michaelk99/IHP__MPC9724/ip/dsm2_core/doc/ota_fcasc2_README.md

# ihp-sg13cmos5l Fully Differential Folded Cascode OTA, Unit-Device Version

A fully differential folded cascode OTA with a PMOS input pair for the switched-capacitor integrator of the first-order delta-sigma battery monitor (1.5 V, 1.45 to 1.55 V, `fs = 1.024 MHz`, OSR 512, -40 to 125 °C). It is sized to the system-level design point (`C1 = 64 fF`, `C2 = 384 fF`, fanout 2), with every branch current an integer multiple of the 200 nA bias input and every device built from unit devices, so the layout can be drawn as unit arrays.

`ota_fcasc2` is a sibling of [`ota_fcasc_fd`](../ota_fcasc_fd/README.md), which keeps its older sizing (tail 800 nA, `L = 5 µm` bias stacks) because its layout is drawn by hand. The port list, the symbol and the split into blocks are the same, so `ota_fcasc2_top` is a drop-in replacement and the floorplan of the old layout maps onto it block by block. The layout is generated by a script, see [Layout](#layout).

The common-mode feedback is external: `vfb` drives the NMOS sinks and `vbn` brings out the matching bias voltage, so tying `vfb` to `vbn` biases the OTA open loop, as the testbenches do. `di_ena` switches the bias off.

| Pin | Direction | Function |
| --- | --- | --- |
| `vdd`, `vss` | inout | 1.5 V supply |
| `vi_p`, `vi_n` | input | differential input |
| `voutp`, `voutn` | output | differential output |
| `vfb` | input | common-mode feedback, gate of the NMOS sinks |
| `vbn` | output | NMOS sink bias voltage, tie to `vfb` for open-loop biasing |
| `ibias_200n` | input | 200 nA bias current sunk by the OTA, about 0.61 V at the pin |
| `di_ena` | input | enable, active high, edges of at least 30 ns at this pin |

| Cell | Content |
| --- | --- |
| `ota_fcasc2_top` | Top cell: the four blocks below plus ten `cap_dec` |
| `ota_fcasc2_dp` | PMOS input pair with its dummies |
| `ota_fcasc2_pbiascasc` | PMOS tail and loads with their cascodes, the wide-swing PMOS bias, enable switches |
| `ota_fcasc2_nbiascasc` | NMOS sinks (driven by `vfb`) and folded cascodes, the NMOS bias diodes, the sink of the PMOS reference, enable switches |
| `ota_fcasc2_ena` | Enable inverters, `d_ena` and `d_ena_b` from `di_ena` |
| `cap_dec` | Thick-oxide PMOS decoupling capacitor between `vdd` and `vss` |

## Topology

- **Input pair** `MP1`/`MP2`, 600 nA each, bulk on the tail node.
- **Tail** `MP3` with the cascode `MP10`, 1.2 µA. `ota_fcasc_fd` has no tail cascode. Here it keeps the tail current at the mirror ratio: the wide-swing bias puts the reference `MP8` at a small `V_SD`, and an uncascoded tail at 0.4 V would carry 6 % more.
- **PMOS loads** `MP4`/`MP5` with the cascodes `MP6`/`MP7`, 1.0 µA each.
- **NMOS sinks** `MN1`/`MN2` (1.6 µA each, gate `vfb`) take the pair current plus the output branch, the folded cascodes `MN3`/`MN4` carry 1.0 µA each.
- **NMOS bias**: the 200 nA input flows through the pass switch `MNSW5` into the stacked diodes `MN6` over `MN5`, which give `vcn` and `vbn`. The sinks then sit at `V_DS = V_GS(MN5)`, about 0.3 V. For LV NMOS at `gm/ID = 18` that is only 0.15 V above `V_dsat` plus margin, the lowest output is then about 0.4 V, and the modulator needs 0.505 V. The diode stack is kept: it needs no resistor, starts without help, and the larger `V_DS` raises the sink output resistance, which sets the gain.
- **PMOS bias, wide swing**: `MN7`/`MN8` sink a 200 nA copy from `MP8`/`MP9`. A stacked PMOS diode would put the load sources at `V_SD = V_SG`, about 0.4 V, and cap the output at about 1.0 V, exactly the 1.0 V the modulator swings to at 1.5 V, and below it at 1.45 V or in the slow corner. So `MPR`, a long PMOS in triode (`W = 0.5 µm`, `L = 10 µm`, gate on `d_ena_b`), drops about 60 mV between `vbp` and `vcp`, and the sources sit at about 0.1 V. `MPR` is off when disabled, so it is also the enable switch of that branch.
- **Enable**: `MNSW1`/`MNSW3`/`MNSW4` pull `vfb`, `vcn` and `vbn` to `vss`, `MPSW3`/`MPSW4` pull `vbp` and `vcp` to `vdd`, `MNSW5` and `MPR` open the two reference branches.
- **`di_ena` edges**: `di_ena` needs edges of at least 30 ns at the OTA pin. In the whole-OTA start-up bench (30 runs, sim) 3 ns edges take `MPEN0`, `MNEN0` and `MNEN1` to Vds 1.62 V and 1 ns edges to 1.69 V, with the gate oxide of several devices over 1.65 V. 10 ns edges stay below the 1.6 V Vds limit, 30 ns leaves a margin.
- **`MNC7` on `vd7`**: one NMOS unit (0.5/3) with its gate on `vd7` and source, drain and bulk on `vss`. While the OTA is off, `vcp` sits at `vdd` and `MN7`, `MN8` are off, so `vd7` floats and the enable edges kick it below `vss`. Without the cap `MN8` reached Vds 1.66 V in 14 of 30 start-up runs, over the 1.6 V limit (sim). With it the peak is 1.553 V and no LV device of the OTA exceeds 1.6 V Vds or 1.65 V gate oxide in the same 30 runs (peaks 1.593 V Vds on `MNEN1`, 1.615 V gate-drain on `MN8`, sim). In the layout it is a unit of R2, next to MN7.
- **Folding headroom**: `I_fold/I_tail` = 1.6/1.2 = 1.33, above the 1.2 guideline. The system-level design point sizes the output branch at `Id1`, which gives 1.0.

## Sizing

`scripts/sizing/size_ota_fcasc2.py` derives the system-level design point (settling budget, input pair, cascode stack, bias, power) from the 1 mV LSB on 1.5 V, OSR 512 and `H_inf` 1.2 loop with pygmid and the CMOS5L tables in `../ota_fcasc_fd/scripts/sizing/data/`, then evaluates the unit-device point and prints every device and every branch current. It needs `pygmid`, `numpy` and `deltasigma` (package `python-deltasigma`):

```sh
python macros/ota_fcasc2/scripts/sizing/size_ota_fcasc2.py              # the design
python macros/ota_fcasc2/scripts/sizing/size_ota_fcasc2.py --point current  # the sizing before the equal-L rule
python macros/ota_fcasc2/scripts/sizing/size_ota_fcasc2.py --compare    # model table of the equal-L candidates
```

The system-level leaky-integrator sweep is not rerun, its result (50 dB integrator gain) is taken as an input.

Every NMOS has the same L and every PMOS has the same L, so the layout can place each type as one array with straight columns. The input pair and `MPR` are the two exceptions. Unit devices, all `ng = 1`:

| Type | W (µm) | L (µm) | Current per unit | gm/ID (model) | Used by |
| --- | --- | --- | --- | --- | --- |
| NMOS, every device | 0.5 | 3 | 200 nA | 19.2 sources, 20.0 cascodes | `MN1` to `MN8`, `MNSW1`, `MNSW3`, `MNSW4`, `MNSW5`, `MND1`, `MND2`, `MNC7`, `MNEN0`, `MNEN1` |
| PMOS source | 1.0 | 2 | 200 nA | 17.9 | `MP3`, `MP4`, `MP5`, `MP8`, `MPSW3`, `MPD2`, `MPEN0`, `MPEN1` |
| PMOS cascode | 3.5 | 2 | 200 nA | 26.0 | `MP6`, `MP7`, `MP9`, `MP10`, `MPSW4`, `MPD3` |
| Input pair | 2.0 | 1 | 150 nA | 25.2 | `MP1`, `MP2`, `MPD1` |
| PMOS level shift | 0.5 | 10 | 200 nA | triode | `MPR` |

The common L was chosen in simulation, not from the model: the CMOS5L tables have L = 1, 5 and 10 µm only, so every lookup at 2, 3 or 4 µm is interpolated. Each candidate ran a 10-point worst-case screen with `bias_gm` as the reference, and the finalists ran the full 135-point sweep (see [Simulation Results](#simulation-results)). Worst case over the screen (over the 135-point sweep for the first and the chosen row), PMOS at 1/2 and 3.5/2, pair 2/1:

| NMOS units | A0 (dB) | tau (ns) | err_d (%) | swing (V) | PM (°) | Verdict |
| --- | --- | --- | --- | --- | --- | --- |
| sources 0.5/4, cascodes 1/2 (before) | 54.10 | 22.9 | 0.27 | 1.16 | 78.9 | two L per type |
| all 0.5/2 | 51.58 | 23.6 | 0.36 | 0 | 79.9 | fails gain at ff, 125 °C |
| sources 0.5/3, cascodes 1/3 | 53.57 | 21.0 | 0.29 | 1.15 | 73.0 | passes, two W |
| all 0.5/3 | 54.30 | 21.4 | 0.26 | 1.07 | 74.8 | chosen |
| sources 0.5/4, cascodes 1/4 | 55.47 | 17.5 | 0.23 | 1.10 | 65.7 | PM drops, cascode capacitance at the folding node |
| all 0.5/4 | 56.17 | 18.8 | 0.21 | 0.99 | 69.1 | swing at the limit |

On the PMOS side the cascode W is what matters, its L is already the source L. With every NMOS at 0.5/3, a cascode of 1/2 instead of 3.5/2 costs 1.8 dB of gain and the swing falls to 0.89 V, 2/2 costs 0.45 dB. PMOS at L = 1 µm (sources 0.5/1, cascodes 2/1) meets every limit over the 135-point sweep with the same margins as L = 2, needs no exception for the pair and would cut the PMOS gate area from 210.5 to 77.5 µm², but raises the bench noise from 923 to 1004 µVrms and the offset spread from 3.3 to 4.0 mV (40 runs), so the PMOS stay at L = 2. These noise numbers come from the earlier noise bench, whose noisy feedback resistors are in them and which is not comparable with the 416.5 µVrms of [Simulation Results](#simulation-results). The screen was not repeated. The pair at L = 2 µm (2/2) costs settling: tau worst case 29.7 ns against 30.5, swing 1.03 V, and the bench noise does not improve (945 µVrms), so the pair stays at `W = 2 µm`, `L = 1 µm`.

`MPR` works as a resistor, its L sets the drop. It is one device at `L = 10 µm`, the longest L the project allows. At 0.5/13 it dropped 82 mV and the PMOS sources sat at `V_SD` 0.121 V, at 0.5/10 it drops 62 mV and they sit at 0.105 V (sim, tt, 27 °C, 1.5 V). The gain at tt falls by 0.5 dB and every limit still holds, see [Simulation Results](#simulation-results).

| Device | Units | Current | Device | Units | Current |
| --- | --- | --- | --- | --- | --- |
| `MP1`, `MP2` | 4 each | 600 nA | `MN1`, `MN2` | 8 each | 1.6 µA |
| `MP3`, `MP10` | 6 each | 1.2 µA | `MN3`, `MN4` | 5 each | 1.0 µA |
| `MP4`, `MP5`, `MP6`, `MP7` | 5 each | 1.0 µA | `MN5`, `MN6` | 1 each | 200 nA (input) |
| `MP8`, `MP9`, `MPR` | 1 each | 200 nA | `MN7`, `MN8` | 1 each | 200 nA |
| `MPSW3`, `MPSW4` | 1 each | off | `MNSW1`, `MNSW3`, `MNSW4` | 1 each | off |
| `MPD1` | 2 | dummies | `MNSW5` | 1 | 200 nA (pass) |
| `MPD2`, `MPD3` | 48, 4 | dummies and bias decaps | `MND1`, `MND2` | 20, 27 | dummies and bias decaps |
| | | | `MNC7` | 1 | cap on `vd7` |
| `MPEN0`, `MPEN1` | 1 each | enable inverters | `MNEN0`, `MNEN1` | 1 each | enable inverters |

The dummies sit at the row ends and in the dummy rows around each array (see [Layout](#layout)), `MPD1` off on the tail node, the others with their gate on a bias line (`MPD2` vbp, `MPD3` vcp, `MND1` vbn, `MND2` vcn), so they also decouple it.

Summed gate area (`W·L`) per block, from the sizing script: `dp` 20 µm², `pbiascasc` 291 µm², `nbiascasc` 123 µm², `ena` 7 µm², `cap_dec` 10 × 4 µm² (HV). Per type: NMOS 126 µm² in 84 units of one size, PMOS 315 µm² (`MPR` 5 µm² and the pair 20 µm² included) in 2 sizes of L = 2 µm plus the pair and `MPR`. Of that, the dummies are 128 µm² of PMOS and 70.5 µm² of NMOS.

System-level point against the unit-device point (both gm/ID model numbers, from the script):

| | System level | Unit devices |
| --- | --- | --- |
| `Id1` | 631 nA | 600 nA |
| `I_tail` | 1.26 µA | 1.2 µA |
| Output branch | 631 nA | 1.0 µA |
| `I_fold/I_tail` | 1.0 | 1.33 |
| `beta` | 0.820 | 0.786 |
| `tau` | 15.3 ns | 17.7 ns |
| `A0` | 54.8 dB | 55.3 dB |
| Swing estimate (diff, pp) | 1.84 V | 1.60 V |
| Supply current | 3.15 µA | 3.40 µA, plus the 200 nA input |
| Power | 4.73 µW | 5.10 µW, plus 0.30 µW for the input |

Two notes on the system-level numbers:

- The system-level design evaluates `beta` at the target `wug`, before `gm_scale = 2` doubles the pair. With the `Cgg1` of the pair it actually sizes (41 fF), `beta` is 0.785, not 0.820, and `tau` is 17.7 ns rather than 15.3 ns. The settling testbench measures 0.785 and 16.2 ns.
- The OTA gain requirement is 51.7 dB, 50 dB of integrator gain over `beta` = 0.820, as the code computes. The system-level specification table says 53.3 dB with `beta` = 0.69, a leftover of the old capacitors. With the real `beta` of 0.785 the requirement would be 52.1 dB.

## Simulation Results

All numbers below are sanity checks of the schematic with ideal common-mode feedback and an ideal 200 nA source, not characterisation results.

Standalone testbenches at `tt`, 27 °C, 1.5 V, 200 nA, one run each (`make sim-xschem`):

| Testbench | Results |
| --- | --- |
| `ota_fcasc2_top_tb_tran` | `dcgain_dB` 58.27 dB, `tau_meas_ns` 16.29 ns, `err_d_percent` 0.170 %, `beta_meas` 0.785 (`Cgg1` 41.3 fF), swing 1.42 V, `I_fold/I_tail` 1.32, starved cascode back above half its current after 19 ns, power 5.40 µW with the input |
| `ota_fcasc2_top_tb_ac_ol` | `Adc_ol_dB` 58.84 dB, `UGB` 11.7 MHz with `CL + (1-beta)·C2` as load, `PM` 76.6° |
| `ota_fcasc2_top_tb_noise` | over 1 Hz to 1 kHz: `irn_tot_uVrms` 410.4 µVrms (closed-loop bench input, kT/C included), `vn_d_uVrms` 50.32 µVrms (open-loop differential input noise of the OTA, no kT/C) |

These include the dummy rows of 2026-10-19 (gates on vbp, vcn and vbn). Against the earlier dummy counts on the same image, tau moves from 16.23 to 16.29 ns, the cascode starvation from 18 to 19 ns and the power from 5.42 to 5.40 µW. The dummy gates' leakage onto the bias lines lowers the tail and fold currents by about 0.3 % (1.206 to 1.201 µA, 1.595 to 1.591 µA, sim), which is the likely cause (inference).

The bench's DC-feedback resistors R4 to R7 (1 GOhm and 6 GOhm) are `res_noisy` instances with `noisy=0`. As plain `res` instances they put their own thermal noise into the bench, which then read 923 µVrms.

`irn_tot` is the closed-loop bench number and measures neither the OTA alone nor the integrator. Of its 410.4 µVrms (the same with and without the dummy rows), flicker is 363 µVrms, the gate leakage shot noise of the input pair into the 1 GOhm resistors 190 µVrms and thermal noise 19 µVrms (sim, `make sim-xschem TB=ota_fcasc2_top_tb_noise`, report `plot_simulations/data/ota_fcasc2_top_tb_noise_closed_loop_summary.txt`). `vn_d_uVrms` is the figure for the integrator. It is the open-loop differential input noise of the OTA in the same band, from the same netlist with C1 set to 1 F so that both gates are ac grounded (the report is `..._vn_d_summary.txt`). It is flicker dominated and splits evenly over the pair (21.0 µVrms each), the NMOS sinks (20.3) and the PMOS loads (20.3), every other device is below 1 µVrms. The integrator refers it to its input with 1/2, which gives 25.2 µVrms. The `sc_int2` pnoise read 26.6 µVrms for the OTA with the earlier 0.5/13 `MPR`, it was not rerun. The 288.7 µVrms budget less the switches' 10.6 µVrms allows `vn_d` up to 577 µVrms with that referral (model), the worst PVT corner reads 63.0 µVrms (sim), a margin of 19 dB. The 290 µVrms limit on `irn` is the continuous-time map of the bench number and fails by design.

Operating point at the same conditions, before the dummy rows (not rerun, the branch currents have moved by 0.3 % since): `vbn` 0.285 V, `vcn` 0.605 V, `ibias_200n` 0.611 V, sinks at `V_DS` 0.29 V, PMOS sources at `V_SD` 0.105 V, `MPR` drop 62 mV. Simulated gm/ID: input pair 25.4, NMOS sinks 17.1, NMOS cascodes 17.2, PMOS sources 15.4 (at the edge of saturation, `V_SD` 0.105 V against `V_dsat` 0.136 V), PMOS cascodes 23.2.

CACE (`make sim-cace`, last run as the noise and tran sets with one job, `cace ota_fcasc2_top.yaml -j 1 -p ...`), 45 PVT conditions per set (5 corners, 3 supplies, 3 temperatures), min / typical / max. All 45 runs of each transient and noise set are measured (45 data files each, no tau or swing fallback value):

| Result | Limit | Schematic |
| --- | --- | --- |
| A0 | ≥ 51.73 dB | 53.44 / 58.27 / 60.29 dB |
| Settling error at `Ts/2` | ≤ 0.32 % | 0.136 / 0.171 / 0.284 % |
| Tau | ≤ 30.5 ns | 13.0 / 16.3 / 23.8 ns |
| Output swing | ≥ 0.98 V | 1.20 / 1.41 / 1.61 V |
| Power | ≤ 10 µW | 4.74 / 5.40 / 5.61 µW |
| IRN | ≤ 290 µVrms | 329.3 / 410.4 / 631.0 µVrms, fails |
| Vn,d | any | 40.5 / 50.3 / 63.0 µVrms |

The PEX rows come from the extracted layout and are listed in [Layout](#layout).

Local mismatch, 100 runs at `tt_mismatch`, 27 °C, 1.5 V, all measured, before the dummy rows (not rerun): A0 57.1 to 59.2 dB, offset -8.7 to 6.3 mV, tau 13.5 to 19.4 ns, swing 1.37 to 1.45 V. The settling error reaches 4.3 % because it carries the offset. In a separate 40-run set with the same seeds for both sizings the offset standard deviation is 3.3 mV, against 2.8 mV with the 0.5/4 sinks of the earlier sizing. The sinks have a quarter less gate area.

Bias current spread of the reference, standalone testbenches at `tt`, 27 °C, 1.5 V, before the dummy rows (not rerun, the 200 nA column is the old version of the table above):

| `ibias_200n` | 136 nA (0.68x) | 200 nA | 308 nA (1.54x) |
| --- | --- | --- | --- |
| `dcgain_dB` (tran) | 57.66 dB | 58.27 dB | 59.10 dB |
| `Adc_ol_dB` (ac) | 58.38 dB | 58.85 dB | 59.57 dB |
| `UGB`, `PM` | 8.5 MHz, 78.6° | 11.7 MHz, 76.6° | 16.4 MHz, 74.3° |
| `tau_meas_ns` | 22.8 ns | 16.2 ns | 11.3 ns |
| `err_d_percent` | 0.179 % | 0.170 % | 0.158 % |
| Swing | 1.53 V | 1.42 V | 1.28 V |
| Cascode starvation | 24 ns | 18 ns | 13 ns |
| Power with the input | 3.69 µW | 5.42 µW | 8.33 µW |
| IRN | 408.7 µVrms | 410.4 µVrms | 416.2 µVrms |
| Vn,d | 50.7 µVrms | 50.3 µVrms | 50.3 µVrms |

All nine runs converged without help.

At 0.68x and 1.45 V over the five corners and three temperatures (15 runs, all measured, before the dummy rows), 125 °C is the weak spot: tau is 30.6 to 35.5 ns, above the 30.5 ns budget, and at `ff` the gain falls to 51.07 dB, below 51.73 dB, so the swing criterion is never met there (reported as 0). The settling error at `Ts/2` stays at or below 0.37 %, since 35 ns is still 14 time constants in `Ts/2`. A constant-gm reference does not deliver 0.68x at 125 °C, see below.

With `bias_gm` (`ota_fcasc2_top_tb_biasgm`, `scripts/sweep_biasgm.py`), sanity checks like the rest: the bench is `tb_tran` with the ideal source replaced by the constant-gm reference, `di_ena` and VDD shared with the OTA, and the power now includes `bias_gm`. The numbers below use the `bias_gm` schematic of commit 62fca54, `MPR` at 0.5/10 and the dummy counts before 2026-10-19 (not rerun). With `bias_gm` as committed in 24cfc4c and the dummy rows, the bench gives tau 16.74 ns at tt, 27 °C, 1.5 V (16.69 ns with the earlier dummy counts, sim). The sweep is 5 MOS corners x 3 rppd corners x -40/27/125 °C x 1.45/1.5/1.55 V, 135 runs, plus an open-loop ac run with `bias_gm` at every condition for the phase margin. All 135 transient runs are measured without a convergence aid, five ac runs needed `rshunt` to leave a half-started reference. All limits hold in every run:

| Result | Limit | Worst | At | Typical (tt, typ, 27 °C, 1.5 V) |
| --- | --- | --- | --- | --- |
| A0 | ≥ 51.73 dB | 53.54 dB | ff, wcs, 125 °C, 1.45 V | 58.19 dB |
| Tau | ≤ 30.5 ns | 23.3 ns | ff, wcs, 125 °C, 1.45 V | 16.87 ns |
| Settling error at `Ts/2` | ≤ 0.32 % | 0.284 % | ff, wcs, 125 °C, 1.45 V | 0.172 % |
| Output swing | ≥ 0.98 V | 1.076 V | ss, bcs, 125 °C, 1.45 V | 1.43 V |
| Power with `bias_gm` | ≤ 10 µW | 9.76 µW | ss, bcs, 125 °C, 1.55 V | 6.00 µW |
| Phase margin (open loop) | | 74.9° | sf, bcs, 125 °C, 1.55 V | 76.8° |

The reference current into the OTA is 123.7 to 305.6 nA (0.62x to 1.53x) and the bias pin sits at 0.377 to 0.789 V. The current rises with temperature (123.7 to 194.7 nA at -40 °C, 203.2 to 305.6 nA at 125 °C), so the 0.68x at 125 °C case of the ideal-source test does not occur, and tau is 13.3 to 19.6 ns at -40 °C, 14.0 to 20.2 ns at 27 °C and 14.7 to 23.3 ns at 125 °C. Power has the smallest margin, 9.76 µW is 98 % of the limit with 305 nA from the reference, and the lowest swing, 1.08 V, is at the same corner and 1.45 V. With `MPR` at 0.5/13 and the same `bias_gm` the worst A0 is 53.86 dB and the worst settling error 0.275 %, the other worst cases agree within 0.05 ns, 1 mV, 0.01 µW and 0.1°.

Enable sequencing, 7 corners, VDD ramped over 100 µs with `di_ena` low and `di_ena` raised at 200 µs, input steps every 5 µs after it, with `bias_gm` as committed in 24cfc4c and the dummy rows. The reference leaks at most 5.6 nA while off (ff, wcs, 125 °C, 1.45 V). After the rise the closed-loop step response is valid (tau at or below 30.5 ns and within 5 % of its final value) from 35 µs at tt, 27 °C, 1.5 V and from 130 µs at ss, -40 °C, 1.45 V with typical and with bcs resistors, the slowest corners (resolution 5 µs). The other four corners are valid from 35 to 40 µs. The earlier dummy counts give the same times within the 5 µs resolution (30 instead of 35 µs at ff, wcs, 125 °C and at sf, wcs, 125 °C). With the `bias_gm` of 62fca54 the slowest corner was valid from 55 µs, so the longer time comes from the reference, not from the OTA. The ideal CMFB of the bench holds the output common mode throughout, so the common mode itself says nothing about the OTA.

## Layout

`layout/ota_fcasc2_top.gds` is written by the generator `layout/ota_fcasc2_gen.py` (KLayout Python, live `SG13_dev` PCells, helpers in `macros/scripts/lay_helpers.py`). Regenerate it with `make layout`, never edit the GDS by hand. `PLACE_ONLY=1` writes the placement without routing. The blocks are cells `ota_fcasc2_<block>_blk` inside the top. Their names differ from the schematic subcircuits on purpose, so LVS compares the macro flat.

The macro is 63.83 x 24.44 µm (1560 µm²). Before the dummy rows and row-end dummies of 2026-10-19 it was 63.83 x 18.505 µm (1181 µm²), the first generated layout 59.44 x 52.13 µm (3099 µm²), and `ota_fcasc_fd` is 47.785 x 110.5 µm (5280 µm²).

One vertical axis runs through the middle of the macro. Every block is a 2D array of one unit size, the right half the mirror image of the left (the nets may differ), and the build fails unless Activ, GatPoly, Cont, pSD, NWell and Metal1 XOR to zero against their mirror image. Seven allow-listed Metal1 boxes differ: the vp8 straight column of MP8/MP9 and the vdd straight column of MPSW3/MPSW4, whose mirror partners join two nets, the MPSW3 drain drop, and the R2 axis dummy's column up to R1, whose image is the vfb drain of MNSW1.

Every array has a dummy at both ends of each row and a dummy row above and below, full units where the devices are matched. A dummy row is one strip: its Activ (and pSD) runs on across the breaks of the row it copies, since all its columns carry one net.

Floorplan, top to bottom:

| band | content |
| --- | --- |
| band X | decap (five `cap_dec` per side as one HV PMOS of four 1.25 µm fingers), MPEN0, MPR 0.5/10 on the axis, MPEN1 |
| P0 | dummy row, 22 MPD2 units 1/2 on P1's columns, gate vbp |
| P1 / P2 | source row of 22 units 1/2 over the cascode row of 22 units 3.5/2, `D D 8 333 4 55 44 \| 55 44 5 333 SW D D`. Unit k of P1 feeds unit k of P2 through one straight Metal1 column |
| P3 | dummy row, 22 MPD2 units 1/2 on P2's columns (the cascodes' L, the narrow unit), gate vbp |
| rings | nwell ring band (vdd), psub band (vss) |
| R0 | dummy row, 16 MND2 units 0.5/3 on R1's columns, gate vcn |
| R1 | cascodes across the axis, `D2 C C C C C D2 D2 \| D2 D2 C C C C C D2` |
| R2 | bias singles across the axis, `D2 MN6 MNSW3 MN5 MNSW4 MNEN0 D2 D2 \| D2 MNSW1 MNEN1 MNC7 MN7 MN8 MNSW5 D2` |
| R3, R4 | MN1/MN2 core, `MND1 A A B B MND1` per wing, the input pair between the wings in its itail NWell |
| R5 | dummy row, 6 MND1 units per wing on R4's columns, gate vbn |

- Every NMOS is one 0.5/3 unit. R1 and R2 run across the axis, R3 to R5 are split into two wings around the input pair, which keeps the pair's window only as tall as the pair. Over the pair only R2's axis dummies and MNSW1 face it.
- Input pair: `D A A B B | B B A A D` with A = MP1, B = MP2 and the MPD1 dummies on both ends, 2 µm fingers.
- MN1/MN2: the right wing is the pure mirror image of the left, so both devices have their centroid on the axis and in the middle of R3/R4, and every drain column runs straight through both rows. MND1 ends each core row, and the core rows are continuous strips.
- MN3 (left) and MN4 (right) are mirror images in R1, sources toward the axis. MP4/MP5 and MP6/MP7 run in the groups `4 | 55 | 44 || 55 | 44 | 5`.
- R2 shares diffusion where the nets allow it on both sides: left vcn (MN6/MNSW3), vss, vbn, right vd7 (MN8/MN7), vss, and vss on the axis.
- Gates: R3/R4 share one strap in their gap, R1 and R0 share one vcn strap, R2 has a strap per unit under the row, R5 one strap per wing under the row, P1 a deep strap under the row, P2 a strap over it, P3 a strap over it, P0 a strap under it.
- Routing runs over the arrays, there is no routing channel. Metal1 for the device columns, their straight extensions, pads and the supply bars (all mirror symmetric, a pad without a via on one side is the image of a real landing on the other). Metal2 tracks over the rows (vfb, vbn, vcn, the vout tracks over R0 and over P2, d_ena_b and d_ena over the psub band). Metal3 verticals. Metal4 for the vd1/vd2 buses, the vd7 link from MNC7 to the MN7/MN8 column, and the pins. Every via landing has two cuts.
- vd1 and vd2: an upper Metal4 bus on the cascode sources (vd1 left, vd2 right), one Metal3 drop each over R2's axis dummies, and two lower Metal4 buses across the core and the pair. The lower buses swap levels at the axis (vd1 on Metal4 at x = 0, vd2 on Metal3), because one level runs over R4 and the other over the R3/R4 gap, and straight buses gave the net over R4 0.94 fF more to vss in both Magic and kpex.
- A third net that passes one output passes the other the same way: the vcp riser from MN8 and its jog have a vcn image on the left, the MNSW3 and MNSW5 gate risers have vcn images from the MN8 and MN6 gates, the MNSW4 gate riser has the MNC7 gate (vd7) as its image, the d_ena_b track spans both vout tracks, and d_ena has a dead mirror image over voutp. Pair balance in the build, metal area per node and layer: voutp/voutn and vi_p/vi_n within 3 %, vd1/vd2 within 5 % summed over the layers.
- Supplies: one nwell ring on vdd around the PMOS area and one psub ring on vss at the macro edge. They carry no `well`/`sub!` text and no supply runs along them. vss arrives on two Metal3 trunks that land on the vss bar under R5, which stops at the pair window so that vi_n, whose strap sits just over it, sees no more vss than vi_p. vdd arrives on the vdd bar over P0, and P1's vdd columns run through P0. Each ring is only tied to its bar. The dummy strips R0 and P3 have their own 0.16 µm bars, R0 on vss through R1's dummy columns, P3 on vdd through P2's outer dummy columns.
- Pins are on Metal4, vbn on Metal3 in the left side strip (the image of ibias_200n on the right). vss has a Metal4 port on each trunk. One NoMetFiller rectangle covers the whole macro, prBoundary (189/0) marks it.

The generator stops on: the mirror XOR, finger counts per row, the NMOS unit count per device, the net of every shared column, a bridge between two nets, shapes of different nets closer than their layer spacing, off-grid vertices, lone vias, labels outside their pin, shapes outside the boundary, pair balance, and an empty area over 8 % (outline minus Activ, GatPoly, Cont, Metal1 to Metal4 grown by 0.25 µm, 4.0 % now). `CHECK_CONTROL=1 make layout` proves that a failing check stops the target.

`make klayout-lvs` runs `run_lvs.py` directly in deep mode with tap extraction on (`sak-lvs.sh` would add `--disable_tap_extraction`), and the netlists match. MPD1, the input pair dummy with all four terminals on the tail, is declared in the LVS netlist like every other dummy. `make magic-lvs` matches as well. Both pass in `registry.iic.jku.at:5000/iic-osic-tools:next` (image bb525d654d8d). KLayout DRC is clean at the macro level, at the regular level (antenna included) only the chip-level density rules M1.j to M4.j and TM1.c remain, as on the previous layout, and Magic DRC is clean. The 2026.08 image deletes a MOS with every terminal on one net from the layout netlist (`purge_devices` in its RF MOS mapping step), so there KLayout LVS fails on MPD1. Netgen never deletes it.

`make magic-pex` runs Magic twice. `sak-pex.sh` writes with `ext2spice lvs`, whose hierarchical output moves substrate capacitance onto the wrong nets. The target reruns the same Magic script with `ext2spice hierarchy off`, which gives each net its own substrate capacitance back. With `EXT_MODE=3` the full-RC run books the coupling of every net with a resistor network a second time as capacitance to `vss` (magic#557). So the target also extracts the same layout in mode 2 (`netlist/pex/ota_fcasc2_top_magic_raw_2.spice`, reused while it is newer than the GDS), and `../scripts/pex_rc_caps.py` scales every capacitor between two nets of the full-RC netlist to the mode 2 total of that pair. Resistors and devices stay as Magic wrote them.

Post-layout check, the benches with the DUT on `ota_fcasc2_top_pex` (Magic, `make magic-pex`, full RC, hierarchy off, pair correction), tt, 27 °C, 1.5 V, one run each, none failed to measure, ngspice in `registry.iic.jku.at:5000/iic-osic-tools:next`. The right column is the committed state before the rework (old dummy counts, old GDS) run on the same image. These are sanity checks, not characterisation:

| quantity | schematic | Magic PEX | before: schematic / Magic PEX |
| --- | --- | --- | --- |
| dcgain (dB) | 58.27 | 58.20 | 58.27 / 58.23 |
| vos (µV) | 0.00 | 4.63 | 0.00 / 2.86 |
| tau (ns) | 16.29 | 16.90 | 16.23 / 17.02 |
| err_d (%) | 0.170 | 0.175 | 0.170 / 0.176 |
| swing (V) | 1.420 | 1.420 | 1.420 / 1.419 |
| power (µW) | 5.40 | 5.40 | 5.42 / 5.42 |
| Adc_ol (dB) | 58.84 | 58.84 | 58.85 / 58.85 |
| UGB (MHz) | 11.67 | 10.99 | 11.71 / 11.05 |
| PM (°) | 76.6 | 75.0 | 76.6 / 75.5 |
| IRN (µVrms) | 410.4 | 410.9 | 410.4 / 410.9 |
| Vn,d (µVrms) | 50.32 | 50.33 | 50.32 / 50.32 |
| tau with `bias_gm` (ns) | 16.74 | 17.36 | 16.69 / 17.51 |

The `bias_gm` row uses `bias_gm` as committed in 24cfc4c for both columns. In the schematic the new dummy rows load the bias lines (vbp +88 µm² of gate, vcn +36 µm², vbn +18 µm², vcp nothing new), which moves tau by +0.06 ns, the UGB by -0.04 MHz and the power by -0.02 µW (sim). The 4.6 µV offset of the Magic view comes from its vss resistor network, which Magic writes differently on each run (1.7 to 2.9 µV seen before). With a PEX DUT, `cgg_meas_fF` counts about 12 fF of output wiring as gate capacitance, so `beta_meas` reads 0.766 where the schematic gives 0.785.

Over the 45 PVT conditions of the CACE sets (`cace ota_fcasc2_top.yaml -j 1 -p tran_params tran_pex_params`, and the same for noise) the PEX set gives A0 53.40 / 58.20 / 60.19 dB, tau 13.44 / 16.89 / 24.79 ns, err_d 0.140 / 0.175 / 0.290 %, swing 1.200 / 1.407 / 1.605 V and power 4.74 / 5.40 / 5.61 µW (min / typ / max), all within the limits (before: A0 53.45 / 58.27 / 60.28 dB, tau 13.58 / 17.03 / 24.94 ns, err_d 0.289 % worst). The schematic set gives A0 53.44 / 58.27 / 60.29 dB, tau 12.98 / 16.28 / 23.80 ns, err_d 0.284 % worst, swing 1.201 / 1.408 / 1.606 V, power 4.74 / 5.40 / 5.61 µW. All 45 runs of each of the four sets wrote their data. The IRN limit fails on both sets as designed, IRN is 329.8 / 410.9 / 631.5 µVrms and Vn,d 40.5 / 50.3 / 63.0 µVrms over the PEX set (schematic 329.3 / 410.4 / 631.0 and 40.5 / 50.3 / 63.0).

With the dummy rows on the bias lines the whole-OTA start-up bench (30 runs, 10 ns `di_ena` edges, VDD ramps of 10 and 100 µs, 5 corners, 3 temperatures, 1.55 V) keeps every LV device under 1.6 V Vds and 1.65 V gate oxide: MNEN1 1.592 V Vds, MN8 1.571 V (1.553 V before), MPR 1.600 V gate-drain (sim). The enable sequencing runs (7 corners, `scripts/sweep_biasgm.py`) give the same valid times as the old dummy counts within the 5 µs resolution, and the final tau moves by at most 0.13 ns (sim, both with `bias_gm` of 24cfc4c).

Extracted wiring capacitance per node, all neighbours summed, Magic with hierarchy off and the pair correction (KLayout kpex 2.5D in brackets): voutp/voutn 12.75/12.75 fF (12.32/12.33), vi_p/vi_n 4.03/3.97 fF (4.03/4.06), vd1/vd2 9.86/10.21 fF (9.49/9.74), vp4/vp5 7.90/7.90 fF (7.77/7.76). The outputs couple 0.86 fF to each other, vd1 and vd2 3.67 fF. To vss: vd1/vd2 1.62/1.65 fF (1.24/1.22), voutp/voutn 0.64/0.63 fF. vd2 carries the twist's Metal3 crossing and its two via stacks, which is most of its 0.35 fF over vd1. vi_n sees 1.02 fF of vss (the bar ends and the ring band under its strap) where vi_p sees 0.61 fF, and vi_p sees 0.54 fF of vcn (R2's dummy straps over its strap) where vi_n sees 0.05 fF, both static nets. A plain `sak-pex.sh` run without the hierarchy-off rerun moves several fF of substrate capacitance onto single nets. Take wiring numbers only from `make magic-pex`.

The dead d_ena track over voutp is a Metal2 piece with no connection, so both extractors give one net with capacitors only. `pex-mixed` anchors it to ground with 1 TOhm. Without that anchor the operating point is singular and the KLayout view settled at 25 µW.

Current density, by hand with every wire carrying the whole macro current (6.3 µA bound, from the 9.64 µW CACE maximum at 1.55 V): the worst ratio is 0.039 of the limit, on a 0.16 µm PCell Metal1 column. One contact is at 0.021, the vss and vdd bars (0.40 µm Metal1) at 0.016, the 0.29 µm Metal2/Metal3 tracks and trunks at 0.011, the two-cut vias at 0.008. No device current flows through a ring or through the 0.16 µm dummy bars.

## Testbenches and CACE

The Makefile, the testbench mechanics and the CACE flow are those of `ota_fcasc_fd`, see its [README](../ota_fcasc_fd/README.md) for every target. What differs:

- `make sim-cace CACE_JOBS=3` limits CACE to three parallel simulations (empty uses every core).
- `sim-cace` runs CACE with `--nofail`, so the noise set, which fails by design, does not stop the chain before the transient sets. The summaries still mark it as failing.
- The settling testbench and its CACE templates also run an operating point (supply power) and a closed-loop dc sweep (output swing) before the transient. The swing is the differential output range over which the incremental gain `d(vod)/d(vvg)` stays above 51.73 dB. Its limit is 0.98 V, twice the 0.491 V peak integrator state of the ideal modulator at -0.5 dBFS. The system-level `vod_swing_design` (1.84 V) is a saturation estimate with `V_dsat + 50 mV` on every device, not a gain criterion, and is quoted in the datasheet description only.
- The CACE limits follow the system-level design point: `dcgain` ≥ 51.73 dB, `tau` ≤ 30.5 ns, `err_d` ≤ 0.32 % (the static error `1/(1+beta·A0)` at the gain limit), power ≤ 10 µW. The IRN limit stays at 290 µVrms, the continuous-time map of the closed-loop bench number, so the gap to it keeps showing. `vn_d` has no limit until the integrator budget is final.
- The noise testbench and its CACE templates run three `noise` analyses: the closed-loop bench (`irn`), a wide-band one for the plot, and an open-loop one with C1 altered to 1 F (`vn_d`). xschem's `res.sym` does not write `noisy=` to the netlist, `res_noisy.sym` does. The bench writes a Spectre-style device noise summary per band run with `macros/scripts/noise_summary.py`, which needs the last argument of `noise` (`pts_per_summary`) set to 1 so that ngspice keeps the per-source contributions.
- The settling and `bias_gm` benches subtract the virtual ground before the step, the input offset, from the gain measure, as the CACE templates do, and print it as `vos_uV`. The I_fold/I_tail and cascode starvation lines read device currents by their schematic path, so with the PEX DUT they are skipped with a message.
- Conditions: `ss`/`sf`/`tt`/`fs`/`ff`, 1.45/1.5/1.55 V, -40/27/125 °C.
- `Acl` and `beta` are read from the capacitors in the benches, not typed in. The enable input of every bench and template and the supply of the ac bench follow `vdd`.
