michaelk99/IHP__MPC9724/ip/dsm2_core/doc/sc_int2_README.md

# Switched-Capacitor Integrator with ota_fcasc2

The first integrator of the delta-sigma modulator: the shared-capacitor SC network of Figure 7.11, the folded cascode OTA and the switched-capacitor common-mode feedback, wired into one block. Schematic and layout, see [Layout](#layout).

`sc_int2` is `sc_int` with the OTA swapped and the capacitors made real. The OTA instance `xamp1` is `ota_fcasc2_top` instead of `ota_fcasc_fd_top`, which has the same ten pins in the same places, so position, pins and wiring are untouched. The ideal `capa` capacitors are `cap_cmomf` units and `cmfb_sc` is replaced by its copy `cmfb_sc2`, see [Capacitors](#capacitors). `sc_int` keeps `ota_fcasc_fd_top`, `cmfb_sc` and its ideal capacitors because the course modulator `macros/dsm` uses it. Everything else is a renamed copy: switches, clocks and the testbenches.

## Ports

| Port | Direction | Meaning |
| --- | --- | --- |
| `vi` | in | single-ended input, referred to `vdd/2` |
| `vo_p`, `vo_n` | out | integrator outputs |
| `di_q`, `di_q_b` | in | the quantizer decision and its complement, which steer the DAC |
| `di_phi1`, `di_phi2` | in | the two non-overlapping clock phases, generated outside this block, inverted inside by `inv_lv` into `d_phi1_b`, `d_phi2_b` |
| `vcm` | in | common-mode reference for the right plates and for the CMFB |
| `ibias_200n`, `di_ena` | in | OTA bias current and enable |
| `vdd`, `vss` | inout | supply, and the DAC levels |

Net names follow the designer's etiquette (`v` voltage, `i` current, `d` digital, `di_`/`do_` on block pins, `_b` complement). Inside, the C1 plates are `vc1l_p`, `vc1r_p`, `vc1l_n`, `vc1r_n` and the DAC switch middle nodes `vh_p`, `vl_p`, `vh_n`, `vl_n`. `sc_int` keeps the course names (`v`, `v_b`, `vphi1`, `vphi2`). The symbol has no parameters. The capacitor values come from the unit counts in [Capacitors](#capacitors), `a1 = 2*C1/C2 = 1/3` as in the system-level loop.
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
