michaelk99/IHP__MPC9724/ip/dsm2_core/doc/vcm_gen_README.md

# Switched-Capacitor Common-Mode Reference

A 2:1 switched-capacitor divider that makes `vcm = vdd/2` for `sc_int2` and `dsm2_core` out of the clock phases `clk_noverlap` already makes. **Schematic, testbenches and layout (DRC and both LVS clean), no CACE datasheet yet.** Every number below is a sanity check from one or a few runs of the benches, not a characterisation.

## Ports
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
