michaelk99/IHP__MPC9724/macros/dsa1_dig/render/img/dsa1_dig_top_white.png

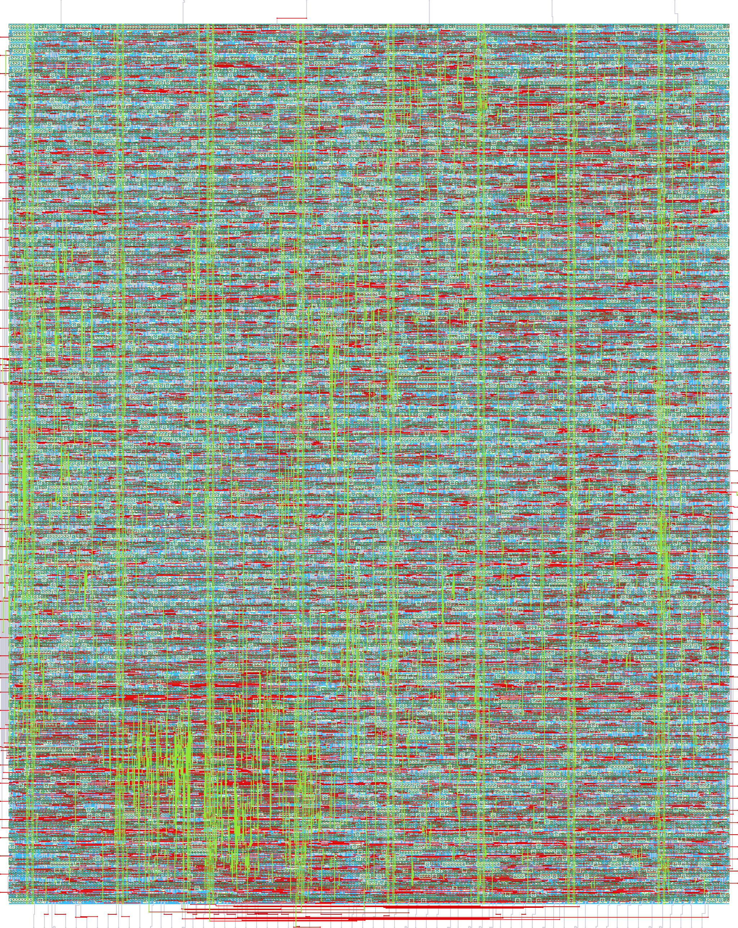
macros/dsa1_dig/render/img/dsa1_dig_top_white.png
