michaelk99/IHP__MPC9724/packaging/render/sg13cmos5l_dsa1_dig_top_bondplan_black.png

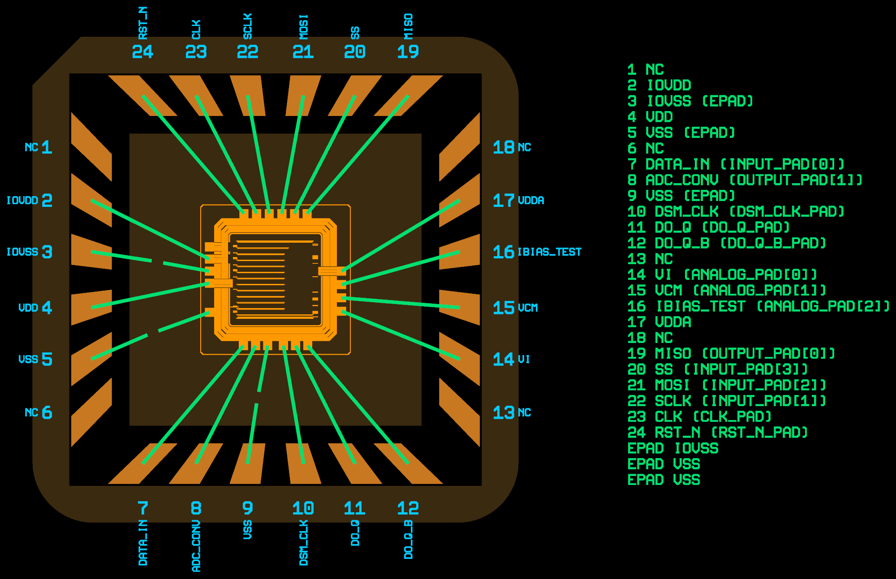
packaging/render/sg13cmos5l_dsa1_dig_top_bondplan_black.png
