michaelk99/IHP__MPC9724/release/v.1.2.1/img/sg13cmos5l_dsa1_dig_top_black_TM1.png

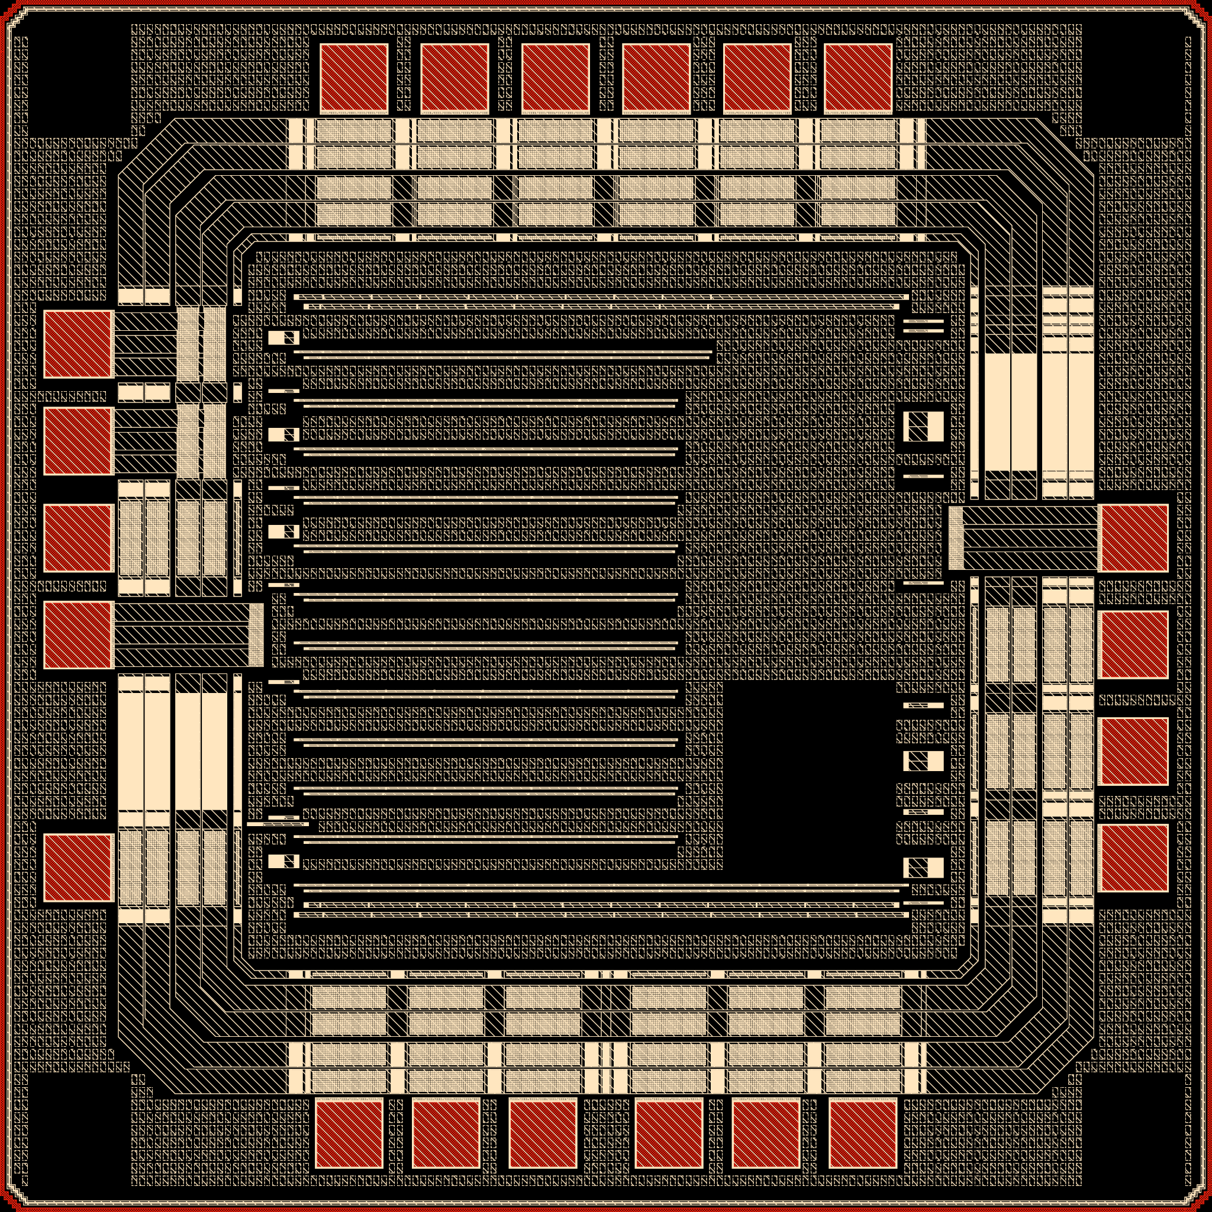
release/v.1.2.1/img/sg13cmos5l_dsa1_dig_top_black_TM1.png
