michaelk99/IHP__MPC9724/release/v.1.2.1/img/sg13cmos5l_dsa1_dig_top_librelane.png

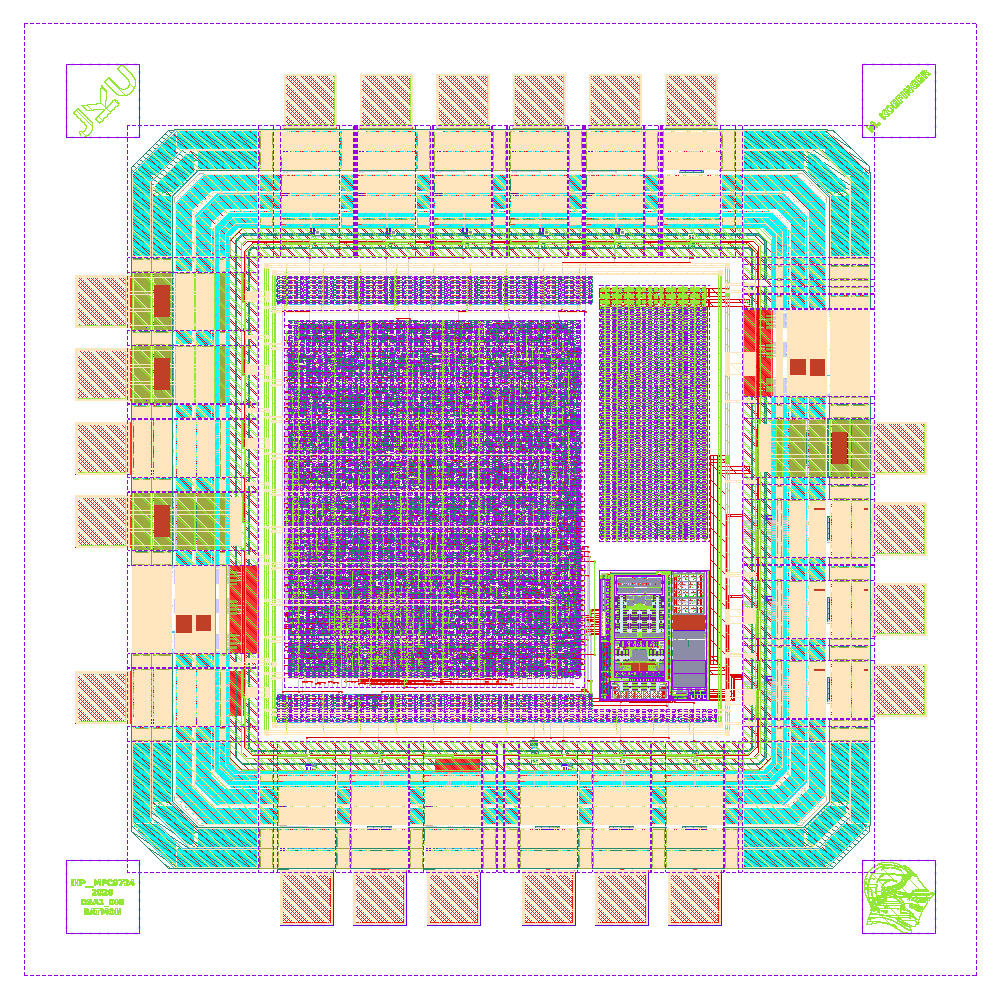
release/v.1.2.1/img/sg13cmos5l_dsa1_dig_top_librelane.png
