michaelk99/IHP__MPC9724/verification/em/em_table.md

| Net | Layer | Worst element | Count | I (mA) | Source of I | Limit (mA) | Ratio |
|---|---|---|---:|---:|---|---:|---:|
| VDD | Metal1 | followpin 0.32 um | 12 | 0.02083 | net / 12 rails | 0.32 | 0.0651 |
| VDD | Metal4 | stripe 1.00 um | 23 | 0.25 | whole net | 2 | 0.125 |
| VDD | TopMetal1 | stripe 2.00 um | 15 | 0.25 | whole net | 30 | 0.00833 |
| VDD | Via1 | 2-cut array | 114 | 0.25 | whole net | 0.8 | 0.312 |
| VDD | Via2 | 2-cut array | 114 | 0.25 | whole net | 0.8 | 0.312 |
| VDD | Via3 | 2-cut array | 114 | 0.25 | whole net | 0.8 | 0.312 |
| VDD | TopVia1 | 1-cut array | 142 | 0.25 | whole net | 1.4 | 0.179 |
| VSS | Metal1 | followpin 0.32 um | 12 | 0.02083 | net / 12 rails | 0.32 | 0.0651 |
| VSS | Metal3 | stripe 2.00 um | 10 | 0.25 | whole net | 4 | 0.0625 |
| VSS | Metal4 | stripe 1.00 um | 23 | 0.25 | whole net | 2 | 0.125 |
| VSS | TopMetal1 | stripe 2.00 um | 33 | 0.25 | whole net | 30 | 0.00833 |
| VSS | Via1 | 2-cut array | 117 | 0.25 | whole net | 0.8 | 0.312 |
| VSS | Via2 | 2-cut array | 117 | 0.25 | whole net | 0.8 | 0.312 |
| VSS | Via3 | 2-cut array | 245 | 0.25 | whole net | 0.8 | 0.312 |
| VSS | TopVia1 | 1-cut array | 177 | 0.25 | whole net | 1.4 | 0.179 |
| VDDA | Metal3 | stripe 10.00 um | 4 | 1 | whole net | 20 | 0.05 |
| IOVDD | none | no routing at chip level | 0 | 1 |  | - | - |
| IOVSS | none | no routing at chip level | 0 | 1 |  | - | - |
| *clk_PAD* | Metal2 | wire 0.20 um | 26 | 0.0004 | whole net | 0.4 | 0.001 |
| *clk_PAD* | Metal3 | wire 0.20 um | 19 | 0.0004 | whole net | 0.4 | 0.001 |
| *clk_PAD* | Via1 | 1-cut array | 20 | 0.0004 | whole net | 0.4 | 0.001 |
| *clk_PAD* | Via2 | 1-cut array | 21 | 0.0004 | whole net | 0.4 | 0.001 |
| i_sg13cmos5l_dsa1_dig_core.miso | Metal2 | wire 0.20 um | 2 | 0.00012 | whole net | 0.4 | 0.0003 |
| i_sg13cmos5l_dsa1_dig_core.miso | Metal3 | wire 0.20 um | 4 | 0.00012 | whole net | 0.4 | 0.0003 |
| i_sg13cmos5l_dsa1_dig_core.miso | Via2 | 1-cut array | 5 | 0.00012 | whole net | 0.4 | 0.0003 |

max ratio: 0.312, VDD Via1 2-cut array
PASS
