michaelk99/IHP__MPC9724/macros/dsa1_dig/verification/em_table.md

| Net | Layer | Worst element | Count | I (mA) | Source of I | Limit (mA) | Ratio |
|---|---|---|---:|---:|---|---:|---:|
| VDD | Metal1 | followpin 0.32 um | 70 | 0.003571 | net / 70 rails | 0.32 | 0.0112 |
| VDD | Metal4 | stripe 1.00 um | 10 | 0.25 | whole net | 2 | 0.125 |
| VDD | Via1 | 2-cut array | 700 | 0.25 | whole net | 0.8 | 0.312 |
| VDD | Via2 | 2-cut array | 700 | 0.25 | whole net | 0.8 | 0.312 |
| VDD | Via3 | 2-cut array | 700 | 0.25 | whole net | 0.8 | 0.312 |
| VSS | Metal1 | followpin 0.32 um | 71 | 0.003521 | net / 71 rails | 0.32 | 0.011 |
| VSS | Metal4 | stripe 1.00 um | 10 | 0.25 | whole net | 2 | 0.125 |
| VSS | Via1 | 2-cut array | 710 | 0.25 | whole net | 0.8 | 0.312 |
| VSS | Via2 | 2-cut array | 710 | 0.25 | whole net | 0.8 | 0.312 |
| VSS | Via3 | 2-cut array | 710 | 0.25 | whole net | 0.8 | 0.312 |
| clk | Metal2 | wire 0.20 um | 33 | 0.0004 | whole net | 0.4 | 0.001 |
| clk | Metal3 | wire 0.20 um | 9 | 0.0004 | whole net | 0.4 | 0.001 |
| clk | Metal4 | wire 0.20 um | 15 | 0.0004 | whole net | 0.4 | 0.001 |
| clk | Via1 | 1-cut array | 5 | 0.0004 | whole net | 0.4 | 0.001 |
| clk | Via2 | 1-cut array | 4 | 0.0004 | whole net | 0.4 | 0.001 |
| clk | Via3 | 1-cut array | 2 | 0.0004 | whole net | 0.4 | 0.001 |

max ratio: 0.312, VDD Via1 2-cut array
PASS
