michaelk99/IHP__MPC9724/verification/reports/hold_mc/results.txt

== ff
nominal: skew 19.60  clk-to-Q 141.86  arrival-minus-CK 122.26  hold 23.92  slack 98.34  (D slew 17.3, common node slew 102.2, 20-80)
runs: 500, functional or window flags failed: none
slack: mean 98.28  sigma 5.30  min 85.57  max 114.85  skewness 0.08
sigmas from mean to zero slack: 18.6
sigmas from mean to 50 ps, the SDC uncertainty kept as margin: 9.1
min run in sigma below mean: 2.4
  skew  mean 19.41  sigma 3.52
  c2q   mean 141.87  sigma 2.72
  hold  mean 24.18  sigma 2.63
  root sum of squares of the three 5.17, measured 5.30
  distinct hold values 167 of 500 (bisection step 0.063 ps)
== tt
nominal: skew 29.50  clk-to-Q 217.68  arrival-minus-CK 188.18  hold 38.27  slack 149.91  (D slew 25.1, common node slew 154.8, 20-80)
runs: 200, functional or window flags failed: none
slack: mean 149.51  sigma 9.25  min 130.78  max 179.15  skewness 0.04
sigmas from mean to zero slack: 16.2
sigmas from mean to 50 ps, the SDC uncertainty kept as margin: 10.8
min run in sigma below mean: 2.0
  skew  mean 29.72  sigma 5.99
  c2q   mean 218.08  sigma 4.73
  hold  mean 38.84  sigma 4.62
  root sum of squares of the three 8.92, measured 9.25
  distinct hold values 141 of 200 (bisection step 0.063 ps)
