michaelk99/IHP__MPC9724/release/v.1.1.0/packaging/result.md

<!--
SPDX-FileCopyrightText: 2026 Harald Pretl, Johannes Kepler University
SPDX-License-Identifier: Apache-2.0 WITH SHL-2.1
Description: Bondplan report for sg13cmos5l_dsa1_dig_top v.1.1.0, generated by scripts/run_bondplan.py
-->

# Bondplan Report - sg13cmos5l_dsa1_dig_top v.1.1.0

Generated by `scripts/run_bondplan.py` on 2026-10-06.

Bondplan

## Summary

| | |
|---|---|
| Design | sg13cmos5l_dsa1_dig_top |
| Package | OP_QFN32_A4_FIT |
| Die size | 1.60 x 1.60 mm |
| Pad pitch / opening | 114 / 65.8 um |
| Bondwires | 34 (30 pad to lead, 2 pad to cavity, 2 lead to cavity) |
| Wire width | 25 um |
| Wire length | 1296 .. 1701 um |
| Min wire-to-wire gap | 70 um |
| Max lead skew | 3.5 deg |

## Bond Table

| Pin | Die pad | Die x/y (um) | Package x/y (um) | Length (um) | Angle (deg) | Skew (deg) | Min gap (um) |
|---|---|---|---|---|---|---|---|
| 1 | clk_PAD | 4010.0 / 9608.7 | 2725.0 / 10722.9 | 1700.8 | 139.1 | 3.5 | 71.8 |
| 2 | rst_n_PAD | 4010.0 / 9494.7 | 2725.0 / 10294.5 | 1513.5 | 148.1 | 3.2 | 71.8 |
| 3 | input_PAD[0] | 4010.0 / 9380.7 | 2725.0 / 9864.7 | 1373.1 | 159.4 | 2.3 | 81.7 |
| 4 | IOVDD | 4010.0 / 9266.7 | 2725.0 / 9435.0 | 1296.0 | 172.5 | 1.0 | 88.0 |
| 5 | EPAD | 3221.8 / 9041.0 | 2725.0 / 8984.5 | 500.0 | -173.5 | 0.0 | 254.9 |
| 6 | VDD | 4010.0 / 9038.7 | 2725.0 / 8554.8 | 1373.1 | -159.4 | 2.3 | 81.7 |
| 7 | EPAD | 3163.5 / 8365.3 | 2725.0 / 8125.1 | 500.0 | -151.3 | 0.0 | 191.9 |
| 8 | output_PAD[0] | 4010.0 / 8810.7 | 2725.0 / 7699.1 | 1699.1 | -139.1 | 3.5 | 70.1 |
| 9 | output_PAD[6] | 4306.0 / 8514.7 | 3194.3 / 7229.7 | 1699.1 | -130.9 | 3.5 | 71.8 |
| 10 | output_PAD[7] | 4420.0 / 8514.7 | 3620.3 / 7229.7 | 1513.5 | -121.9 | 3.2 | 71.8 |
| 11 | output_PAD[8] | 4534.0 / 8514.7 | 4050.0 / 7229.7 | 1373.1 | -110.6 | 2.3 | 81.7 |
| 12 | output_PAD[9] | 4648.0 / 8514.7 | 4479.7 / 7229.7 | 1296.0 | -97.5 | 1.0 | 88.0 |
| 13 | output_PAD[10] | 4762.0 / 8514.7 | 4930.3 / 7229.7 | 1296.0 | -82.5 | 1.0 | 88.0 |
| 14 | output_PAD[11] | 4876.0 / 8514.7 | 5360.0 / 7229.7 | 1373.1 | -69.4 | 2.3 | 81.7 |
| 15 | output_PAD[12] | 4990.0 / 8514.7 | 5789.7 / 7229.7 | 1513.5 | -58.1 | 3.2 | 71.8 |
| 16 | output_PAD[13] | 5104.0 / 8514.7 | 6215.6 / 7229.7 | 1699.1 | -49.1 | 3.5 | 71.8 |
| 17 | analog_PAD[0] | 5400.0 / 8810.7 | 6685.0 / 7699.1 | 1699.1 | -40.9 | 3.5 | 71.8 |
| 18 | analog_PAD[1] | 5400.0 / 8924.7 | 6685.0 / 8125.1 | 1513.5 | -31.9 | 3.2 | 71.8 |
| 19 | bidir_PAD[0] | 5400.0 / 9038.7 | 6685.0 / 8554.8 | 1373.1 | -20.6 | 2.3 | 81.7 |
| 20 | bidir_PAD[1] | 5400.0 / 9152.7 | 6685.0 / 8984.5 | 1296.0 | -7.5 | 1.0 | 88.0 |
| 21 | output_PAD[14] | 5400.0 / 9266.7 | 6685.0 / 9435.0 | 1296.0 | 7.5 | 1.0 | 88.0 |
| 22 | output_PAD[15] | 5400.0 / 9380.7 | 6685.0 / 9864.7 | 1373.1 | 20.6 | 2.3 | 81.7 |
| 23 | output_PAD[16] | 5400.0 / 9494.7 | 6685.0 / 10294.5 | 1513.5 | 31.9 | 3.2 | 71.8 |
| 24 | output_PAD[17] | 5400.0 / 9608.7 | 6685.0 / 10720.4 | 1699.1 | 40.9 | 3.5 | 71.8 |
| 25 | output_PAD[5] | 5104.0 / 9904.7 | 6215.6 / 11189.7 | 1699.1 | 49.1 | 3.5 | 71.8 |
| 26 | output_PAD[4] | 4990.0 / 9904.7 | 5789.7 / 11189.7 | 1513.5 | 58.1 | 3.2 | 71.8 |
| 27 | output_PAD[3] | 4876.0 / 9904.7 | 5360.0 / 11189.7 | 1373.1 | 69.4 | 2.3 | 81.7 |
| 28 | output_PAD[2] | 4762.0 / 9904.7 | 4930.3 / 11189.7 | 1296.0 | 82.5 | 1.0 | 88.0 |
| 29 | output_PAD[1] | 4648.0 / 9904.7 | 4479.7 / 11189.7 | 1296.0 | 97.5 | 1.0 | 88.0 |
| 30 | input_PAD[3] | 4534.0 / 9904.7 | 4050.0 / 11189.7 | 1373.1 | 110.6 | 2.3 | 81.7 |
| 31 | input_PAD[2] | 4420.0 / 9904.7 | 3620.3 / 11189.7 | 1513.5 | 121.9 | 3.2 | 71.8 |
| 32 | input_PAD[1] | 4306.0 / 9904.7 | 3191.8 / 11189.7 | 1700.8 | 130.9 | 3.5 | 71.8 |
| EPAD | IOVSS | 4010.0 / 9152.7 | 3515.0 / 9082.6 | 500.0 | -171.9 | - | 87.9 |
| EPAD | VSS | 4010.0 / 8924.7 | 3592.9 / 8649.1 | 500.0 | -146.5 | - | 70.1 |
