michaelk99/IHP__MPC9724/verification/startup/bounce.png

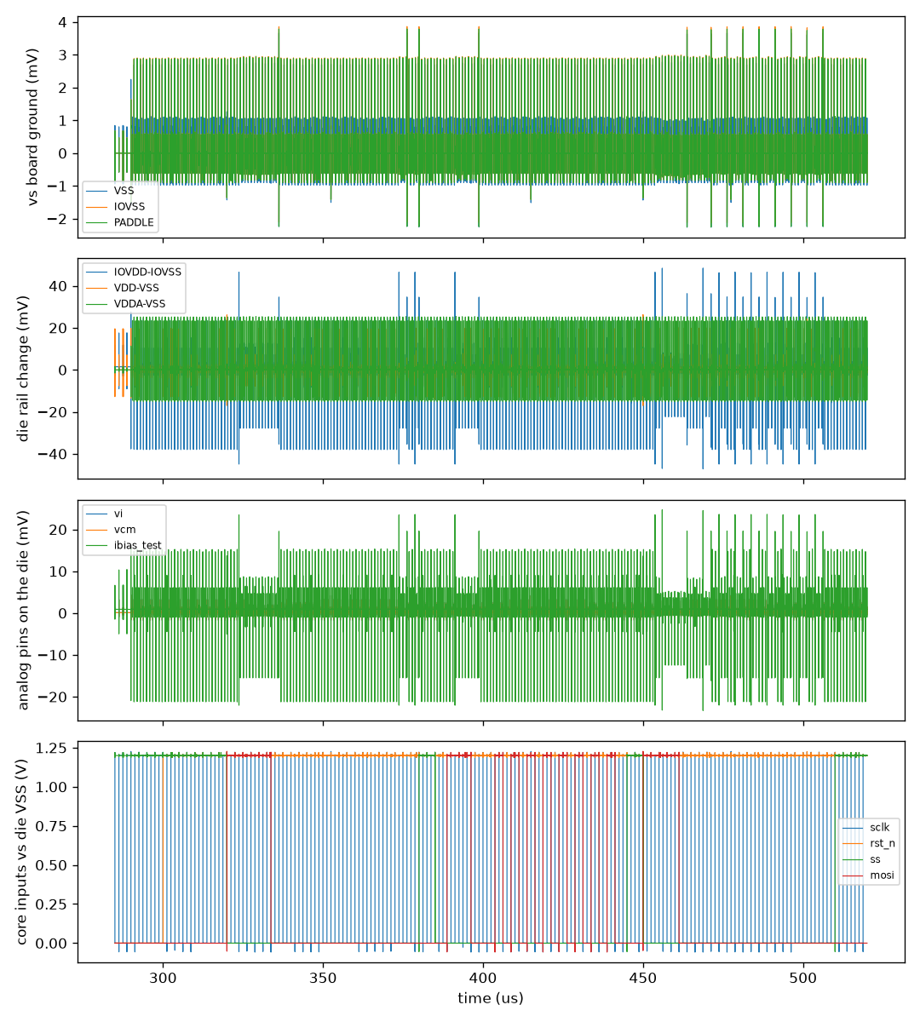
verification/startup/bounce.png
