michaelk99/IHP__MPC9724/verification/startup/dsm2_sch/bounce.png

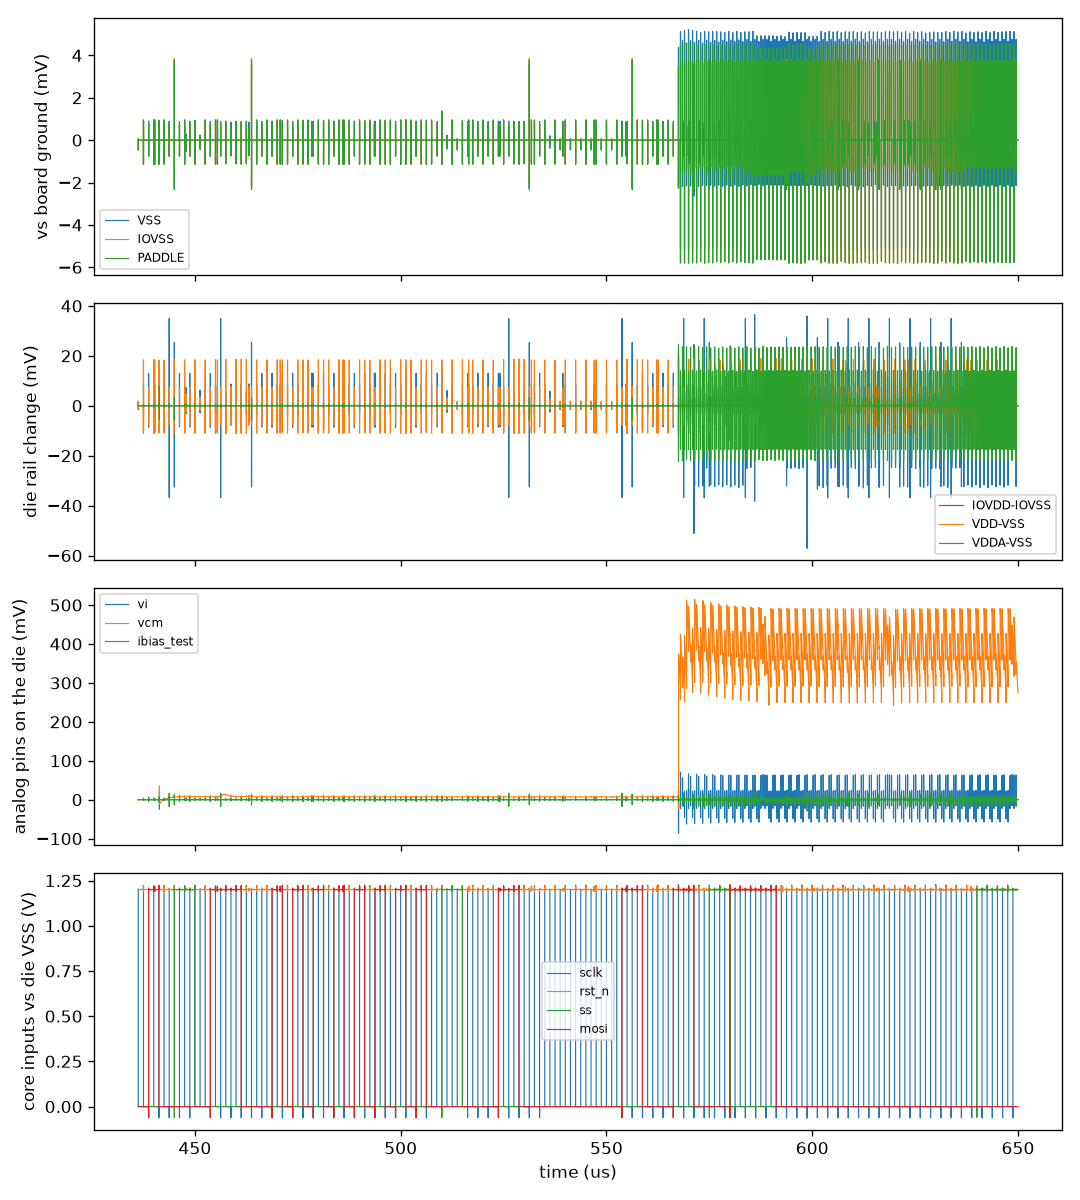
verification/startup/dsm2_sch/bounce.png
