michaelk99/IHP__MPC9724/verification/startup/dsm2_sch/startup.png

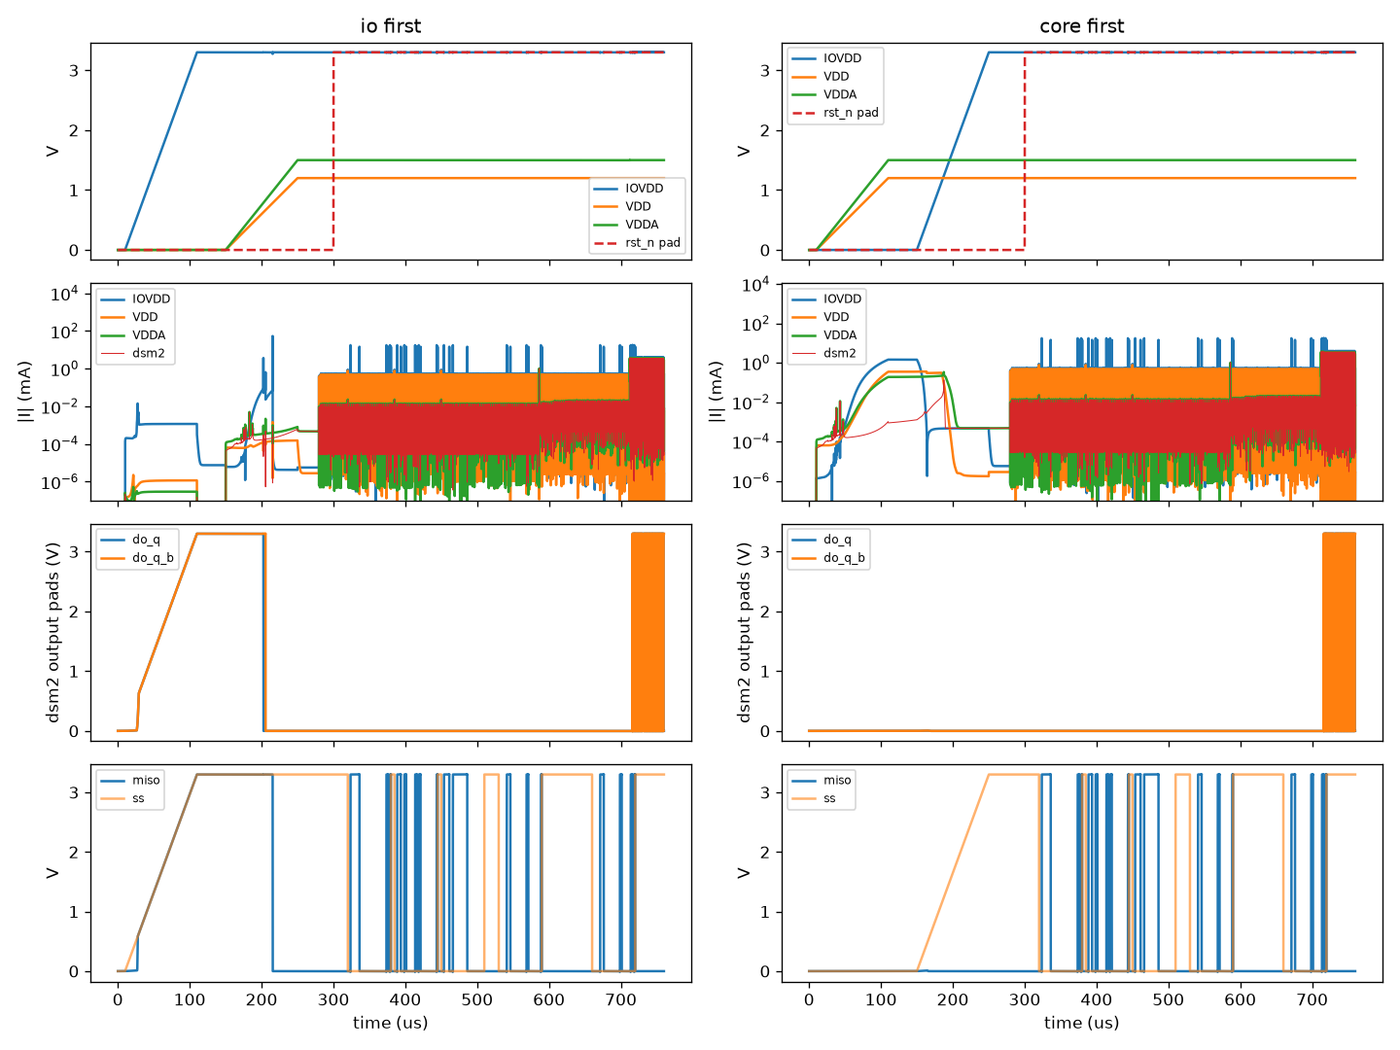
verification/startup/dsm2_sch/startup.png
