michaelk99/IHP__MPC9724/verification/startup/startup.png

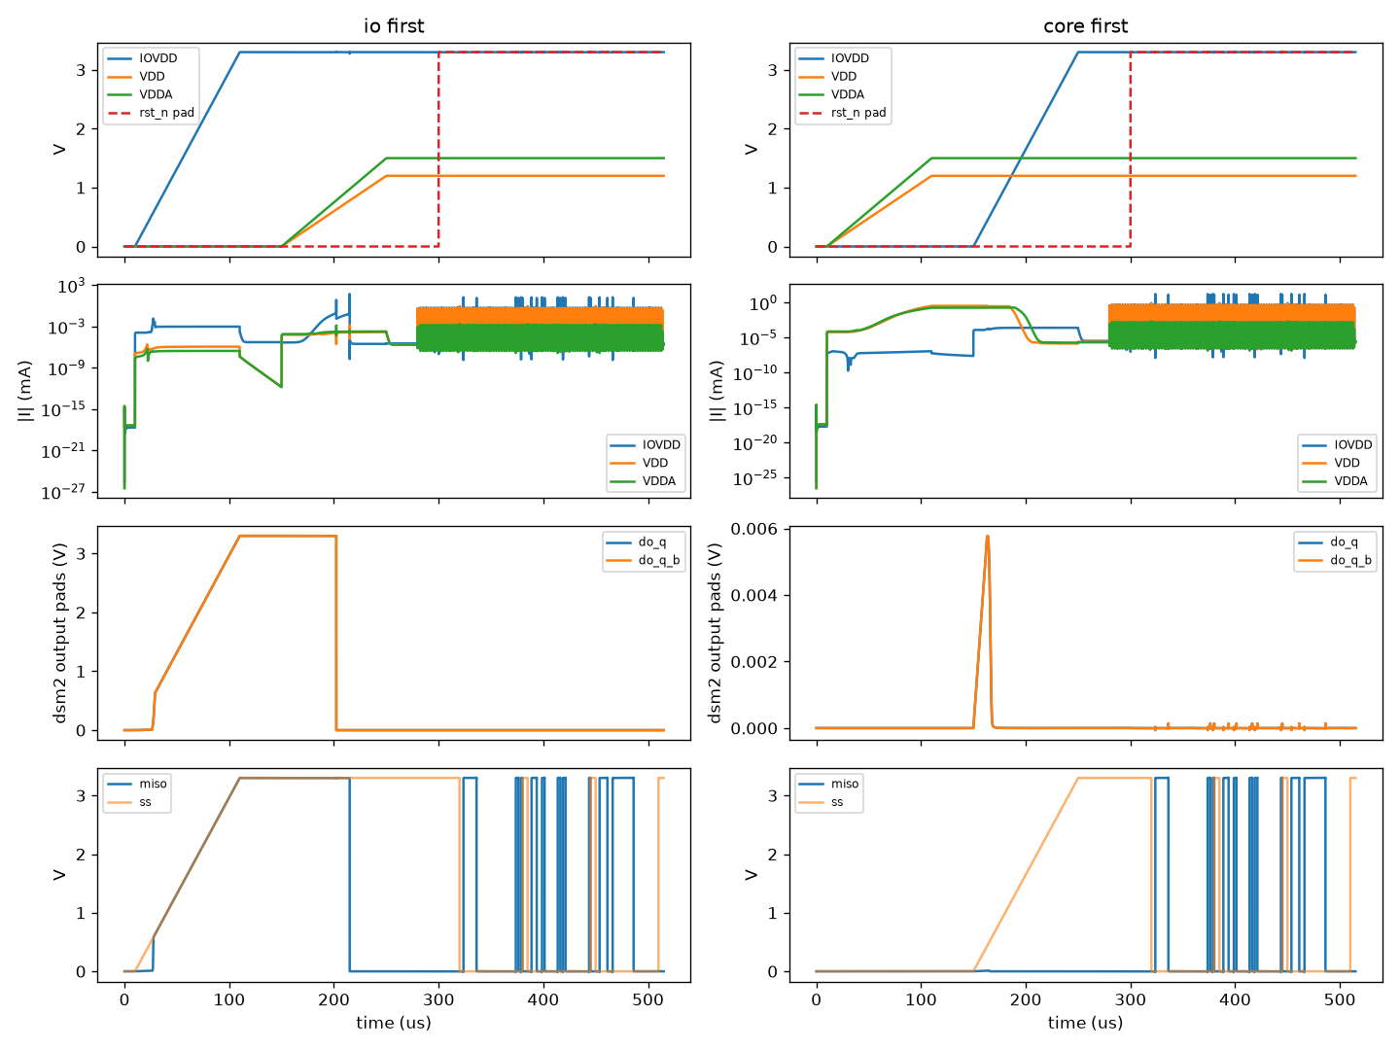
verification/startup/startup.png
