michaelk99/IHP__MPC9724/ip/dsm2_core/spice/dsm2_core_sch.spice

* dsm2_core schematic netlist, ngspice syntax, all child subcircuits (standard cells come from the PDK, see header.spice)
* netlisted by xschem from the dsm2_core schematic (oscillator variant) with the quantizer2 preset fix on 2026-10-31
* SPDX-FileCopyrightText: 2026 Michael Koefinger
* SPDX-License-Identifier: Apache-2.0 WITH SHL-2.1

.subckt dsm2_core vi vcm di_clk di_ena di_rst_b di_trim[3] di_trim[2] di_trim[1] di_trim[0] di_dith_en di_dith_amp[1]
+ di_dith_amp[0] di_vcm_ext di_btest_en di_qout_en do_q do_q_b do_q_dec ibias_test vdd vss di_osc_en di_clk_sel do_clk_osc do_osc_oe
*.ipin di_ena
*.ipin di_rst_b
*.ipin di_trim[3],di_trim[2],di_trim[1],di_trim[0]
*.ipin di_dith_en
*.ipin di_dith_amp[1],di_dith_amp[0]
*.ipin di_vcm_ext
*.ipin di_btest_en
*.ipin di_qout_en
*.iopin vdd
*.iopin vss
*.iopin ibias_test
*.iopin vcm
*.ipin vi
*.ipin di_clk
*.opin do_q
*.opin do_q_b
*.opin do_q_dec
*.ipin di_osc_en
*.ipin di_clk_sel
*.opin do_clk_osc
*.opin do_osc_oe
xio vdd vss di_ena di_rst_b di_trim[3] di_trim[2] di_trim[1] di_trim[0] di_dith_en di_dith_amp[1] di_dith_amp[0] di_vcm_ext
+ di_btest_en di_qout_en d_ena d_rst_b d_trim_b[3] d_trim_b[2] d_trim_b[1] d_trim_b[0] d_dith_en d_dith_amp[1] d_dith_amp[0] d_btest_en
+ d_qout_en d_vcm_ext d_vcm_ext_b dsm2_io
xesd vdd vss ibias_test ibias_test_esd vcm vcm_esd vi vi_esd dsm2_io_esd
xsc vdd vss vi_esd vcm_esd d_phi1 d_phi2 d_qi d_qi_b ibias_200n d_ena vo_p vo_n sc_int2
xioclk vdd vss di_clk d_clk dsm2_io_clk
xclk d_clk_mod d_ena d_phi1 d_phi1_b d_phi2 d_phi2_b d_qclk vdd vss clk_noverlap
xvcmg vdd vss d_vcm_ext d_vcm_ext_b d_phi1_b d_phi2 d_vcm_phi1_b d_vcm_phi2 dsm2_io_vcmg
xvcm d_vcm_phi1_b d_vcm_phi2 vdd vss vcm_esd vcm_gen
xbias vdd vss d_ena d_trim_b[3] d_trim_b[2] d_trim_b[1] d_trim_b[0] ibias_200n d_btest_or ibias_bank bias_gm
xq vo_p vo_n d_qclk d_dith[2] d_dith[1] d_dith[0] d_amp_s[3] d_amp_s[2] d_amp_s[1] d_amp_s[0] d_amp_s_b[3] d_amp_s_b[2]
+ d_amp_s_b[1] d_amp_s_b[0] d_qi d_qi_b do_q do_q_b do_q_dec vdd d_ena d_rst_b d_dith_en d_qout_en vss quantizer2_top
xlfsr d_qclk d_dith_amp[1] d_dith_amp[0] d_dith[2] d_dith[1] d_dith[0] d_amp_s[3] d_amp_s[2] d_amp_s[1] d_amp_s[0] d_amp_s_b[3]
+ d_amp_s_b[2] d_amp_s_b[1] d_amp_s_b[0] vdd d_dith_en vss quantizer2_lfsr
XXMDN vss vdd vss vss sg13_lv_nmos w=840n l=1u ng=2 m=123 mm_ok=1
XXMDP vdd vss vdd vdd sg13_lv_pmos w=2u l=1u ng=2 m=123 mm_ok=1
xosc vdd vss di_osc_en di_clk_sel d_btest_en ibias_bank d_clk d_btest_or ibias_test_esd d_clk_mod do_clk_osc do_osc_oe dsm2_osc
.ends


.subckt dsm2_io vdd vss di_ena di_rst_b di_trim[3] di_trim[2] di_trim[1] di_trim[0] di_dith_en di_dith_amp[1] di_dith_amp[0]
+ di_vcm_ext di_btest_en di_qout_en do_ena do_rst_b do_trim_b[3] do_trim_b[2] do_trim_b[1] do_trim_b[0] do_dith_en do_dith_amp[1]
+ do_dith_amp[0] do_btest_en do_qout_en do_vcm_ext do_vcm_ext_b
*.iopin vdd
*.iopin vss
*.ipin di_ena
*.opin do_ena
*.ipin di_rst_b
*.opin do_rst_b
*.ipin di_vcm_ext
*.opin do_vcm_ext_b
*.opin do_vcm_ext
*.ipin di_trim[3],di_trim[2],di_trim[1],di_trim[0]
*.opin do_trim_b[3],do_trim_b[2],do_trim_b[1],do_trim_b[0]
*.ipin di_dith_en
*.opin do_dith_en
*.ipin di_dith_amp[1],di_dith_amp[0]
*.opin do_dith_amp[1],do_dith_amp[0]
*.ipin di_btest_en
*.opin do_btest_en
*.ipin di_qout_en
*.opin do_qout_en
XHE vdd vss di_ena d_ena_b dsm2_io_rx
XMPS vsw_p d_ena_b vdd vdd sg13_hv_pmos w=1u l=0.45u ng=1 m=1 mm_ok=1
XMPL do_ena vss vsw_p vdd sg13_hv_pmos w=1u l=5u ng=1 m=1 mm_ok=1
XMNL1 do_ena vdd vln1 vss sg13_hv_nmos w=1u l=10u ng=1 m=1 mm_ok=1
XMNL2 vln1 vdd vsw_n vss sg13_hv_nmos w=1u l=10u ng=1 m=1 mm_ok=1
XMNS vsw_n d_ena_b vss vss sg13_hv_nmos w=1u l=0.45u ng=1 m=1 mm_ok=1
XMCP vdd do_ena vdd vdd sg13_hv_pmos w=1u l=10u ng=1 m=2 mm_ok=1
XMCN vss do_ena vss vss sg13_hv_nmos w=1u l=5u ng=1 m=4 mm_ok=1
XMCD vdd vss vdd vdd sg13_hv_pmos w=1u l=5u ng=1 m=3 mm_ok=1
XHR vdd vss di_rst_b d_rst dsm2_io_rx
XLR do_rst_b d_rst vdd vss sg13cmos5l_inv_1
XHV vdd vss di_vcm_ext do_vcm_ext_b dsm2_io_rx
XLV do_vcm_ext do_vcm_ext_b vdd vss sg13cmos5l_inv_1
XHT[3] vdd vss di_trim[3] do_trim_b[3] dsm2_io_rx
XHT[2] vdd vss di_trim[2] do_trim_b[2] dsm2_io_rx
XHT[1] vdd vss di_trim[1] do_trim_b[1] dsm2_io_rx
XHT[0] vdd vss di_trim[0] do_trim_b[0] dsm2_io_rx
XHD vdd vss di_dith_en d_dith_en_b dsm2_io_rx
XLD do_dith_en d_dith_en_b vdd vss sg13cmos5l_inv_1
XHA[1] vdd vss di_dith_amp[1] d_dith_amp_b[1] dsm2_io_rx
XHA[0] vdd vss di_dith_amp[0] d_dith_amp_b[0] dsm2_io_rx
XLA[1] do_dith_amp[1] d_dith_amp_b[1] vdd vss sg13cmos5l_inv_1
XLA[0] do_dith_amp[0] d_dith_amp_b[0] vdd vss sg13cmos5l_inv_1
XHB vdd vss di_btest_en d_btest_en_b dsm2_io_rx
XLB do_btest_en d_btest_en_b vdd vss sg13cmos5l_inv_1
XHQ vdd vss di_qout_en d_qout_en_b dsm2_io_rx
XLQ do_qout_en d_qout_en_b vdd vss sg13cmos5l_inv_1
.ends


.subckt dsm2_io_esd vdd vss ibias_test_pad ibias_test vcm_pad vcm vi_pad vi
*.iopin vdd
*.iopin vss
*.ipin vi_pad
*.opin vi
*.iopin vcm_pad
*.iopin vcm
*.iopin ibias_test_pad
*.iopin ibias_test
XSP1 vi vss vi_pad vdd vss sg13cmos5l_SecondaryProtection
XSP2 vcm vss vcm_pad vdd vss sg13cmos5l_SecondaryProtection
XSP3 ibias_test vss ibias_test_pad vdd vss sg13cmos5l_SecondaryProtection
.ends


.subckt sc_int2 vdd vss vi vcm di_phi1 di_phi2 di_q di_q_b ibias_200n di_ena vo_p vo_n
*.ipin vi
*.ipin ibias_200n
*.ipin di_ena
*.ipin di_phi1
*.ipin di_phi2
*.iopin vdd
*.iopin vss
*.ipin vcm
*.ipin di_q
*.ipin di_q_b
*.opin vo_p
*.opin vo_n
XS_TI vc1l_p vi di_phi1 d_phi1_b vdd vss sw_tgate
XS_TVA vc1l_p vh_p di_phi2 d_phi2_b vdd vss sw_tgate
XS_TVB vh_p vdd di_q di_q_b vdd vss sw_tgate
XS_TBA vc1l_p vl_p di_phi2 d_phi2_b vdd vss sw_tgate
XS_TBB vl_p vss di_q_b di_q vdd vss sw_tgate
XC1P[1] vc1r_p vc1l_p cap_cmomf w=3e-6 l=11.39e-6 mmin=1 mmax=4 subblock=0 m=1 mm_ok=1
XC1P[0] vc1r_p vc1l_p cap_cmomf w=3e-6 l=11.39e-6 mmin=1 mmax=4 subblock=0 m=1 mm_ok=1
XS_TRV vc1r_p vvg_n di_phi2 d_phi2_b vdd vss sw_tgate
XS_TRC vc1r_p vcm di_phi1 d_phi1_b vdd vss sw_tgate
XS_BI vc1l_n vi di_phi2 d_phi2_b vdd vss sw_tgate
XS_BVA vc1l_n vh_n di_phi1 d_phi1_b vdd vss sw_tgate
XS_BVB vh_n vdd di_q di_q_b vdd vss sw_tgate
XS_BBA vc1l_n vl_n di_phi1 d_phi1_b vdd vss sw_tgate
XS_BBB vl_n vss di_q_b di_q vdd vss sw_tgate
XC1N[1] vc1r_n vc1l_n cap_cmomf w=3e-6 l=11.39e-6 mmin=1 mmax=4 subblock=0 m=1 mm_ok=1
XC1N[0] vc1r_n vc1l_n cap_cmomf w=3e-6 l=11.39e-6 mmin=1 mmax=4 subblock=0 m=1 mm_ok=1
XS_BRV vc1r_n vvg_p di_phi2 d_phi2_b vdd vss sw_tgate
XS_BRC vc1r_n vcm di_phi1 d_phi1_b vdd vss sw_tgate
xamp1 vdd vfb vo_p vo_n vvg_p vvg_n ibias_200n di_ena vss vbn ota_fcasc2_top
XC2P[11] vvg_n vo_p cap_cmomf w=3e-6 l=11.39e-6 mmin=1 mmax=4 subblock=0 m=1 mm_ok=1
XC2P[10] vvg_n vo_p cap_cmomf w=3e-6 l=11.39e-6 mmin=1 mmax=4 subblock=0 m=1 mm_ok=1
XC2P[9] vvg_n vo_p cap_cmomf w=3e-6 l=11.39e-6 mmin=1 mmax=4 subblock=0 m=1 mm_ok=1
XC2P[8] vvg_n vo_p cap_cmomf w=3e-6 l=11.39e-6 mmin=1 mmax=4 subblock=0 m=1 mm_ok=1
XC2P[7] vvg_n vo_p cap_cmomf w=3e-6 l=11.39e-6 mmin=1 mmax=4 subblock=0 m=1 mm_ok=1
XC2P[6] vvg_n vo_p cap_cmomf w=3e-6 l=11.39e-6 mmin=1 mmax=4 subblock=0 m=1 mm_ok=1
XC2P[5] vvg_n vo_p cap_cmomf w=3e-6 l=11.39e-6 mmin=1 mmax=4 subblock=0 m=1 mm_ok=1
XC2P[4] vvg_n vo_p cap_cmomf w=3e-6 l=11.39e-6 mmin=1 mmax=4 subblock=0 m=1 mm_ok=1
XC2P[3] vvg_n vo_p cap_cmomf w=3e-6 l=11.39e-6 mmin=1 mmax=4 subblock=0 m=1 mm_ok=1
XC2P[2] vvg_n vo_p cap_cmomf w=3e-6 l=11.39e-6 mmin=1 mmax=4 subblock=0 m=1 mm_ok=1
XC2P[1] vvg_n vo_p cap_cmomf w=3e-6 l=11.39e-6 mmin=1 mmax=4 subblock=0 m=1 mm_ok=1
XC2P[0] vvg_n vo_p cap_cmomf w=3e-6 l=11.39e-6 mmin=1 mmax=4 subblock=0 m=1 mm_ok=1
XC2N[11] vvg_p vo_n cap_cmomf w=3e-6 l=11.39e-6 mmin=1 mmax=4 subblock=0 m=1 mm_ok=1
XC2N[10] vvg_p vo_n cap_cmomf w=3e-6 l=11.39e-6 mmin=1 mmax=4 subblock=0 m=1 mm_ok=1
XC2N[9] vvg_p vo_n cap_cmomf w=3e-6 l=11.39e-6 mmin=1 mmax=4 subblock=0 m=1 mm_ok=1
XC2N[8] vvg_p vo_n cap_cmomf w=3e-6 l=11.39e-6 mmin=1 mmax=4 subblock=0 m=1 mm_ok=1
XC2N[7] vvg_p vo_n cap_cmomf w=3e-6 l=11.39e-6 mmin=1 mmax=4 subblock=0 m=1 mm_ok=1
XC2N[6] vvg_p vo_n cap_cmomf w=3e-6 l=11.39e-6 mmin=1 mmax=4 subblock=0 m=1 mm_ok=1
XC2N[5] vvg_p vo_n cap_cmomf w=3e-6 l=11.39e-6 mmin=1 mmax=4 subblock=0 m=1 mm_ok=1
XC2N[4] vvg_p vo_n cap_cmomf w=3e-6 l=11.39e-6 mmin=1 mmax=4 subblock=0 m=1 mm_ok=1
XC2N[3] vvg_p vo_n cap_cmomf w=3e-6 l=11.39e-6 mmin=1 mmax=4 subblock=0 m=1 mm_ok=1
XC2N[2] vvg_p vo_n cap_cmomf w=3e-6 l=11.39e-6 mmin=1 mmax=4 subblock=0 m=1 mm_ok=1
XC2N[1] vvg_p vo_n cap_cmomf w=3e-6 l=11.39e-6 mmin=1 mmax=4 subblock=0 m=1 mm_ok=1
XC2N[0] vvg_p vo_n cap_cmomf w=3e-6 l=11.39e-6 mmin=1 mmax=4 subblock=0 m=1 mm_ok=1
xcmfb1 di_phi2 di_phi1 vss vo_p vcm vbn vfb vo_n vdd cmfb_sc2
XINV_vphi1 di_phi1 d_phi1_b vdd vss inv_lv
XINV_vphi2 di_phi2 d_phi2_b vdd vss inv_lv
XCDUM_DCOL[17] vdd vss cap_cmomf w=3e-6 l=5.6e-6 mmin=1 mmax=4 subblock=0 m=1 mm_ok=1
XCDUM_DCOL[16] vdd vss cap_cmomf w=3e-6 l=5.6e-6 mmin=1 mmax=4 subblock=0 m=1 mm_ok=1
XCDUM_DCOL[15] vdd vss cap_cmomf w=3e-6 l=5.6e-6 mmin=1 mmax=4 subblock=0 m=1 mm_ok=1
XCDUM_DCOL[14] vdd vss cap_cmomf w=3e-6 l=5.6e-6 mmin=1 mmax=4 subblock=0 m=1 mm_ok=1
XCDUM_DCOL[13] vdd vss cap_cmomf w=3e-6 l=5.6e-6 mmin=1 mmax=4 subblock=0 m=1 mm_ok=1
XCDUM_DCOL[12] vdd vss cap_cmomf w=3e-6 l=5.6e-6 mmin=1 mmax=4 subblock=0 m=1 mm_ok=1
XCDUM_DCOL[11] vdd vss cap_cmomf w=3e-6 l=5.6e-6 mmin=1 mmax=4 subblock=0 m=1 mm_ok=1
XCDUM_DCOL[10] vdd vss cap_cmomf w=3e-6 l=5.6e-6 mmin=1 mmax=4 subblock=0 m=1 mm_ok=1
XCDUM_DCOL[9] vdd vss cap_cmomf w=3e-6 l=5.6e-6 mmin=1 mmax=4 subblock=0 m=1 mm_ok=1
XCDUM_DCOL[8] vdd vss cap_cmomf w=3e-6 l=5.6e-6 mmin=1 mmax=4 subblock=0 m=1 mm_ok=1
XCDUM_DCOL[7] vdd vss cap_cmomf w=3e-6 l=5.6e-6 mmin=1 mmax=4 subblock=0 m=1 mm_ok=1
XCDUM_DCOL[6] vdd vss cap_cmomf w=3e-6 l=5.6e-6 mmin=1 mmax=4 subblock=0 m=1 mm_ok=1
XCDUM_DCOL[5] vdd vss cap_cmomf w=3e-6 l=5.6e-6 mmin=1 mmax=4 subblock=0 m=1 mm_ok=1
XCDUM_DCOL[4] vdd vss cap_cmomf w=3e-6 l=5.6e-6 mmin=1 mmax=4 subblock=0 m=1 mm_ok=1
XCDUM_DCOL[3] vdd vss cap_cmomf w=3e-6 l=5.6e-6 mmin=1 mmax=4 subblock=0 m=1 mm_ok=1
XCDUM_DCOL[2] vdd vss cap_cmomf w=3e-6 l=5.6e-6 mmin=1 mmax=4 subblock=0 m=1 mm_ok=1
XCDUM_DCOL[1] vdd vss cap_cmomf w=3e-6 l=5.6e-6 mmin=1 mmax=4 subblock=0 m=1 mm_ok=1
XCDUM_DCOL[0] vdd vss cap_cmomf w=3e-6 l=5.6e-6 mmin=1 mmax=4 subblock=0 m=1 mm_ok=1
XCDUM_STRIP[7] vdd vss cap_cmomf w=3e-6 l=11.39e-6 mmin=1 mmax=4 subblock=0 m=1 mm_ok=1
XCDUM_STRIP[6] vdd vss cap_cmomf w=3e-6 l=11.39e-6 mmin=1 mmax=4 subblock=0 m=1 mm_ok=1
XCDUM_STRIP[5] vdd vss cap_cmomf w=3e-6 l=11.39e-6 mmin=1 mmax=4 subblock=0 m=1 mm_ok=1
XCDUM_STRIP[4] vdd vss cap_cmomf w=3e-6 l=11.39e-6 mmin=1 mmax=4 subblock=0 m=1 mm_ok=1
XCDUM_STRIP[3] vdd vss cap_cmomf w=3e-6 l=11.39e-6 mmin=1 mmax=4 subblock=0 m=1 mm_ok=1
XCDUM_STRIP[2] vdd vss cap_cmomf w=3e-6 l=11.39e-6 mmin=1 mmax=4 subblock=0 m=1 mm_ok=1
XCDUM_STRIP[1] vdd vss cap_cmomf w=3e-6 l=11.39e-6 mmin=1 mmax=4 subblock=0 m=1 mm_ok=1
XCDUM_STRIP[0] vdd vss cap_cmomf w=3e-6 l=11.39e-6 mmin=1 mmax=4 subblock=0 m=1 mm_ok=1
.ends


.subckt dsm2_io_clk vdd vss di_clk do_clk
*.iopin vdd
*.iopin vss
*.ipin di_clk
*.opin do_clk
XBC do_clk di_clk vdd vss sg13cmos5l_buf_2
.ends


.subckt clk_noverlap di_clk di_ena do_phi1 do_phi1_b do_phi2 do_phi2_b do_qclk vdd vss
*.ipin di_clk
*.ipin di_ena
*.opin do_phi1_b
*.opin do_phi1
*.opin do_phi2
*.opin do_phi2_b
*.iopin vdd
*.iopin vss
*.opin do_qclk
XAND0 d_clk_en di_clk di_ena vdd vss sg13cmos5l_and2_1
XINV0 d_clk_en_b d_clk_en vdd vss sg13cmos5l_inv_1
XNOR0 d_phi1_nor d_clk_en_b d_ena_b d_phi2_fb vdd vss sg13cmos5l_nor3_1
XNOR1 d_phi2_nor d_clk_en d_ena_b do_phi1 vdd vss sg13cmos5l_nor3_1
XINV_ENA d_ena_b di_ena vdd vss sg13cmos5l_inv_1
XINV11 d_phi1_1 d_phi1_nor vdd vss sg13cmos5l_inv_1
XINV21 d_phi2_1 d_phi2_nor vdd vss sg13cmos5l_inv_1
XINV12 d_phi1_2 d_phi1_1 vdd vss sg13cmos5l_inv_1
XINV22 d_phi2_2 d_phi2_1 vdd vss sg13cmos5l_inv_1
XINV13 do_phi1_b d_phi1_2 vdd vss sg13cmos5l_inv_1
XINV23 do_phi2_b d_phi2_2 vdd vss sg13cmos5l_inv_1
XINV14 do_phi1 do_phi1_b vdd vss sg13cmos5l_inv_1
XINV24 do_phi2 do_phi2_b vdd vss sg13cmos5l_inv_1
XDC8[11] vdd vss sg13cmos5l_decap_8
XDC8[10] vdd vss sg13cmos5l_decap_8
XDC8[9] vdd vss sg13cmos5l_decap_8
XDC8[8] vdd vss sg13cmos5l_decap_8
XDC8[7] vdd vss sg13cmos5l_decap_8
XDC8[6] vdd vss sg13cmos5l_decap_8
XDC8[5] vdd vss sg13cmos5l_decap_8
XDC8[4] vdd vss sg13cmos5l_decap_8
XDC8[3] vdd vss sg13cmos5l_decap_8
XDC8[2] vdd vss sg13cmos5l_decap_8
XDC8[1] vdd vss sg13cmos5l_decap_8
XDC8[0] vdd vss sg13cmos5l_decap_8
XDC4[1] vdd vss sg13cmos5l_decap_4
XDC4[0] vdd vss sg13cmos5l_decap_4
XDLY0 net1 do_phi2 vdd vss sg13cmos5l_dlygate4sd3_1
XDLY1 net2 net1 vdd vss sg13cmos5l_dlygate4sd3_1
XDLY2 net3 net2 vdd vss sg13cmos5l_dlygate4sd3_1
XDLY3 net4 net3 vdd vss sg13cmos5l_dlygate4sd3_1
XDLY4 net5 net4 vdd vss sg13cmos5l_dlygate4sd3_1
XDLY5 net6 net5 vdd vss sg13cmos5l_dlygate4sd3_1
XDLY6 net7 net6 vdd vss sg13cmos5l_dlygate4sd3_1
XDLY7 net8 net7 vdd vss sg13cmos5l_dlygate4sd3_1
XDLY8 net9 net8 vdd vss sg13cmos5l_dlygate4sd3_1
XDLY9 net10 net9 vdd vss sg13cmos5l_dlygate4sd3_1
XDLY10 net11 net10 vdd vss sg13cmos5l_dlygate4sd3_1
XDLY11 net12 net11 vdd vss sg13cmos5l_dlygate4sd3_1
XDLY12 net13 net12 vdd vss sg13cmos5l_dlygate4sd3_1
XDLY13 d_phi2_fb net13 vdd vss sg13cmos5l_dlygate4sd3_1
XQI1 d_qck1 do_phi2 vdd vss sg13cmos5l_inv_1
XQI2 d_qck2 d_qck1 vdd vss sg13cmos5l_inv_1
XQI3 d_qck3 d_qck2 vdd vss sg13cmos5l_inv_1
XQA do_qclk d_clk_en d_qck3 vdd vss sg13cmos5l_and2_1
.ends


.subckt dsm2_io_vcmg vdd vss di_vcm_ext di_vcm_ext_b di_phi1_b di_phi2 do_phi1_b do_phi2
*.iopin vdd
*.iopin vss
*.ipin di_phi1_b
*.opin do_phi1_b
*.ipin di_vcm_ext
*.ipin di_vcm_ext_b
*.ipin di_phi2
*.opin do_phi2
XOR do_phi1_b di_phi1_b di_vcm_ext vdd vss sg13cmos5l_or2_1
XAND do_phi2 di_phi2 di_vcm_ext_b vdd vss sg13cmos5l_and2_1
.ends


.subckt vcm_gen di_phi1_b di_phi2 vdd vss vcm
*.ipin di_phi1_b
*.ipin di_phi2
*.iopin vdd
*.iopin vss
*.iopin vcm
XMS1 vcf_t di_phi1_b vdd vdd sg13_hv_pmos w=4u l=0.45u ng=1 m=1 mm_ok=1
XMS4 vcf_b di_phi2 vss vss sg13_hv_nmos w=2u l=0.45u ng=1 m=1 mm_ok=1
XMS2 vcf_b di_phi1_b vcm vdd sg13_lv_pmos w=4u l=0.5u ng=1 m=1 mm_ok=1
XMS3 vcf_t di_phi2 vcm vss sg13_lv_nmos w=4u l=0.5u ng=1 m=1 mm_ok=1
XCF1[3] vcf_t vcf_b cap_cmomf w=4.2e-6 l=12.4e-6 mmin=3 mmax=4 subblock=0 m=1 mm_ok=1
XCF1[2] vcf_t vcf_b cap_cmomf w=4.2e-6 l=12.4e-6 mmin=3 mmax=4 subblock=0 m=1 mm_ok=1
XCF1[1] vcf_t vcf_b cap_cmomf w=4.2e-6 l=12.4e-6 mmin=3 mmax=4 subblock=0 m=1 mm_ok=1
XCF1[0] vcf_t vcf_b cap_cmomf w=4.2e-6 l=12.4e-6 mmin=3 mmax=4 subblock=0 m=1 mm_ok=1
XCF2[3] vcf_b vcf_t cap_cmomf w=4.2e-6 l=12.4e-6 mmin=3 mmax=4 subblock=0 m=1 mm_ok=1
XCF2[2] vcf_b vcf_t cap_cmomf w=4.2e-6 l=12.4e-6 mmin=3 mmax=4 subblock=0 m=1 mm_ok=1
XCF2[1] vcf_b vcf_t cap_cmomf w=4.2e-6 l=12.4e-6 mmin=3 mmax=4 subblock=0 m=1 mm_ok=1
XCF2[0] vcf_b vcf_t cap_cmomf w=4.2e-6 l=12.4e-6 mmin=3 mmax=4 subblock=0 m=1 mm_ok=1
XCR vss vcm vss vss sg13_hv_nmos w=10u l=10u ng=1 m=7 mm_ok=1
XMDEC vss vdd vss vss sg13_hv_nmos w=4u l=10u ng=1 m=2 mm_ok=1
XMDR vss vss vss vss sg13_hv_nmos w=10u l=0.45u ng=1 m=2 mm_ok=1
XMDS vss vss vss vss sg13_hv_nmos w=1.5u l=0.45u ng=1 m=1 mm_ok=1
.ends


.subckt bias_gm vdd vss di_ena di_trim_b[3] di_trim_b[2] di_trim_b[1] di_trim_b[0] ibias_200n di_btest_en ibias_test
*.iopin vdd
*.iopin vss
*.ipin di_ena
*.iopin ibias_200n
*.ipin di_trim_b[3],di_trim_b[2],di_trim_b[1],di_trim_b[0]
*.ipin di_btest_en
*.iopin ibias_test
XMCL1 vz di_ena vdd vdd sg13_lv_pmos w=0.5u l=5u ng=1 m=1 mm_ok=1
XMPI d_en_b di_ena vdd vdd sg13_lv_pmos w=0.5u l=0.5u ng=1 m=1 mm_ok=1
XMNI d_en_b di_ena vss vss sg13_lv_nmos w=0.5u l=1u ng=1 m=1 mm_ok=1
XMCL3 vx d_en_b vss vss sg13_hv_nmos w=0.5u l=1u ng=1 m=1 mm_ok=1
XMCL4 vy d_en_b vss vss sg13_hv_nmos w=0.5u l=1u ng=1 m=1 mm_ok=1
XMCL6 vs d_en_b vss vss sg13_lv_nmos w=0.5u l=1u ng=1 m=1 mm_ok=1
XM3 vy vz vdd vdd sg13_lv_pmos w=0.5u l=5u ng=1 m=24 mm_ok=1
XM5 vz vz vdd vdd sg13_lv_pmos w=0.5u l=5u ng=1 m=12 mm_ok=1
XM4 vx vz vdd vdd sg13_lv_pmos w=0.5u l=5u ng=1 m=24 mm_ok=1
XM6 vz vy vss vss sg13_hv_nmos w=0.5u l=10u ng=1 m=2 mm_ok=1
XM1 vy vx vss vss sg13_hv_nmos w=0.5u l=10u ng=1 m=4 mm_ok=1
XCC vss net1 vss vss sg13_hv_nmos w=10u l=10u ng=1 m=20 mm_ok=1
XM2 vx vx vnr vss sg13_lv_nmos w=0.5u l=10u ng=1 m=4 mm_ok=1
XR1 vnr vss vss rhigh w=0.5e-6 l=735e-6 m=1 b=0 mm_ok=1
XMSA[12] vua[1] vt1 vdd vdd sg13_lv_pmos w=0.5u l=10u ng=1 m=1 mm_ok=1
XMSA[11] vua[2] vt1 vua[1] vdd sg13_lv_pmos w=0.5u l=10u ng=1 m=1 mm_ok=1
XMSA[10] vua[3] vt1 vua[2] vdd sg13_lv_pmos w=0.5u l=10u ng=1 m=1 mm_ok=1
XMSA[9] vua[4] vt1 vua[3] vdd sg13_lv_pmos w=0.5u l=10u ng=1 m=1 mm_ok=1
XMSA[8] vua[5] vt1 vua[4] vdd sg13_lv_pmos w=0.5u l=10u ng=1 m=1 mm_ok=1
XMSA[7] vua[6] vt1 vua[5] vdd sg13_lv_pmos w=0.5u l=10u ng=1 m=1 mm_ok=1
XMSA[6] vua[7] vt1 vua[6] vdd sg13_lv_pmos w=0.5u l=10u ng=1 m=1 mm_ok=1
XMSA[5] vua[8] vt1 vua[7] vdd sg13_lv_pmos w=0.5u l=10u ng=1 m=1 mm_ok=1
XMSA[4] vua[9] vt1 vua[8] vdd sg13_lv_pmos w=0.5u l=10u ng=1 m=1 mm_ok=1
XMSA[3] vua[10] vt1 vua[9] vdd sg13_lv_pmos w=0.5u l=10u ng=1 m=1 mm_ok=1
XMSA[2] vua[11] vt1 vua[10] vdd sg13_lv_pmos w=0.5u l=10u ng=1 m=1 mm_ok=1
XMSA[1] vua[12] vt1 vua[11] vdd sg13_lv_pmos w=0.5u l=10u ng=1 m=1 mm_ok=1
XMSA[0] vt1 vt1 vua[12] vdd sg13_lv_pmos w=0.5u l=10u ng=1 m=1 mm_ok=1
XMSB[12] vub[1] vs vt1 vdd sg13_lv_pmos w=0.5u l=10u ng=1 m=1 mm_ok=1
XMSB[11] vub[2] vs vub[1] vdd sg13_lv_pmos w=0.5u l=10u ng=1 m=1 mm_ok=1
XMSB[10] vub[3] vs vub[2] vdd sg13_lv_pmos w=0.5u l=10u ng=1 m=1 mm_ok=1
XMSB[9] vub[4] vs vub[3] vdd sg13_lv_pmos w=0.5u l=10u ng=1 m=1 mm_ok=1
XMSB[8] vub[5] vs vub[4] vdd sg13_lv_pmos w=0.5u l=10u ng=1 m=1 mm_ok=1
XMSB[7] vub[6] vs vub[5] vdd sg13_lv_pmos w=0.5u l=10u ng=1 m=1 mm_ok=1
XMSB[6] vub[7] vs vub[6] vdd sg13_lv_pmos w=0.5u l=10u ng=1 m=1 mm_ok=1
XMSB[5] vub[8] vs vub[7] vdd sg13_lv_pmos w=0.5u l=10u ng=1 m=1 mm_ok=1
XMSB[4] vub[9] vs vub[8] vdd sg13_lv_pmos w=0.5u l=10u ng=1 m=1 mm_ok=1
XMSB[3] vub[10] vs vub[9] vdd sg13_lv_pmos w=0.5u l=10u ng=1 m=1 mm_ok=1
XMSB[2] vub[11] vs vub[10] vdd sg13_lv_pmos w=0.5u l=10u ng=1 m=1 mm_ok=1
XMSB[1] vub[12] vs vub[11] vdd sg13_lv_pmos w=0.5u l=10u ng=1 m=1 mm_ok=1
XMSB[0] vs vs vub[12] vdd sg13_lv_pmos w=0.5u l=10u ng=1 m=1 mm_ok=1
XMSN vs vx vss vss sg13_hv_nmos w=0.5u l=10u ng=1 m=2 mm_ok=1
XMINJ vz vs vss vss sg13_hv_nmos w=4u l=0.5u ng=1 m=2 mm_ok=1
XMPD vdd vdd vdd vdd sg13_lv_pmos w=0.5u l=5u ng=1 m=26 mm_ok=1
XMNDS vss vss vss vss sg13_hv_nmos w=10u l=1u ng=1 m=10 mm_ok=1
XRD1 vss vss vss rhigh w=0.5e-6 l=17.5e-6 m=4 b=0 mm_ok=1
XRD2 vss vss vss rhigh w=0.5e-6 l=10.975e-6 m=4 b=0 mm_ok=1
XMSD vdd vdd vdd vdd sg13_lv_pmos w=0.5u l=10u ng=1 m=1 mm_ok=1
XMSDS vs vs vs vdd sg13_lv_pmos w=0.5u l=10u ng=1 m=1 mm_ok=1
XRD3 vss vss vss rhigh w=0.5e-6 l=2.75e-6 m=46 b=0 mm_ok=1
XMNDJ vss vss vss vss sg13_hv_nmos w=0.5u l=10u ng=1 m=4 mm_ok=1
xtrim vdd vss vz di_trim_b[3] di_trim_b[2] di_trim_b[1] di_trim_b[0] ibias_200n bias_trim
XRZ vy net1 vss rhigh w=0.5e-6 l=43.9e-6 m=1 b=0 mm_ok=1
XMCI vss ibias_200n vss vss sg13_hv_nmos w=0.5u l=10u ng=1 m=4 mm_ok=1
XMNDL vss vss vss vss sg13_lv_nmos w=0.5u l=10u ng=1 m=6 mm_ok=1
XMNDT vss vss vss vss sg13_hv_nmos w=1u l=10u ng=1 m=8 mm_ok=1
XMNDR vnr vss vnr vss sg13_lv_nmos w=0.5u l=10u ng=1 m=4 mm_ok=1
XRD4 vss vss vss rhigh w=0.5e-6 l=9.28e-6 m=8 b=0 mm_ok=1
XMPBI d_btest_b di_btest_en vdd vdd sg13_lv_pmos w=0.5u l=5u ng=1 m=1 mm_ok=1
XMNBI d_btest_b di_btest_en vss vss sg13_lv_nmos w=0.5u l=10u ng=1 m=2 mm_ok=1
xtrim2 vdd vss vz di_trim_b[3] di_trim_b[2] di_trim_b[1] di_trim_b[0] vbt bias_trim
XMBS ibias_test d_btest_b vbt vdd sg13_lv_pmos w=0.5u l=5u ng=1 m=6 mm_ok=1
XMBSD vbt vdd vbt vdd sg13_lv_pmos w=0.5u l=5u ng=1 m=2 mm_ok=1
.ends


.subckt quantizer2_top vi_p vi_n di_clk di_dith[2] di_dith[1] di_dith[0] di_amp_s[3] di_amp_s[2] di_amp_s[1] di_amp_s[0]
+ di_amp_s_b[3] di_amp_s_b[2] di_amp_s_b[1] di_amp_s_b[0] do_qi do_qi_b do_q do_q_b do_q_dec vdd di_en di_rst_b di_dith_en di_qout_en vss
*.iopin vi_p
*.iopin vi_n
*.ipin di_clk
*.ipin di_en
*.opin do_qi
*.opin do_qi_b
*.ipin di_rst_b
*.iopin vdd
*.iopin vss
*.opin do_q
*.opin do_q_b
*.opin do_q_dec
*.ipin di_dith_en
*.ipin di_dith[2],di_dith[1],di_dith[0]
*.ipin di_amp_s[3],di_amp_s[2],di_amp_s[1],di_amp_s[0]
*.ipin di_amp_s_b[3],di_amp_s_b[2],di_amp_s_b[1],di_amp_s_b[0]
*.ipin di_qout_en
XSAL0 di_clk vdd vi_n vi_p d_n d_p vss di_en vg_q[2] vg_q[1] vg_q[0] vg_p[2] vg_p[1] vg_p[0] quantizer2_sal
XINV0 d_p_1 d_p vdd vss sg13cmos5l_inv_1
XINV1 d_p_2 d_p_1 vdd vss sg13cmos5l_inv_2
XGATE_P d_p_b d_p_2 d_preset_b vdd vss sg13cmos5l_nand2_2
XINV3 d_n_1 d_n vdd vss sg13cmos5l_inv_1
XINV4 d_n_2 d_n_1 vdd vss sg13cmos5l_inv_2
XGATE_N d_n_b d_n_2 d_preset vdd vss sg13cmos5l_nor2_2
XNOR0 do_qi d_p_b do_qi_b vdd vss sg13cmos5l_nor2_2
XNOR1 do_qi_b d_n_b do_qi vdd vss sg13cmos5l_nor2_2
XAND_RST d_preset_b di_en di_rst_b vdd vss sg13cmos5l_and2_2
XINV7 d_preset d_preset_b vdd vss sg13cmos5l_inv_4
XPDUMHV1 vdd vss vdd vdd sg13_hv_pmos w=3u l=450n ng=1 m=1 mm_ok=1
XNDUMHV1 vss vdd vss vss sg13_hv_nmos w=1u l=450n ng=1 m=1 mm_ok=1
XPDUMHV vdd vss vdd vdd sg13_hv_pmos w=3u l=450n ng=1 m=1 mm_ok=1
XNDUMHV vss vdd vss vss sg13_hv_nmos w=1u l=450n ng=1 m=1 mm_ok=1
XDITH di_clk di_dith[2] di_dith[1] di_dith[0] di_amp_s[3] di_amp_s[2] di_amp_s[1] di_amp_s[0] di_amp_s_b[3] di_amp_s_b[2]
+ di_amp_s_b[1] di_amp_s_b[0] vi_p vi_n vg_q[2] vg_q[1] vg_q[0] vg_p[2] vg_p[1] vg_p[0] vdd di_en di_dith_en vss quantizer2_dith
XAQ0 net1 do_qi di_qout_en vdd vss sg13cmos5l_and2_1
XQD10 net2 net1 vdd vss sg13cmos5l_inv_1
XQD20 do_q net2 vdd vss sg13cmos5l_inv_2
XAQ1 net3 do_qi_b di_qout_en vdd vss sg13cmos5l_and2_1
XQD11 net4 net3 vdd vss sg13cmos5l_inv_1
XQD21 do_q_b net4 vdd vss sg13cmos5l_inv_2
XDC1 net5 do_qi vdd vss sg13cmos5l_inv_1
XDC2 do_q_dec net5 vdd vss sg13cmos5l_inv_2
XDD1 net6 do_qi_b vdd vss sg13cmos5l_inv_1
XDD2 net7 net6 vdd vss sg13cmos5l_inv_2
XDDL d_qdum_x net7 vss vdd vss sg13cmos5l_and2_1
* noconn d_qdum_x
.ends


.subckt quantizer2_lfsr di_clk di_dith_amp[1] di_dith_amp[0] do_dith[2] do_dith[1] do_dith[0] do_amp_s[3] do_amp_s[2] do_amp_s[1]
+ do_amp_s[0] do_amp_s_b[3] do_amp_s_b[2] do_amp_s_b[1] do_amp_s_b[0] vdd di_dith_en vss
*.ipin di_clk
*.ipin di_dith_en
*.opin do_dith[2],do_dith[1],do_dith[0]
*.ipin di_dith_amp[1],di_dith_amp[0]
*.opin do_amp_s_b[3],do_amp_s_b[2],do_amp_s_b[1],do_amp_s_b[0]
*.opin do_amp_s[3],do_amp_s[2],do_amp_s[1],do_amp_s[0]
*.iopin vdd
*.iopin vss
XFF[16] s[16] di_clk s[13] di_dith_en vdd vss sg13cmos5l_dfrbpq_1
XFF[15] s[15] di_clk s[12] di_dith_en vdd vss sg13cmos5l_dfrbpq_1
XFF[14] s[14] di_clk s[11] di_dith_en vdd vss sg13cmos5l_dfrbpq_1
XFF[13] s[13] di_clk s[10] di_dith_en vdd vss sg13cmos5l_dfrbpq_1
XFF[12] s[12] di_clk s[9] di_dith_en vdd vss sg13cmos5l_dfrbpq_1
XFF[11] s[11] di_clk s[8] di_dith_en vdd vss sg13cmos5l_dfrbpq_1
XFF[10] s[10] di_clk s[7] di_dith_en vdd vss sg13cmos5l_dfrbpq_1
XFF[9] s[9] di_clk s[6] di_dith_en vdd vss sg13cmos5l_dfrbpq_1
XFF[8] s[8] di_clk s[5] di_dith_en vdd vss sg13cmos5l_dfrbpq_1
XFF[7] s[7] di_clk s[4] di_dith_en vdd vss sg13cmos5l_dfrbpq_1
XFF[6] s[6] di_clk s[3] di_dith_en vdd vss sg13cmos5l_dfrbpq_1
XFF[5] s[5] di_clk s[2] di_dith_en vdd vss sg13cmos5l_dfrbpq_1
XFF[4] s[4] di_clk s[1] di_dith_en vdd vss sg13cmos5l_dfrbpq_1
XFF[3] s[3] di_clk s[0] di_dith_en vdd vss sg13cmos5l_dfrbpq_1
XFF[2] s[2] di_clk d_nb[0] di_dith_en vdd vss sg13cmos5l_dfrbpq_1
XFF[1] s[1] di_clk d_nb[1] di_dith_en vdd vss sg13cmos5l_dfrbpq_1
XFF[0] s[0] di_clk d_nb[2] di_dith_en vdd vss sg13cmos5l_dfrbpq_1
XXN[2] d_nb[2] s[11] s[14] vdd vss sg13cmos5l_xnor2_1
XXN[1] d_nb[1] s[12] s[15] vdd vss sg13cmos5l_xnor2_1
XXN[0] d_nb[0] s[13] s[16] vdd vss sg13cmos5l_xnor2_1
XBO[2] do_dith[2] s[0] vdd vss sg13cmos5l_buf_1
XBO[1] do_dith[1] s[1] vdd vss sg13cmos5l_buf_1
XBO[0] do_dith[0] s[2] vdd vss sg13cmos5l_buf_1
XINVA[1] d_a_b[1] di_dith_amp[1] vdd vss sg13cmos5l_inv_1
XINVA[0] d_a_b[0] di_dith_amp[0] vdd vss sg13cmos5l_inv_1
XNORS[3] do_amp_s[3] d_a_b[1] d_a_b[0] vdd vss sg13cmos5l_nor2_1
XNORS[2] do_amp_s[2] d_a_b[1] di_dith_amp[0] vdd vss sg13cmos5l_nor2_1
XNORS[1] do_amp_s[1] di_dith_amp[1] d_a_b[0] vdd vss sg13cmos5l_nor2_1
XNORS[0] do_amp_s[0] di_dith_amp[1] di_dith_amp[0] vdd vss sg13cmos5l_nor2_1
XINVS[3] do_amp_s_b[3] do_amp_s[3] vdd vss sg13cmos5l_inv_1
XINVS[2] do_amp_s_b[2] do_amp_s[2] vdd vss sg13cmos5l_inv_1
XINVS[1] do_amp_s_b[1] do_amp_s[1] vdd vss sg13cmos5l_inv_1
XINVS[0] do_amp_s_b[0] do_amp_s[0] vdd vss sg13cmos5l_inv_1
.ends


.subckt dsm2_osc vdd vss di_osc_en di_clk_sel d_btest_en ibias_in di_clk_ext d_btest_or ibias_pad do_clk_mod do_clk_osc do_osc_oe
*.ipin di_osc_en
*.ipin di_clk_sel
*.opin do_osc_oe
*.ipin d_btest_en
*.opin d_btest_or
*.ipin ibias_in
*.opin ibias_pad
*.iopin vdd
*.iopin vss
*.ipin di_clk_ext
*.opin do_clk_mod
*.opin do_clk_osc
XRX0 vdd vss di_osc_en d_osc_en_b dsm2_io_rx
XI0 d_osc_en d_osc_en_b vdd vss sg13cmos5l_inv_1
XRX1 vdd vss di_clk_sel d_sel_b dsm2_io_rx
XI1 do_osc_oe d_sel_b vdd vss sg13cmos5l_inv_1
XBO d_btest_or d_btest_en d_osc_en vdd vss sg13cmos5l_or2_1
XMSP ibias_pad d_osc_en ibias_in vdd sg13_lv_pmos w=1u l=0.5u ng=1 m=2 mm_ok=1
XMSN ibias_in d_osc_en vg vss sg13_hv_nmos w=1u l=0.45u ng=1 m=1 mm_ok=1
XMD vg vg vss vss sg13_lv_nmos w=0.5u l=0.5u ng=1 m=2 mm_ok=1
XMGD vg d_osc_en_b vss vss sg13_lv_nmos w=0.5u l=0.5u ng=1 m=1 mm_ok=1
XM2 vbp vg vss vss sg13_lv_nmos w=0.5u l=0.5u ng=1 m=1 mm_ok=1
XMPD vbp vbp vdd vdd sg13_lv_pmos w=0.5u l=0.5u ng=1 m=1 mm_ok=1
XMPK vbp d_osc_en vdd vdd sg13_lv_pmos w=0.5u l=0.5u ng=1 m=1 mm_ok=1
XXTP1 net6 vbp vdd vdd sg13_lv_pmos w=0.5u l=0.5u ng=1 m=1 mm_ok=1
XXP1 n1 n5 net6 vdd sg13_lv_pmos w=1u l=0.13u ng=1 m=1 mm_ok=1
XXN1 n1 n5 net7 vss sg13_lv_nmos w=1u l=0.13u ng=1 m=1 mm_ok=1
XXTN1 net7 vg vss vss sg13_lv_nmos w=0.5u l=0.5u ng=1 m=1 mm_ok=1
XXC1 vss n1 vss vss sg13_lv_nmos w=0.5u l=0.5u ng=1 m=1 mm_ok=1
XXK1 n1 d_osc_en_b vss vss sg13_lv_nmos w=0.5u l=0.13u ng=1 m=1 mm_ok=1
XXTP2 net8 vbp vdd vdd sg13_lv_pmos w=0.5u l=0.5u ng=1 m=1 mm_ok=1
XXP2 n2 n1 net8 vdd sg13_lv_pmos w=1u l=0.13u ng=1 m=1 mm_ok=1
XXN2 n2 n1 net9 vss sg13_lv_nmos w=1u l=0.13u ng=1 m=1 mm_ok=1
XXTN2 net9 vg vss vss sg13_lv_nmos w=0.5u l=0.5u ng=1 m=1 mm_ok=1
XXC2 vss n2 vss vss sg13_lv_nmos w=0.5u l=0.5u ng=1 m=1 mm_ok=1
XXK2 n2 d_osc_en vdd vdd sg13_lv_pmos w=0.5u l=0.13u ng=1 m=1 mm_ok=1
XXTP3 net10 vbp vdd vdd sg13_lv_pmos w=0.5u l=0.5u ng=1 m=1 mm_ok=1
XXP3 n3 n2 net10 vdd sg13_lv_pmos w=1u l=0.13u ng=1 m=1 mm_ok=1
XXN3 n3 n2 net11 vss sg13_lv_nmos w=1u l=0.13u ng=1 m=1 mm_ok=1
XXTN3 net11 vg vss vss sg13_lv_nmos w=0.5u l=0.5u ng=1 m=1 mm_ok=1
XXC3 vss n3 vss vss sg13_lv_nmos w=0.5u l=0.5u ng=1 m=1 mm_ok=1
XXK3 n3 d_osc_en_b vss vss sg13_lv_nmos w=0.5u l=0.13u ng=1 m=1 mm_ok=1
XXTP4 net12 vbp vdd vdd sg13_lv_pmos w=0.5u l=0.5u ng=1 m=1 mm_ok=1
XXP4 n4 n3 net12 vdd sg13_lv_pmos w=1u l=0.13u ng=1 m=1 mm_ok=1
XXN4 n4 n3 net13 vss sg13_lv_nmos w=1u l=0.13u ng=1 m=1 mm_ok=1
XXTN4 net13 vg vss vss sg13_lv_nmos w=0.5u l=0.5u ng=1 m=1 mm_ok=1
XXC4 vss n4 vss vss sg13_lv_nmos w=0.5u l=0.5u ng=1 m=1 mm_ok=1
XXK4 n4 d_osc_en vdd vdd sg13_lv_pmos w=0.5u l=0.13u ng=1 m=1 mm_ok=1
XXTP5 net14 vbp vdd vdd sg13_lv_pmos w=0.5u l=0.5u ng=1 m=1 mm_ok=1
XXP5 n5 n4 net14 vdd sg13_lv_pmos w=1u l=0.13u ng=1 m=1 mm_ok=1
XXN5 n5 n4 net15 vss sg13_lv_nmos w=1u l=0.13u ng=1 m=1 mm_ok=1
XXTN5 net15 vg vss vss sg13_lv_nmos w=0.5u l=0.5u ng=1 m=1 mm_ok=1
XXC5 vss n5 vss vss sg13_lv_nmos w=0.5u l=0.5u ng=1 m=1 mm_ok=1
XXK5 n5 d_osc_en_b vss vss sg13_lv_nmos w=0.5u l=0.13u ng=1 m=1 mm_ok=1
XXDN1 vss vss vss vss sg13_lv_nmos w=0.5u l=0.5u ng=1 m=1 mm_ok=1
XXDN2 vss vss vss vss sg13_lv_nmos w=0.5u l=0.5u ng=1 m=1 mm_ok=1
XXDP1 vdd vdd vdd vdd sg13_lv_pmos w=0.5u l=0.5u ng=1 m=1 mm_ok=1
XXDP2 vdd vdd vdd vdd sg13_lv_pmos w=0.5u l=0.5u ng=1 m=1 mm_ok=1
XXSP1 sa n5 vdd vdd sg13_lv_pmos w=0.5u l=0.5u ng=1 m=1 mm_ok=1
XXSP2 r1 n5 sa vdd sg13_lv_pmos w=0.5u l=0.5u ng=1 m=1 mm_ok=1
XXSN2 r1 n5 sb vss sg13_lv_nmos w=0.5u l=0.5u ng=1 m=1 mm_ok=1
XXSN1 sb n5 vss vss sg13_lv_nmos w=0.5u l=0.5u ng=1 m=1 mm_ok=1
XXSP3 vss r1 sa vdd sg13_lv_pmos w=0.5u l=0.5u ng=1 m=1 mm_ok=1
XXSN3 vdd r1 sb vss sg13_lv_nmos w=0.5u l=0.5u ng=1 m=1 mm_ok=1
XR3 net1 r1 vdd vss sg13cmos5l_inv_1
XFF q net2 net1 net2 d_osc_en vdd vss sg13cmos5l_dfrbp_1
XMUX net3 di_clk_ext q do_osc_oe vdd vss sg13cmos5l_mux2_1
XBM do_clk_mod net3 vdd vss sg13cmos5l_buf_2
XA net4 q d_osc_en vdd vss sg13cmos5l_and2_1
XO1 net5 net4 vdd vss sg13cmos5l_inv_1
XO2 do_clk_osc net5 vdd vss sg13cmos5l_inv_2
.ends


.subckt dsm2_io_rx vdd vss di di_b
*.iopin vdd
*.iopin vss
*.ipin di
*.opin di_b
XP0 di_b di vdd vdd sg13_hv_pmos w=0.5u l=1u ng=1 m=1 mm_ok=1
XN0 di_b di vss vss sg13_hv_nmos w=1u l=450n ng=1 m=1 mm_ok=1
.ends


.subckt sg13cmos5l_inv_1 Y A VDD VSS

*.opin Y
*.ipin A
XM1 Y A VSS VSS sg13_lv_nmos w=740.00n l=130.00n ng=1 m=1 mm_ok=1
XM2 Y A VDD VDD sg13_lv_pmos w=1.12u l=130.00n ng=1 m=1 mm_ok=1
.ends


.subckt sg13cmos5l_SecondaryProtection core minus pad plus sub
*.iopin pad
*.iopin core
*.iopin plus
*.iopin minus
*.iopin sub
XR0 core pad sub rppd w=1e-6 l=2e-6 m=1 b=0 mm_ok=1
XD0 core plus dpantenna l=0.64u w=4.98u
XD1 sub core dantenna l=3.1u w=0.64u
.ends


.subckt sw_tgate p m g gb vdd vss
*.iopin vdd
*.iopin vss
*.iopin p
*.iopin m
*.ipin gb
*.ipin g
XMN p g m vss sg13_lv_nmos w=2u l=1u ng=1 m=1 mm_ok=1
XMP p gb m vdd sg13_lv_pmos w=4u l=1u ng=1 m=1 mm_ok=1
XMND1 p gb p vss sg13_lv_nmos w=1u l=1u ng=1 m=1 mm_ok=1
XMND2 m gb m vss sg13_lv_nmos w=1u l=1u ng=1 m=1 mm_ok=1
XMPD1 p g p vdd sg13_lv_pmos w=2u l=1u ng=1 m=1 mm_ok=1
XMPD2 m g m vdd sg13_lv_pmos w=2u l=1u ng=1 m=1 mm_ok=1
.ends
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
