michaelk99/IHP__MPC9724/release/v.1.2.1/netlist/spice/MPC9724.spice

* NGSPICE file created from sg13cmos5l_dsa1_dig_top.ext - technology: ihp-sg13cmos5l

* Black-box entry subcircuit for FILLER2 abstract view
.subckt FILLER2 VSS VDD
.ends

* Black-box entry subcircuit for sg13cmos5l_Filler400 abstract view
.subckt sg13cmos5l_Filler400 iovdd iovss vdd vss
.ends

* Black-box entry subcircuit for WELLTAP abstract view
.subckt WELLTAP VDD VSS
.ends

* Black-box entry subcircuit for DECAPHV32 abstract view
.subckt DECAPHV32 VDD VSS
.ends

* Black-box entry subcircuit for DECAPHV8 abstract view
.subckt DECAPHV8 VDD VSS
.ends

* Black-box entry subcircuit for sg13cmos5l_Filler4000 abstract view
.subckt sg13cmos5l_Filler4000 iovdd iovss vdd vss
.ends

* Black-box entry subcircuit for FILLER4 abstract view
.subckt FILLER4 VDD VSS
.ends

* Black-box entry subcircuit for sg13cmos5l_ip__clamp_vddvss abstract view
.subckt sg13cmos5l_ip__clamp_vddvss iovdd iovss vdd vss
.ends

* Black-box entry subcircuit for DECAPHV16 abstract view
.subckt DECAPHV16 VDD VSS
.ends

* Black-box entry subcircuit for BUFX12 abstract view
.subckt BUFX12 A VDD VSS Y
.ends

* Black-box entry subcircuit for FILLER1 abstract view
.subckt FILLER1 VDD VSS
.ends

* Black-box entry subcircuit for sg13cmos5l_ip__bondpad_70x70 abstract view
.subckt sg13cmos5l_ip__bondpad_70x70 pad
.ends

* Black-box entry subcircuit for sg13cmos5l_IOPadInOut4mA abstract view
.subckt sg13cmos5l_IOPadInOut4mA c2p c2p_en iovdd iovss p2c pad vdd vss
.ends

* Black-box entry subcircuit for sg13cmos5l_Filler1000 abstract view
.subckt sg13cmos5l_Filler1000 iovdd iovss vdd vss
.ends

* Black-box entry subcircuit for DFFRQX1 abstract view
.subckt DFFRQX1 CK D Q RB VDD VSS
.ends

* Black-box entry subcircuit for sg13cmos5l_IOPadVss abstract view
.subckt sg13cmos5l_IOPadVss iovdd iovss vdd vss
.ends

* Black-box entry subcircuit for sg13cmos5l_Filler2000 abstract view
.subckt sg13cmos5l_Filler2000 iovdd iovss vdd vss
.ends

* Black-box entry subcircuit for sg13cmos5l_ip__title abstract view
.subckt sg13cmos5l_ip__title
.ends

* Black-box entry subcircuit for sg13cmos5l_IOPadOut30mA abstract view
.subckt sg13cmos5l_IOPadOut30mA c2p iovdd iovss pad vdd vss
.ends

* Black-box entry subcircuit for sg13cmos5l_Corner abstract view
.subckt sg13cmos5l_Corner iovdd iovss vdd vss
.ends

* Black-box entry subcircuit for sg13cmos5l_IOPadAnalog abstract view
.subckt sg13cmos5l_IOPadAnalog iovdd iovss pad padbare padres vdd vss
.ends

* Black-box entry subcircuit for sg13cmos5l_IOPadVdd abstract view
.subckt sg13cmos5l_IOPadVdd iovdd iovss vdd vss
.ends

* Black-box entry subcircuit for XNOR2X1 abstract view
.subckt XNOR2X1 A B VDD VSS Y
.ends

* Black-box entry subcircuit for sg13cmos5l_IOPadOut4mA abstract view
.subckt sg13cmos5l_IOPadOut4mA c2p iovdd iovss pad vdd vss
.ends

* Black-box entry subcircuit for sg13cmos5l_IOPadIOVdd abstract view
.subckt sg13cmos5l_IOPadIOVdd iovdd iovss vdd vss
.ends

* Black-box entry subcircuit for sg13cmos5l_IOPadIOVss abstract view
.subckt sg13cmos5l_IOPadIOVss iovdd iovss vdd vss
.ends

* Black-box entry subcircuit for decap_vdda abstract view
.subckt decap_vdda VDD VSS
.ends

* Black-box entry subcircuit for sg13cmos5l_ip__jku abstract view
.subckt sg13cmos5l_ip__jku
.ends

* Black-box entry subcircuit for XOR2X1 abstract view
.subckt XOR2X1 A B VDD VSS Y
.ends

* Black-box entry subcircuit for sg13cmos5l_IOPadIn abstract view
.subckt sg13cmos5l_IOPadIn iovdd iovss p2c pad vdd vss
.ends

* Black-box entry subcircuit for BUFX3 abstract view
.subckt BUFX3 A VDD VSS Y
.ends

* Black-box entry subcircuit for sg13cmos5l_ip__cut_vdd abstract view
.subckt sg13cmos5l_ip__cut_vdd iovdd iovss vss
.ends

* Black-box entry subcircuit for dsa1_dig_top abstract view
.subckt dsa1_dig_top VDD VSS adc_conv clk data_in miso mosi o_aux_ctrl[0] o_aux_ctrl[10]
+ o_aux_ctrl[11] o_aux_ctrl[12] o_aux_ctrl[13] o_aux_ctrl[14] o_aux_ctrl[15] o_aux_ctrl[1]
+ o_aux_ctrl[2] o_aux_ctrl[3] o_aux_ctrl[4] o_aux_ctrl[5] o_aux_ctrl[6] o_aux_ctrl[7]
+ o_aux_ctrl[8] o_aux_ctrl[9] o_bias_cfg[0] o_bias_cfg[10] o_bias_cfg[11] o_bias_cfg[12]
+ o_bias_cfg[13] o_bias_cfg[14] o_bias_cfg[15] o_bias_cfg[16] o_bias_cfg[17] o_bias_cfg[18]
+ o_bias_cfg[19] o_bias_cfg[1] o_bias_cfg[20] o_bias_cfg[21] o_bias_cfg[22] o_bias_cfg[23]
+ o_bias_cfg[24] o_bias_cfg[25] o_bias_cfg[26] o_bias_cfg[27] o_bias_cfg[28] o_bias_cfg[29]
+ o_bias_cfg[2] o_bias_cfg[30] o_bias_cfg[31] o_bias_cfg[32] o_bias_cfg[33] o_bias_cfg[34]
+ o_bias_cfg[3] o_bias_cfg[4] o_bias_cfg[5] o_bias_cfg[6] o_bias_cfg[7] o_bias_cfg[8]
+ o_bias_cfg[9] o_clk_cfg[0] o_clk_cfg[10] o_clk_cfg[11] o_clk_cfg[12] o_clk_cfg[13]
+ o_clk_cfg[14] o_clk_cfg[15] o_clk_cfg[16] o_clk_cfg[17] o_clk_cfg[18] o_clk_cfg[1]
+ o_clk_cfg[2] o_clk_cfg[3] o_clk_cfg[4] o_clk_cfg[5] o_clk_cfg[6] o_clk_cfg[7] o_clk_cfg[8]
+ o_clk_cfg[9] o_en_ctrl[0] o_en_ctrl[10] o_en_ctrl[1] o_en_ctrl[2] o_en_ctrl[3] o_en_ctrl[4]
+ o_en_ctrl[5] o_en_ctrl[6] o_en_ctrl[7] o_en_ctrl[8] o_en_ctrl[9] o_lf_cfg[0] o_lf_cfg[10]
+ o_lf_cfg[11] o_lf_cfg[12] o_lf_cfg[13] o_lf_cfg[14] o_lf_cfg[15] o_lf_cfg[1] o_lf_cfg[2]
+ o_lf_cfg[3] o_lf_cfg[4] o_lf_cfg[5] o_lf_cfg[6] o_lf_cfg[7] o_lf_cfg[8] o_lf_cfg[9]
+ o_rst_ctrl_b[0] o_rst_ctrl_b[1] o_tst_ctrl[0] o_tst_ctrl[10] o_tst_ctrl[11] o_tst_ctrl[12]
+ o_tst_ctrl[13] o_tst_ctrl[14] o_tst_ctrl[15] o_tst_ctrl[1] o_tst_ctrl[2] o_tst_ctrl[3]
+ o_tst_ctrl[4] o_tst_ctrl[5] o_tst_ctrl[6] o_tst_ctrl[7] o_tst_ctrl[8] o_tst_ctrl[9]
+ o_uwb_tx_cfg[0] o_uwb_tx_cfg[10] o_uwb_tx_cfg[11] o_uwb_tx_cfg[12] o_uwb_tx_cfg[13]
+ o_uwb_tx_cfg[14] o_uwb_tx_cfg[15] o_uwb_tx_cfg[16] o_uwb_tx_cfg[17] o_uwb_tx_cfg[18]
+ o_uwb_tx_cfg[19] o_uwb_tx_cfg[1] o_uwb_tx_cfg[20] o_uwb_tx_cfg[21] o_uwb_tx_cfg[22]
+ o_uwb_tx_cfg[23] o_uwb_tx_cfg[24] o_uwb_tx_cfg[25] o_uwb_tx_cfg[26] o_uwb_tx_cfg[27]
+ o_uwb_tx_cfg[28] o_uwb_tx_cfg[29] o_uwb_tx_cfg[2] o_uwb_tx_cfg[3] o_uwb_tx_cfg[4]
+ o_uwb_tx_cfg[5] o_uwb_tx_cfg[6] o_uwb_tx_cfg[7] o_uwb_tx_cfg[8] o_uwb_tx_cfg[9]
+ rst_b sclk ss
.ends

* Black-box entry subcircuit for NAND4BX1 abstract view
.subckt NAND4BX1 AB B C D VDD VSS Y
.ends

* Black-box entry subcircuit for NOR2X1 abstract view
.subckt NOR2X1 A B VDD VSS Y
.ends

* Black-box entry subcircuit for AOI2B1X1 abstract view
.subckt AOI2B1X1 AB B C VDD VSS Y
.ends

* Black-box entry subcircuit for sg13cmos5l_ip__helm abstract view
.subckt sg13cmos5l_ip__helm
.ends

* Black-box entry subcircuit for AND3BX1 abstract view
.subckt AND3BX1 AB B C VDD VSS Y
.ends

* Black-box entry subcircuit for dsm2_core abstract view
.subckt dsm2_core di_btest_en di_clk di_clk_sel di_dith_amp[0] di_dith_amp[1] di_dith_en
+ di_ena di_osc_en di_qout_en di_rst_b di_trim[0] di_trim[1] di_trim[2] di_trim[3]
+ di_vcm_ext do_clk_osc do_osc_oe do_q do_q_b do_q_dec ibias_test vcm vdd vi vss
.ends

* Black-box entry subcircuit for sg13cmos5l_ip__jku_names abstract view
.subckt sg13cmos5l_ip__jku_names
.ends

* Black-box entry subcircuit for MUX2X1 abstract view
.subckt MUX2X1 A0 A1 S0 VDD VSS Y
.ends

* Black-box entry subcircuit for NOR2BX1 abstract view
.subckt NOR2BX1 AB B VDD VSS Y
.ends

* Black-box entry subcircuit for AO31X1 abstract view
.subckt AO31X1 A B C D VDD VSS Y
.ends

* Black-box entry subcircuit for AND2X1 abstract view
.subckt AND2X1 A B VDD VSS Y
.ends

* Black-box entry subcircuit for INVX1 abstract view
.subckt INVX1 A VDD VSS Y
.ends

* Black-box entry subcircuit for ANTENNA2 abstract view
.subckt ANTENNA2 A VDD VSS
.ends

.subckt MPC9724 IOVDD IOVSS VDD VDDA VSS analog_PAD[0] analog_PAD[1]
+ analog_PAD[2] clk_PAD do_q_PAD do_q_b_PAD dsm_clk_PAD input_PAD[0] input_PAD[1]
+ input_PAD[2] input_PAD[3] output_PAD[0] output_PAD[1] rst_n_PAD
XFILLER_22_133 VSS VDD FILLER2
XIO_FILL_IO_NORTH_1_20 IOVDD IOVSS VDD VSS sg13cmos5l_Filler400
XTAP_TAPCELL_ROW_8_1_134 VDD VSS WELLTAP
XTAP_TAPCELL_ROW_176_1_247 VDD VSS WELLTAP
XFILLER_1_593 VDD VSS DECAPHV32
XFILLER_10_125 VDD VSS DECAPHV8
XFILLER_6_129 VDD VSS DECAPHV8
XFILLER_12_43 VSS VDD FILLER2
XFILLER_15_965 VDD VSS DECAPHV32
XFILLER_14_453 VDD VSS DECAPHV32
XFILLER_5_184 VSS VDD FILLER2
XTAP_TAPCELL_ROW_7_1_122 VDD VSS WELLTAP
XTAP_TAPCELL_ROW_175_1_235 VDD VSS WELLTAP
XFILLER_12_935 VDD VSS DECAPHV8
XFILLER_3_1393 VSS VDD FILLER2
XFILLER_19_556 VSS VDD FILLER2
XFILLER_4_1168 VSS VDD FILLER2
XFILLER_9_55 VDD VSS DECAPHV32
XFILLER_9_1013 VDD VSS DECAPHV8
XFILLER_4_408 VDD VSS DECAPHV32
XFILLER_12_710 VDD VSS DECAPHV8
XFILLER_3_463 VSS VDD FILLER2
XTAP_TAPCELL_ROW_174_1_234 VDD VSS WELLTAP
XTAP_TAPCELL_ROW_6_1_110 VDD VSS WELLTAP
XFILLER_19_375 VDD VSS DECAPHV32
XIO_FILL_IO_SOUTH_3_0 IOVDD IOVSS VDD VSS sg13cmos5l_Filler4000
XFILLER_6_290 VDD VSS DECAPHV8
XIO_FILL_IO_NORTH_4_20 IOVDD IOVSS VDD VSS sg13cmos5l_Filler400
XTAP_TAPCELL_ROW_5_1_312 VDD VSS WELLTAP
XFILLER_0_1385 VDD VSS DECAPHV8
XFILLER_20_32 VDD VSS DECAPHV8
XFILLER_17_835 VSS VDD FILLER2
XFILLER_16_323 VSS VDD FILLER2
XTAP_TAPCELL_ROW_9_1_147 VDD VSS WELLTAP
XFILLER_3_282 VDD VSS DECAPHV32
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
XFILLER_21_314 VDD VSS DECAPHV32
Xg_iovss_pads\[0\].iovss_pad IOVDD IOVSS VDD VSS sg13cmos5l_IOPadIOVss
XIO_CORNER_NORTH_WEST_INST IOVDD IOVSS VDD VSS sg13cmos5l_Corner
XFILLER_12_336 VDD VSS FILLER1
XFILLER_21_96 VDD VSS DECAPHV32
XFILLER_0_763 VSS VDD FILLER2
XFILLER_7_32 VDD VSS DECAPHV32
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
