michaelk99/IHP__MPC9724/netlist/nl/sg13cmos5l_dsa1_dig_top.nl.v

module sg13cmos5l_dsa1_dig_top (clk_PAD,
    do_q_PAD,
    do_q_b_PAD,
    dsm_clk_PAD,
    rst_n_PAD,
    analog_PAD,
    input_PAD,
    output_PAD);
 inout clk_PAD;
 inout do_q_PAD;
 inout do_q_b_PAD;
 inout dsm_clk_PAD;
 inout rst_n_PAD;
 inout [2:0] analog_PAD;
 inout [3:0] input_PAD;
 inout [1:0] output_PAD;

 wire _00_;
 wire _01_;
 wire _02_;
 wire _03_;
 wire _04_;
 wire _05_;
 wire _06_;
 wire _07_;
 wire _08_;
 wire _09_;
 wire clk_PAD2CORE;
 wire do_clk_osc;
 wire do_osc_oe;
 wire dsm_clk_PAD2CORE;
 wire dsm_do_q;
 wire dsm_do_q_b;
 wire dsm_do_q_dec;
 wire dsm_ena;
 wire dsm_qout_en;
 wire dsm_rst_b;
 wire \i_sg13cmos5l_dsa1_dig_core.adc_conv ;
 wire \i_sg13cmos5l_dsa1_dig_core.data_in_pad ;
 wire \i_sg13cmos5l_dsa1_dig_core.data_in_s1 ;
 wire \i_sg13cmos5l_dsa1_dig_core.data_in_s2 ;
 wire \i_sg13cmos5l_dsa1_dig_core.data_in_s3 ;
 wire \i_sg13cmos5l_dsa1_dig_core.dsm_bit ;
 wire \i_sg13cmos5l_dsa1_dig_core.miso ;
 wire \i_sg13cmos5l_dsa1_dig_core.mosi ;
 wire \i_sg13cmos5l_dsa1_dig_core.o_aux_ctrl[0] ;
 wire \i_sg13cmos5l_dsa1_dig_core.o_aux_ctrl[10] ;
 wire \i_sg13cmos5l_dsa1_dig_core.o_aux_ctrl[11] ;
 wire \i_sg13cmos5l_dsa1_dig_core.o_aux_ctrl[12] ;
 wire \i_sg13cmos5l_dsa1_dig_core.o_aux_ctrl[13] ;
 wire \i_sg13cmos5l_dsa1_dig_core.o_aux_ctrl[14] ;
 wire \i_sg13cmos5l_dsa1_dig_core.o_aux_ctrl[15] ;
 wire \i_sg13cmos5l_dsa1_dig_core.o_aux_ctrl[1] ;
 wire \i_sg13cmos5l_dsa1_dig_core.o_aux_ctrl[2] ;
 wire \i_sg13cmos5l_dsa1_dig_core.o_aux_ctrl[3] ;
 wire \i_sg13cmos5l_dsa1_dig_core.o_aux_ctrl[4] ;
 wire \i_sg13cmos5l_dsa1_dig_core.o_aux_ctrl[5] ;
 wire \i_sg13cmos5l_dsa1_dig_core.o_aux_ctrl[6] ;
 wire \i_sg13cmos5l_dsa1_dig_core.o_aux_ctrl[7] ;
 wire \i_sg13cmos5l_dsa1_dig_core.o_aux_ctrl[8] ;
 wire \i_sg13cmos5l_dsa1_dig_core.o_aux_ctrl[9] ;
 wire \i_sg13cmos5l_dsa1_dig_core.o_bias_cfg[0] ;
 wire \i_sg13cmos5l_dsa1_dig_core.o_bias_cfg[10] ;
 wire \i_sg13cmos5l_dsa1_dig_core.o_bias_cfg[11] ;
 wire \i_sg13cmos5l_dsa1_dig_core.o_bias_cfg[12] ;
 wire \i_sg13cmos5l_dsa1_dig_core.o_bias_cfg[13] ;
 wire \i_sg13cmos5l_dsa1_dig_core.o_bias_cfg[14] ;
 wire \i_sg13cmos5l_dsa1_dig_core.o_bias_cfg[15] ;
 wire \i_sg13cmos5l_dsa1_dig_core.o_bias_cfg[16] ;
 wire \i_sg13cmos5l_dsa1_dig_core.o_bias_cfg[17] ;
 wire \i_sg13cmos5l_dsa1_dig_core.o_bias_cfg[18] ;
 wire \i_sg13cmos5l_dsa1_dig_core.o_bias_cfg[19] ;
 wire \i_sg13cmos5l_dsa1_dig_core.o_bias_cfg[1] ;
 wire \i_sg13cmos5l_dsa1_dig_core.o_bias_cfg[20] ;
 wire \i_sg13cmos5l_dsa1_dig_core.o_bias_cfg[21] ;
 wire \i_sg13cmos5l_dsa1_dig_core.o_bias_cfg[22] ;
 wire \i_sg13cmos5l_dsa1_dig_core.o_bias_cfg[23] ;
 wire \i_sg13cmos5l_dsa1_dig_core.o_bias_cfg[24] ;
 wire \i_sg13cmos5l_dsa1_dig_core.o_bias_cfg[25] ;
 wire \i_sg13cmos5l_dsa1_dig_core.o_bias_cfg[26] ;
 wire \i_sg13cmos5l_dsa1_dig_core.o_bias_cfg[27] ;
 wire \i_sg13cmos5l_dsa1_dig_core.o_bias_cfg[28] ;
 wire \i_sg13cmos5l_dsa1_dig_core.o_bias_cfg[29] ;
 wire \i_sg13cmos5l_dsa1_dig_core.o_bias_cfg[2] ;
 wire \i_sg13cmos5l_dsa1_dig_core.o_bias_cfg[30] ;
 wire \i_sg13cmos5l_dsa1_dig_core.o_bias_cfg[31] ;
 wire \i_sg13cmos5l_dsa1_dig_core.o_bias_cfg[32] ;
 wire \i_sg13cmos5l_dsa1_dig_core.o_bias_cfg[33] ;
 wire \i_sg13cmos5l_dsa1_dig_core.o_bias_cfg[34] ;
 wire \i_sg13cmos5l_dsa1_dig_core.o_bias_cfg[3] ;
 wire \i_sg13cmos5l_dsa1_dig_core.o_bias_cfg[4] ;
 wire \i_sg13cmos5l_dsa1_dig_core.o_bias_cfg[5] ;
 wire \i_sg13cmos5l_dsa1_dig_core.o_bias_cfg[6] ;
 wire \i_sg13cmos5l_dsa1_dig_core.o_bias_cfg[7] ;
 wire \i_sg13cmos5l_dsa1_dig_core.o_bias_cfg[8] ;
 wire \i_sg13cmos5l_dsa1_dig_core.o_bias_cfg[9] ;
 wire \i_sg13cmos5l_dsa1_dig_core.o_clk_cfg[0] ;
 wire \i_sg13cmos5l_dsa1_dig_core.o_clk_cfg[10] ;
 wire \i_sg13cmos5l_dsa1_dig_core.o_clk_cfg[11] ;
 wire \i_sg13cmos5l_dsa1_dig_core.o_clk_cfg[12] ;
 wire \i_sg13cmos5l_dsa1_dig_core.o_clk_cfg[13] ;
 wire \i_sg13cmos5l_dsa1_dig_core.o_clk_cfg[14] ;
 wire \i_sg13cmos5l_dsa1_dig_core.o_clk_cfg[15] ;
 wire \i_sg13cmos5l_dsa1_dig_core.o_clk_cfg[16] ;
 wire \i_sg13cmos5l_dsa1_dig_core.o_clk_cfg[17] ;
 wire \i_sg13cmos5l_dsa1_dig_core.o_clk_cfg[18] ;
 wire \i_sg13cmos5l_dsa1_dig_core.o_clk_cfg[1] ;
 wire \i_sg13cmos5l_dsa1_dig_core.o_clk_cfg[2] ;
 wire \i_sg13cmos5l_dsa1_dig_core.o_clk_cfg[3] ;
 wire \i_sg13cmos5l_dsa1_dig_core.o_clk_cfg[4] ;
 wire \i_sg13cmos5l_dsa1_dig_core.o_clk_cfg[5] ;
 wire \i_sg13cmos5l_dsa1_dig_core.o_clk_cfg[6] ;
 wire \i_sg13cmos5l_dsa1_dig_core.o_clk_cfg[7] ;
 wire \i_sg13cmos5l_dsa1_dig_core.o_clk_cfg[8] ;
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
 sg13cmos5l_ip__bondpad_70x70 IO_BOND_dsm_clk_pad (.pad(dsm_clk_PAD));
 sg13cmos5l_ip__bondpad_70x70 \IO_BOND_g_inputs[0].input_pad  (.pad(input_PAD[0]));
 sg13cmos5l_ip__bondpad_70x70 \IO_BOND_g_inputs[1].input_pad  (.pad(input_PAD[1]));
 sg13cmos5l_ip__bondpad_70x70 \IO_BOND_g_inputs[2].input_pad  (.pad(input_PAD[2]));
 sg13cmos5l_ip__bondpad_70x70 \IO_BOND_g_inputs[3].input_pad  (.pad(input_PAD[3]));
 sg13cmos5l_ip__bondpad_70x70 \IO_BOND_g_iovdd_pads[0].iovdd_pad  (.pad(IOVDD));
 sg13cmos5l_ip__bondpad_70x70 \IO_BOND_g_iovdd_pads[1].iovdd_pad  (.pad(IOVDD));
 sg13cmos5l_ip__bondpad_70x70 \IO_BOND_g_iovss_pads[0].iovss_pad  (.pad(IOVSS));
 sg13cmos5l_ip__bondpad_70x70 \IO_BOND_g_outputs[0].output_pad  (.pad(output_PAD[0]));
 sg13cmos5l_ip__bondpad_70x70 \IO_BOND_g_outputs[1].output_pad  (.pad(output_PAD[1]));
 sg13cmos5l_ip__bondpad_70x70 \IO_BOND_g_vdd_pads[0].vdd_pad  (.pad(VDD));
 sg13cmos5l_ip__bondpad_70x70 \IO_BOND_g_vss_pads[0].vss_pad  (.pad(VSS));
 sg13cmos5l_ip__bondpad_70x70 \IO_BOND_g_vss_pads[1].vss_pad  (.pad(VSS));
 sg13cmos5l_ip__bondpad_70x70 IO_BOND_ib_pad (.pad(analog_PAD[2]));
 sg13cmos5l_ip__bondpad_70x70 IO_BOND_rst_n_pad (.pad(rst_n_PAD));
 sg13cmos5l_ip__bondpad_70x70 IO_BOND_vcm_pad (.pad(analog_PAD[1]));
 sg13cmos5l_ip__bondpad_70x70 IO_BOND_vdda_pad (.pad(VDDA));
 sg13cmos5l_ip__bondpad_70x70 IO_BOND_vi_pad (.pad(analog_PAD[0]));
 sg13cmos5l_Corner IO_CORNER_NORTH_EAST_INST ();
 sg13cmos5l_Corner IO_CORNER_NORTH_WEST_INST ();
 sg13cmos5l_Corner IO_CORNER_SOUTH_EAST_INST ();
 sg13cmos5l_Corner IO_CORNER_SOUTH_WEST_INST ();
 sg13cmos5l_Filler4000 IO_FILL_IO_EAST_0_0 ();
 sg13cmos5l_Filler2000 IO_FILL_IO_EAST_0_20 ();
 sg13cmos5l_Filler4000 IO_FILL_IO_EAST_1_0 ();
 sg13cmos5l_Filler2000 IO_FILL_IO_EAST_1_20 ();
 sg13cmos5l_Filler4000 IO_FILL_IO_EAST_2_0 ();
 sg13cmos5l_Filler2000 IO_FILL_IO_EAST_2_20 ();
 sg13cmos5l_Filler4000 IO_FILL_IO_EAST_3_0 ();
 sg13cmos5l_Filler2000 IO_FILL_IO_EAST_3_20 ();
 sg13cmos5l_Filler4000 IO_FILL_IO_EAST_4_0 ();
 sg13cmos5l_Filler2000 IO_FILL_IO_EAST_4_20 ();
 sg13cmos5l_Filler4000 IO_FILL_IO_EAST_5_0 ();
 sg13cmos5l_Filler2000 IO_FILL_IO_EAST_5_20 ();
 sg13cmos5l_Filler4000 IO_FILL_IO_EAST_6_0 ();
 sg13cmos5l_Filler2000 IO_FILL_IO_EAST_6_20 ();
 sg13cmos5l_Filler4000 IO_FILL_IO_NORTH_0_0 ();
 sg13cmos5l_Filler2000 IO_FILL_IO_NORTH_0_20 ();
 sg13cmos5l_Filler4000 IO_FILL_IO_NORTH_1_0 ();
 sg13cmos5l_Filler400 IO_FILL_IO_NORTH_1_20 ();
 sg13cmos5l_Filler400 IO_FILL_IO_NORTH_1_22 ();
 sg13cmos5l_Filler4000 IO_FILL_IO_NORTH_2_0 ();
 sg13cmos5l_Filler400 IO_FILL_IO_NORTH_2_20 ();
 sg13cmos5l_Filler400 IO_FILL_IO_NORTH_2_22 ();
 sg13cmos5l_Filler4000 IO_FILL_IO_NORTH_3_0 ();
 sg13cmos5l_Filler400 IO_FILL_IO_NORTH_3_20 ();
 sg13cmos5l_Filler400 IO_FILL_IO_NORTH_3_22 ();
 sg13cmos5l_Filler4000 IO_FILL_IO_NORTH_4_0 ();
 sg13cmos5l_Filler400 IO_FILL_IO_NORTH_4_20 ();
 sg13cmos5l_Filler400 IO_FILL_IO_NORTH_4_22 ();
 sg13cmos5l_Filler4000 IO_FILL_IO_NORTH_5_0 ();
 sg13cmos5l_Filler400 IO_FILL_IO_NORTH_5_20 ();
 sg13cmos5l_Filler400 IO_FILL_IO_NORTH_5_22 ();
 sg13cmos5l_Filler4000 IO_FILL_IO_NORTH_6_0 ();
 sg13cmos5l_Filler2000 IO_FILL_IO_NORTH_6_20 ();
 sg13cmos5l_Filler4000 IO_FILL_IO_SOUTH_0_0 ();
 sg13cmos5l_Filler1000 IO_FILL_IO_SOUTH_0_20 ();
 sg13cmos5l_Filler4000 IO_FILL_IO_SOUTH_1_0 ();
 sg13cmos5l_Filler4000 IO_FILL_IO_SOUTH_2_0 ();
 sg13cmos5l_Filler4000 IO_FILL_IO_SOUTH_3_0 ();
 sg13cmos5l_Filler4000 IO_FILL_IO_SOUTH_4_0 ();
 sg13cmos5l_Filler4000 IO_FILL_IO_SOUTH_5_0 ();
 sg13cmos5l_Filler4000 IO_FILL_IO_SOUTH_6_0 ();
 sg13cmos5l_Filler4000 IO_FILL_IO_SOUTH_7_0 ();
 sg13cmos5l_Filler1000 IO_FILL_IO_SOUTH_7_20 ();
 sg13cmos5l_Filler4000 IO_FILL_IO_WEST_0_0 ();
 sg13cmos5l_Filler4000 IO_FILL_IO_WEST_1_0 ();
 sg13cmos5l_Filler4000 IO_FILL_IO_WEST_2_0 ();
 sg13cmos5l_Filler4000 IO_FILL_IO_WEST_3_0 ();
 sg13cmos5l_Filler4000 IO_FILL_IO_WEST_4_0 ();
 sg13cmos5l_Filler4000 IO_FILL_IO_WEST_5_0 ();
 sg13cmos5l_Filler4000 IO_FILL_IO_WEST_6_0 ();
 WELLTAP TAP_TAPCELL_ROW_0_0 ();
 WELLTAP TAP_TAPCELL_ROW_0_1 ();
 WELLTAP TAP_TAPCELL_ROW_0_10 ();
 WELLTAP TAP_TAPCELL_ROW_0_11 ();
 WELLTAP TAP_TAPCELL_ROW_0_12 ();
 WELLTAP TAP_TAPCELL_ROW_0_13 ();
 WELLTAP TAP_TAPCELL_ROW_0_14 ();
 WELLTAP TAP_TAPCELL_ROW_0_15 ();
 WELLTAP TAP_TAPCELL_ROW_0_16 ();
 WELLTAP TAP_TAPCELL_ROW_0_17 ();
 WELLTAP TAP_TAPCELL_ROW_0_18 ();
 WELLTAP TAP_TAPCELL_ROW_0_19 ();
 WELLTAP TAP_TAPCELL_ROW_0_2 ();
 WELLTAP TAP_TAPCELL_ROW_0_20 ();
 WELLTAP TAP_TAPCELL_ROW_0_21 ();
 WELLTAP TAP_TAPCELL_ROW_0_22 ();
 WELLTAP TAP_TAPCELL_ROW_0_23 ();
 WELLTAP TAP_TAPCELL_ROW_0_24 ();
 WELLTAP TAP_TAPCELL_ROW_0_25 ();
 WELLTAP TAP_TAPCELL_ROW_0_26 ();
 WELLTAP TAP_TAPCELL_ROW_0_27 ();
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
 WELLTAP TAP_TAPCELL_ROW_7_1_124 ();
 WELLTAP TAP_TAPCELL_ROW_7_1_125 ();
 WELLTAP TAP_TAPCELL_ROW_7_1_126 ();
 WELLTAP TAP_TAPCELL_ROW_7_1_127 ();
 WELLTAP TAP_TAPCELL_ROW_8_1_128 ();
 WELLTAP TAP_TAPCELL_ROW_8_1_129 ();
 WELLTAP TAP_TAPCELL_ROW_8_1_130 ();
 WELLTAP TAP_TAPCELL_ROW_8_1_131 ();
 WELLTAP TAP_TAPCELL_ROW_8_1_132 ();
 WELLTAP TAP_TAPCELL_ROW_8_1_133 ();
 WELLTAP TAP_TAPCELL_ROW_8_1_134 ();
 WELLTAP TAP_TAPCELL_ROW_8_1_135 ();
 WELLTAP TAP_TAPCELL_ROW_8_1_136 ();
 WELLTAP TAP_TAPCELL_ROW_8_1_137 ();
 WELLTAP TAP_TAPCELL_ROW_8_1_138 ();
 WELLTAP TAP_TAPCELL_ROW_9_1_139 ();
 WELLTAP TAP_TAPCELL_ROW_9_1_140 ();
 WELLTAP TAP_TAPCELL_ROW_9_1_141 ();
 WELLTAP TAP_TAPCELL_ROW_9_1_142 ();
 WELLTAP TAP_TAPCELL_ROW_9_1_143 ();
 WELLTAP TAP_TAPCELL_ROW_9_1_144 ();
 WELLTAP TAP_TAPCELL_ROW_9_1_145 ();
 WELLTAP TAP_TAPCELL_ROW_9_1_146 ();
 WELLTAP TAP_TAPCELL_ROW_9_1_147 ();
 WELLTAP TAP_TAPCELL_ROW_9_1_148 ();
 INVX1 _10_ (.Y(dsm_qout_en),
    .A(\i_sg13cmos5l_dsa1_dig_core.o_bias_cfg[24] ));
 INVX1 _11_ (.Y(dsm_ena),
    .A(\i_sg13cmos5l_dsa1_dig_core.o_bias_cfg[19] ));
 NOR2X1 _12_ (.A(\i_sg13cmos5l_dsa1_dig_core.rst_cnt[1] ),
    .Y(_06_),
    .B(\i_sg13cmos5l_dsa1_dig_core.rst_cnt[2] ));
 AO31X1 _13_ (.A(\i_sg13cmos5l_dsa1_dig_core.rst_cnt[0] ),
    .B(\i_sg13cmos5l_dsa1_dig_core.rst_cnt[3] ),
    .C(_06_),
    .D(\i_sg13cmos5l_dsa1_dig_core.rst_done ),
    .Y(_01_));
 NOR2BX1 _14_ (.AB(\i_sg13cmos5l_dsa1_dig_core.rst_done ),
    .Y(dsm_rst_b),
    .B(\i_sg13cmos5l_dsa1_dig_core.o_bias_cfg[20] ));
 MUX2X1 _15_ (.A0(\i_sg13cmos5l_dsa1_dig_core.data_in_pad ),
    .A1(\i_sg13cmos5l_dsa1_dig_core.dsm_bit ),
    .S0(\i_sg13cmos5l_dsa1_dig_core.o_bias_cfg[21] ),
    .Y(_00_));
 AND3BX1 _16_ (.AB(\i_sg13cmos5l_dsa1_dig_core.rst_done ),
    .B(\i_sg13cmos5l_dsa1_dig_core.rst_cnt[1] ),
    .C(\i_sg13cmos5l_dsa1_dig_core.rst_cnt[0] ),
    .Y(_07_));
 AOI2B1X1 _17_ (.Y(_08_),
    .C(\i_sg13cmos5l_dsa1_dig_core.rst_cnt[1] ),
    .B(\i_sg13cmos5l_dsa1_dig_core.rst_cnt[0] ),
    .AB(\i_sg13cmos5l_dsa1_dig_core.rst_done ));
 NOR2X1 _18_ (.A(_07_),
    .Y(_02_),
    .B(_08_));
 NAND4BX1 _19_ (.AB(\i_sg13cmos5l_dsa1_dig_core.rst_done ),
    .B(\i_sg13cmos5l_dsa1_dig_core.rst_cnt[2] ),
    .C(\i_sg13cmos5l_dsa1_dig_core.rst_cnt[1] ),
    .D(\i_sg13cmos5l_dsa1_dig_core.rst_cnt[0] ),
    .Y(_09_));
 XOR2X1 _20_ (.A(\i_sg13cmos5l_dsa1_dig_core.rst_cnt[2] ),
    .B(_07_),
    .Y(_03_));
 XNOR2X1 _21_ (.A(\i_sg13cmos5l_dsa1_dig_core.rst_cnt[3] ),
    .B(_09_),
    .Y(_04_));
 XNOR2X1 _22_ (.A(\i_sg13cmos5l_dsa1_dig_core.rst_cnt[0] ),
    .B(\i_sg13cmos5l_dsa1_dig_core.rst_done ),
    .Y(_05_));
 DFFRQX1 _23_ (.CK(clknet_1_0__leaf_clk_PAD2CORE_regs),
    .D(_05_),
    .RB(\i_sg13cmos5l_dsa1_dig_core.rst_n ),
    .Q(\i_sg13cmos5l_dsa1_dig_core.rst_cnt[0] ));
 DFFRQX1 _24_ (.CK(clknet_1_1__leaf_clk_PAD2CORE_regs),
    .D(_02_),
    .RB(\i_sg13cmos5l_dsa1_dig_core.rst_n ),
    .Q(\i_sg13cmos5l_dsa1_dig_core.rst_cnt[1] ));
 DFFRQX1 _25_ (.CK(clknet_1_1__leaf_clk_PAD2CORE_regs),
    .D(_03_),
    .RB(\i_sg13cmos5l_dsa1_dig_core.rst_n ),
    .Q(\i_sg13cmos5l_dsa1_dig_core.rst_cnt[2] ));
 DFFRQX1 _26_ (.CK(clknet_1_0__leaf_clk_PAD2CORE_regs),
    .D(_04_),
    .RB(\i_sg13cmos5l_dsa1_dig_core.rst_n ),
    .Q(\i_sg13cmos5l_dsa1_dig_core.rst_cnt[3] ));
 DFFRQX1 _27_ (.CK(clknet_1_1__leaf_clk_PAD2CORE_regs),
    .D(_00_),
    .RB(\i_sg13cmos5l_dsa1_dig_core.rst_n ),
    .Q(\i_sg13cmos5l_dsa1_dig_core.data_in_s1 ));
 DFFRQX1 _28_ (.CK(clknet_1_1__leaf_clk_PAD2CORE_regs),
    .D(_01_),
    .RB(\i_sg13cmos5l_dsa1_dig_core.rst_n ),
    .Q(\i_sg13cmos5l_dsa1_dig_core.rst_done ));
 DFFRQX1 _29_ (.CK(clknet_1_0__leaf_clk_PAD2CORE_regs),
    .D(net1),
    .RB(\i_sg13cmos5l_dsa1_dig_core.rst_n ),
    .Q(\i_sg13cmos5l_dsa1_dig_core.data_in_s2 ));
 DFFRQX1 _30_ (.CK(clknet_1_0__leaf_clk_PAD2CORE_regs),
    .D(net2),
    .RB(\i_sg13cmos5l_dsa1_dig_core.rst_n ),
    .Q(\i_sg13cmos5l_dsa1_dig_core.data_in_s3 ));
 sg13cmos5l_ip__clamp_vddvss clamp_vdda ();
 sg13cmos5l_ip__clamp_vddvss clamp_vddvss ();
 sg13cmos5l_IOPadIn clk_pad (.p2c(clk_PAD2CORE),
    .pad(clk_PAD));
 BUFX12 clkbuf_0_clk_PAD2CORE (.Y(clknet_0_clk_PAD2CORE),
    .A(clk_PAD2CORE));
 BUFX12 clkbuf_0_clk_PAD2CORE_regs (.Y(clknet_0_clk_PAD2CORE_regs),
    .A(clk_PAD2CORE_regs));
 BUFX12 clkbuf_1_0__f_clk_PAD2CORE (.Y(clknet_1_0__leaf_clk_PAD2CORE),
    .A(clknet_0_clk_PAD2CORE));
 BUFX12 clkbuf_1_0__f_clk_PAD2CORE_regs (.Y(clknet_1_0__leaf_clk_PAD2CORE_regs),
    .A(clknet_0_clk_PAD2CORE_regs));
 BUFX12 clkbuf_1_1__f_clk_PAD2CORE_regs (.Y(clknet_1_1__leaf_clk_PAD2CORE_regs),
    .A(clknet_0_clk_PAD2CORE_regs));
 BUFX12 clkbuf_regs_0_clk (.Y(clk_PAD2CORE_regs),
    .A(delaynet_9_clk));
 sg13cmos5l_ip__cut_vdd cut_vdd_e ();
 sg13cmos5l_ip__cut_vdd cut_vdd_s ();
 BUFX12 delaybuf_0_clk (.Y(delaynet_0_clk),
    .A(clk_PAD2CORE));
 BUFX12 delaybuf_1_clk (.Y(delaynet_1_clk),
    .A(delaynet_0_clk));
 BUFX12 delaybuf_2_clk (.Y(delaynet_2_clk),
    .A(delaynet_1_clk));
 BUFX12 delaybuf_3_clk (.Y(delaynet_3_clk),
    .A(delaynet_2_clk));
 BUFX12 delaybuf_4_clk (.Y(delaynet_4_clk),
    .A(delaynet_3_clk));
 BUFX12 delaybuf_5_clk (.Y(delaynet_5_clk),
    .A(delaynet_4_clk));
 BUFX12 delaybuf_6_clk (.Y(delaynet_6_clk),
    .A(delaynet_5_clk));
 BUFX12 delaybuf_7_clk (.Y(delaynet_7_clk),
    .A(delaynet_6_clk));
 BUFX12 delaybuf_8_clk (.Y(delaynet_8_clk),
    .A(delaynet_7_clk));
 BUFX12 delaybuf_9_clk (.Y(delaynet_9_clk),
    .A(delaynet_8_clk));
 sg13cmos5l_IOPadOut4mA do_q_b_pad (.c2p(dsm_do_q_b),
    .pad(do_q_b_PAD));
 sg13cmos5l_IOPadOut4mA do_q_pad (.c2p(dsm_do_q),
    .pad(do_q_PAD));
 dsm2_core dsm2 (.di_btest_en(\i_sg13cmos5l_dsa1_dig_core.o_bias_cfg[22] ),
    .di_clk(dsm_clk_PAD2CORE),
    .di_clk_sel(\i_sg13cmos5l_dsa1_dig_core.o_bias_cfg[11] ),
    .di_dith_en(\i_sg13cmos5l_dsa1_dig_core.o_bias_cfg[7] ),
    .di_ena(dsm_ena),
    .di_osc_en(\i_sg13cmos5l_dsa1_dig_core.o_bias_cfg[10] ),
    .di_qout_en(dsm_qout_en),
    .di_rst_b(dsm_rst_b),
    .di_vcm_ext(\i_sg13cmos5l_dsa1_dig_core.o_bias_cfg[23] ),
    .do_clk_osc(do_clk_osc),
    .do_osc_oe(do_osc_oe),
    .do_q(dsm_do_q),
    .do_q_b(dsm_do_q_b),
    .do_q_dec(dsm_do_q_dec),
    .ibias_test(ibias_test),
    .vcm(vcm),
    .vi(vi),
    .di_dith_amp({\i_sg13cmos5l_dsa1_dig_core.o_bias_cfg[9] ,
    \i_sg13cmos5l_dsa1_dig_core.o_bias_cfg[8] }),
    .di_trim({\i_sg13cmos5l_dsa1_dig_core.o_bias_cfg[6] ,
    \i_sg13cmos5l_dsa1_dig_core.o_bias_cfg[5] ,
    \i_sg13cmos5l_dsa1_dig_core.o_bias_cfg[4] ,
    \i_sg13cmos5l_dsa1_dig_core.o_bias_cfg[3] }));
 sg13cmos5l_IOPadInOut4mA dsm_clk_pad (.c2p(do_clk_osc),
    .c2p_en(do_osc_oe),
    .p2c(dsm_clk_PAD2CORE),
    .pad(dsm_clk_PAD));
 sg13cmos5l_IOPadIn \g_inputs[0].input_pad  (.p2c(\i_sg13cmos5l_dsa1_dig_core.data_in_pad ),
    .pad(input_PAD[0]));
 sg13cmos5l_IOPadIn \g_inputs[1].input_pad  (.p2c(\i_sg13cmos5l_dsa1_dig_core.sclk ),
    .pad(input_PAD[1]));
 sg13cmos5l_IOPadIn \g_inputs[2].input_pad  (.p2c(\i_sg13cmos5l_dsa1_dig_core.mosi ),
    .pad(input_PAD[2]));
 sg13cmos5l_IOPadIn \g_inputs[3].input_pad  (.p2c(\i_sg13cmos5l_dsa1_dig_core.ss ),
    .pad(input_PAD[3]));
 sg13cmos5l_IOPadIOVdd \g_iovdd_pads[0].iovdd_pad  ();
 sg13cmos5l_IOPadIOVdd \g_iovdd_pads[1].iovdd_pad  ();
 sg13cmos5l_IOPadIOVss \g_iovss_pads[0].iovss_pad  ();
 sg13cmos5l_IOPadOut30mA \g_outputs[0].output_pad  (.c2p(\i_sg13cmos5l_dsa1_dig_core.miso ),
    .pad(output_PAD[0]));
 sg13cmos5l_IOPadOut30mA \g_outputs[1].output_pad  (.c2p(\i_sg13cmos5l_dsa1_dig_core.output_out[1] ),
    .pad(output_PAD[1]));
 sg13cmos5l_IOPadVdd \g_vdd_pads[0].vdd_pad  ();
 sg13cmos5l_IOPadVss \g_vss_pads[0].vss_pad  ();
 sg13cmos5l_IOPadVss \g_vss_pads[1].vss_pad  ();
 sg13cmos5l_ip__helm helm_art ();
 BUFX3 hold1 (.A(\i_sg13cmos5l_dsa1_dig_core.data_in_s1 ),
    .Y(net1));
 BUFX3 hold2 (.A(\i_sg13cmos5l_dsa1_dig_core.data_in_s2 ),
    .Y(net2));
 BUFX3 hold3 (.A(\i_sg13cmos5l_dsa1_dig_core.ss ),
    .Y(net3));
 dsa1_dig_top \i_sg13cmos5l_dsa1_dig_core.dsa1_dig  (.adc_conv(\i_sg13cmos5l_dsa1_dig_core.adc_conv ),
    .clk(clknet_1_0__leaf_clk_PAD2CORE),
    .data_in(\i_sg13cmos5l_dsa1_dig_core.data_in_s3 ),
    .miso(\i_sg13cmos5l_dsa1_dig_core.miso ),
    .mosi(\i_sg13cmos5l_dsa1_dig_core.mosi ),
    .rst_b(\i_sg13cmos5l_dsa1_dig_core.rst_n ),
    .sclk(\i_sg13cmos5l_dsa1_dig_core.sclk ),
    .ss(net3),
    .o_aux_ctrl({\i_sg13cmos5l_dsa1_dig_core.o_aux_ctrl[15] ,
    \i_sg13cmos5l_dsa1_dig_core.o_aux_ctrl[14] ,
    \i_sg13cmos5l_dsa1_dig_core.o_aux_ctrl[13] ,
    \i_sg13cmos5l_dsa1_dig_core.o_aux_ctrl[12] ,
    \i_sg13cmos5l_dsa1_dig_core.o_aux_ctrl[11] ,
    \i_sg13cmos5l_dsa1_dig_core.o_aux_ctrl[10] ,
    \i_sg13cmos5l_dsa1_dig_core.o_aux_ctrl[9] ,
    \i_sg13cmos5l_dsa1_dig_core.o_aux_ctrl[8] ,
    \i_sg13cmos5l_dsa1_dig_core.o_aux_ctrl[7] ,
    \i_sg13cmos5l_dsa1_dig_core.o_aux_ctrl[6] ,
    \i_sg13cmos5l_dsa1_dig_core.o_aux_ctrl[5] ,
    \i_sg13cmos5l_dsa1_dig_core.o_aux_ctrl[4] ,
    \i_sg13cmos5l_dsa1_dig_core.o_aux_ctrl[3] ,
    \i_sg13cmos5l_dsa1_dig_core.o_aux_ctrl[2] ,
    \i_sg13cmos5l_dsa1_dig_core.o_aux_ctrl[1] ,
    \i_sg13cmos5l_dsa1_dig_core.o_aux_ctrl[0] }),
    .o_bias_cfg({\i_sg13cmos5l_dsa1_dig_core.o_bias_cfg[34] ,
    \i_sg13cmos5l_dsa1_dig_core.o_bias_cfg[33] ,
    \i_sg13cmos5l_dsa1_dig_core.o_bias_cfg[32] ,
    \i_sg13cmos5l_dsa1_dig_core.o_bias_cfg[31] ,
    \i_sg13cmos5l_dsa1_dig_core.o_bias_cfg[30] ,
    \i_sg13cmos5l_dsa1_dig_core.o_bias_cfg[29] ,
    \i_sg13cmos5l_dsa1_dig_core.o_bias_cfg[28] ,
    \i_sg13cmos5l_dsa1_dig_core.o_bias_cfg[27] ,
    \i_sg13cmos5l_dsa1_dig_core.o_bias_cfg[26] ,
    \i_sg13cmos5l_dsa1_dig_core.o_bias_cfg[25] ,
    \i_sg13cmos5l_dsa1_dig_core.o_bias_cfg[24] ,
    \i_sg13cmos5l_dsa1_dig_core.o_bias_cfg[23] ,
    \i_sg13cmos5l_dsa1_dig_core.o_bias_cfg[22] ,
    \i_sg13cmos5l_dsa1_dig_core.o_bias_cfg[21] ,
    \i_sg13cmos5l_dsa1_dig_core.o_bias_cfg[20] ,
    \i_sg13cmos5l_dsa1_dig_core.o_bias_cfg[19] ,
    \i_sg13cmos5l_dsa1_dig_core.o_bias_cfg[18] ,
    \i_sg13cmos5l_dsa1_dig_core.o_bias_cfg[17] ,
    \i_sg13cmos5l_dsa1_dig_core.o_bias_cfg[16] ,
    \i_sg13cmos5l_dsa1_dig_core.o_bias_cfg[15] ,
    \i_sg13cmos5l_dsa1_dig_core.o_bias_cfg[14] ,
    \i_sg13cmos5l_dsa1_dig_core.o_bias_cfg[13] ,
    \i_sg13cmos5l_dsa1_dig_core.o_bias_cfg[12] ,
    \i_sg13cmos5l_dsa1_dig_core.o_bias_cfg[11] ,
    \i_sg13cmos5l_dsa1_dig_core.o_bias_cfg[10] ,
    \i_sg13cmos5l_dsa1_dig_core.o_bias_cfg[9] ,
    \i_sg13cmos5l_dsa1_dig_core.o_bias_cfg[8] ,
    \i_sg13cmos5l_dsa1_dig_core.o_bias_cfg[7] ,
    \i_sg13cmos5l_dsa1_dig_core.o_bias_cfg[6] ,
    \i_sg13cmos5l_dsa1_dig_core.o_bias_cfg[5] ,
    \i_sg13cmos5l_dsa1_dig_core.o_bias_cfg[4] ,
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
    \i_sg13cmos5l_dsa1_dig_core.o_uwb_tx_cfg[11] ,
    \i_sg13cmos5l_dsa1_dig_core.o_uwb_tx_cfg[10] ,
    \i_sg13cmos5l_dsa1_dig_core.o_uwb_tx_cfg[9] ,
    \i_sg13cmos5l_dsa1_dig_core.o_uwb_tx_cfg[8] ,
    \i_sg13cmos5l_dsa1_dig_core.o_uwb_tx_cfg[7] ,
    \i_sg13cmos5l_dsa1_dig_core.o_uwb_tx_cfg[6] ,
    \i_sg13cmos5l_dsa1_dig_core.o_uwb_tx_cfg[5] ,
    \i_sg13cmos5l_dsa1_dig_core.o_uwb_tx_cfg[4] ,
    \i_sg13cmos5l_dsa1_dig_core.o_uwb_tx_cfg[3] ,
    \i_sg13cmos5l_dsa1_dig_core.o_uwb_tx_cfg[2] ,
    \i_sg13cmos5l_dsa1_dig_core.o_uwb_tx_cfg[1] ,
    \i_sg13cmos5l_dsa1_dig_core.o_uwb_tx_cfg[0] }));
 AND2X1 \i_sg13cmos5l_dsa1_dig_core.u_adc_conv_gate  (.B(\i_sg13cmos5l_dsa1_dig_core.o_bias_cfg[25] ),
    .A(\i_sg13cmos5l_dsa1_dig_core.adc_conv ),
    .Y(\i_sg13cmos5l_dsa1_dig_core.output_out[1] ));
 AND2X1 \i_sg13cmos5l_dsa1_dig_core.u_dec_src_gate  (.B(\i_sg13cmos5l_dsa1_dig_core.o_bias_cfg[21] ),
    .A(dsm_do_q_dec),
    .Y(\i_sg13cmos5l_dsa1_dig_core.dsm_bit ));
 sg13cmos5l_IOPadAnalog ib_pad (.pad(analog_PAD[2]),
    .padres(ibias_test));
 sg13cmos5l_ip__jku jku_logo ();
 sg13cmos5l_ip__jku_names jku_names ();
 sg13cmos5l_IOPadIn rst_n_pad (.p2c(\i_sg13cmos5l_dsa1_dig_core.rst_n ),
    .pad(rst_n_PAD));
 sg13cmos5l_ip__title title_art ();
 sg13cmos5l_IOPadAnalog vcm_pad (.pad(analog_PAD[1]),
    .padres(vcm));
 decap_vdda vdda_decap ();
 sg13cmos5l_IOPadVdd vdda_pad ();
 sg13cmos5l_IOPadAnalog vi_pad (.pad(analog_PAD[0]),
    .padres(vi));
endmodule
