michaelk99/IHP__MPC9724/netlist/pnl/sg13cmos5l_dsa1_dig_top.pnl.v

module sg13cmos5l_dsa1_dig_top (clk_PAD,
    do_q_PAD,
    do_q_b_PAD,
    dsm_clk_PAD,
    rst_n_PAD,
    VSS,
    VDDA,
    VDD,
    IOVSS,
    IOVDD,
    analog_PAD,
    input_PAD,
    output_PAD);
 inout clk_PAD;
 inout do_q_PAD;
 inout do_q_b_PAD;
 inout dsm_clk_PAD;
 inout rst_n_PAD;
 inout VSS;
 inout VDDA;
 inout VDD;
 inout IOVSS;
 inout IOVDD;
 inout [2:0] analog_PAD;
 inout [3:0] input_PAD;
 inout [1:0] output_PAD;

 wire _00_;
 wire _01_;
 wire _02_;
 wire _03_;
 wire _04_;
 wire _05_;
 wire _06_;
 wire _07_;
 wire _08_;
 wire _09_;
 wire clk_PAD2CORE;
 wire do_clk_osc;
 wire do_osc_oe;
 wire dsm_clk_PAD2CORE;
 wire dsm_do_q;
 wire dsm_do_q_b;
 wire dsm_do_q_dec;
 wire dsm_ena;
 wire dsm_qout_en;
 wire dsm_rst_b;
 wire \i_sg13cmos5l_dsa1_dig_core.adc_conv ;
 wire \i_sg13cmos5l_dsa1_dig_core.data_in_pad ;
 wire \i_sg13cmos5l_dsa1_dig_core.data_in_s1 ;
 wire \i_sg13cmos5l_dsa1_dig_core.data_in_s2 ;
 wire \i_sg13cmos5l_dsa1_dig_core.data_in_s3 ;
 wire \i_sg13cmos5l_dsa1_dig_core.dsm_bit ;
 wire \i_sg13cmos5l_dsa1_dig_core.miso ;
 wire \i_sg13cmos5l_dsa1_dig_core.mosi ;
 wire \i_sg13cmos5l_dsa1_dig_core.o_aux_ctrl[0] ;
 wire \i_sg13cmos5l_dsa1_dig_core.o_aux_ctrl[10] ;
 wire \i_sg13cmos5l_dsa1_dig_core.o_aux_ctrl[11] ;
 wire \i_sg13cmos5l_dsa1_dig_core.o_aux_ctrl[12] ;
 wire \i_sg13cmos5l_dsa1_dig_core.o_aux_ctrl[13] ;
 wire \i_sg13cmos5l_dsa1_dig_core.o_aux_ctrl[14] ;
 wire \i_sg13cmos5l_dsa1_dig_core.o_aux_ctrl[15] ;
 wire \i_sg13cmos5l_dsa1_dig_core.o_aux_ctrl[1] ;
 wire \i_sg13cmos5l_dsa1_dig_core.o_aux_ctrl[2] ;
 wire \i_sg13cmos5l_dsa1_dig_core.o_aux_ctrl[3] ;
 wire \i_sg13cmos5l_dsa1_dig_core.o_aux_ctrl[4] ;
 wire \i_sg13cmos5l_dsa1_dig_core.o_aux_ctrl[5] ;
 wire \i_sg13cmos5l_dsa1_dig_core.o_aux_ctrl[6] ;
 wire \i_sg13cmos5l_dsa1_dig_core.o_aux_ctrl[7] ;
 wire \i_sg13cmos5l_dsa1_dig_core.o_aux_ctrl[8] ;
 wire \i_sg13cmos5l_dsa1_dig_core.o_aux_ctrl[9] ;
 wire \i_sg13cmos5l_dsa1_dig_core.o_bias_cfg[0] ;
 wire \i_sg13cmos5l_dsa1_dig_core.o_bias_cfg[10] ;
 wire \i_sg13cmos5l_dsa1_dig_core.o_bias_cfg[11] ;
 wire \i_sg13cmos5l_dsa1_dig_core.o_bias_cfg[12] ;
 wire \i_sg13cmos5l_dsa1_dig_core.o_bias_cfg[13] ;
 wire \i_sg13cmos5l_dsa1_dig_core.o_bias_cfg[14] ;
 wire \i_sg13cmos5l_dsa1_dig_core.o_bias_cfg[15] ;
 wire \i_sg13cmos5l_dsa1_dig_core.o_bias_cfg[16] ;
 wire \i_sg13cmos5l_dsa1_dig_core.o_bias_cfg[17] ;
 wire \i_sg13cmos5l_dsa1_dig_core.o_bias_cfg[18] ;
 wire \i_sg13cmos5l_dsa1_dig_core.o_bias_cfg[19] ;
 wire \i_sg13cmos5l_dsa1_dig_core.o_bias_cfg[1] ;
 wire \i_sg13cmos5l_dsa1_dig_core.o_bias_cfg[20] ;
 wire \i_sg13cmos5l_dsa1_dig_core.o_bias_cfg[21] ;
 wire \i_sg13cmos5l_dsa1_dig_core.o_bias_cfg[22] ;
 wire \i_sg13cmos5l_dsa1_dig_core.o_bias_cfg[23] ;
 wire \i_sg13cmos5l_dsa1_dig_core.o_bias_cfg[24] ;
 wire \i_sg13cmos5l_dsa1_dig_core.o_bias_cfg[25] ;
 wire \i_sg13cmos5l_dsa1_dig_core.o_bias_cfg[26] ;
 wire \i_sg13cmos5l_dsa1_dig_core.o_bias_cfg[27] ;
 wire \i_sg13cmos5l_dsa1_dig_core.o_bias_cfg[28] ;
 wire \i_sg13cmos5l_dsa1_dig_core.o_bias_cfg[29] ;
 wire \i_sg13cmos5l_dsa1_dig_core.o_bias_cfg[2] ;
 wire \i_sg13cmos5l_dsa1_dig_core.o_bias_cfg[30] ;
 wire \i_sg13cmos5l_dsa1_dig_core.o_bias_cfg[31] ;
 wire \i_sg13cmos5l_dsa1_dig_core.o_bias_cfg[32] ;
 wire \i_sg13cmos5l_dsa1_dig_core.o_bias_cfg[33] ;
 wire \i_sg13cmos5l_dsa1_dig_core.o_bias_cfg[34] ;
 wire \i_sg13cmos5l_dsa1_dig_core.o_bias_cfg[3] ;
 wire \i_sg13cmos5l_dsa1_dig_core.o_bias_cfg[4] ;
 wire \i_sg13cmos5l_dsa1_dig_core.o_bias_cfg[5] ;
 wire \i_sg13cmos5l_dsa1_dig_core.o_bias_cfg[6] ;
 wire \i_sg13cmos5l_dsa1_dig_core.o_bias_cfg[7] ;
 wire \i_sg13cmos5l_dsa1_dig_core.o_bias_cfg[8] ;
 wire \i_sg13cmos5l_dsa1_dig_core.o_bias_cfg[9] ;
 wire \i_sg13cmos5l_dsa1_dig_core.o_clk_cfg[0] ;
 wire \i_sg13cmos5l_dsa1_dig_core.o_clk_cfg[10] ;
 wire \i_sg13cmos5l_dsa1_dig_core.o_clk_cfg[11] ;
 wire \i_sg13cmos5l_dsa1_dig_core.o_clk_cfg[12] ;
 wire \i_sg13cmos5l_dsa1_dig_core.o_clk_cfg[13] ;
 wire \i_sg13cmos5l_dsa1_dig_core.o_clk_cfg[14] ;
 wire \i_sg13cmos5l_dsa1_dig_core.o_clk_cfg[15] ;
 wire \i_sg13cmos5l_dsa1_dig_core.o_clk_cfg[16] ;
 wire \i_sg13cmos5l_dsa1_dig_core.o_clk_cfg[17] ;
 wire \i_sg13cmos5l_dsa1_dig_core.o_clk_cfg[18] ;
 wire \i_sg13cmos5l_dsa1_dig_core.o_clk_cfg[1] ;
 wire \i_sg13cmos5l_dsa1_dig_core.o_clk_cfg[2] ;
 wire \i_sg13cmos5l_dsa1_dig_core.o_clk_cfg[3] ;
 wire \i_sg13cmos5l_dsa1_dig_core.o_clk_cfg[4] ;
 wire \i_sg13cmos5l_dsa1_dig_core.o_clk_cfg[5] ;
 wire \i_sg13cmos5l_dsa1_dig_core.o_clk_cfg[6] ;
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
 INVX1 _10_ (.Y(dsm_qout_en),
    .VSS(VSS),
    .A(\i_sg13cmos5l_dsa1_dig_core.o_bias_cfg[24] ),
    .VDD(VDD));
 INVX1 _11_ (.Y(dsm_ena),
    .VSS(VSS),
    .A(\i_sg13cmos5l_dsa1_dig_core.o_bias_cfg[19] ),
    .VDD(VDD));
 NOR2X1 _12_ (.A(\i_sg13cmos5l_dsa1_dig_core.rst_cnt[1] ),
    .Y(_06_),
    .B(\i_sg13cmos5l_dsa1_dig_core.rst_cnt[2] ),
    .VDD(VDD),
    .VSS(VSS));
 AO31X1 _13_ (.VDD(VDD),
    .A(\i_sg13cmos5l_dsa1_dig_core.rst_cnt[0] ),
    .B(\i_sg13cmos5l_dsa1_dig_core.rst_cnt[3] ),
    .C(_06_),
    .D(\i_sg13cmos5l_dsa1_dig_core.rst_done ),
    .VSS(VSS),
    .Y(_01_));
 NOR2BX1 _14_ (.AB(\i_sg13cmos5l_dsa1_dig_core.rst_done ),
    .Y(dsm_rst_b),
    .B(\i_sg13cmos5l_dsa1_dig_core.o_bias_cfg[20] ),
    .VDD(VDD),
    .VSS(VSS));
 MUX2X1 _15_ (.A0(\i_sg13cmos5l_dsa1_dig_core.data_in_pad ),
    .A1(\i_sg13cmos5l_dsa1_dig_core.dsm_bit ),
    .S0(\i_sg13cmos5l_dsa1_dig_core.o_bias_cfg[21] ),
    .VDD(VDD),
    .VSS(VSS),
    .Y(_00_));
 AND3BX1 _16_ (.AB(\i_sg13cmos5l_dsa1_dig_core.rst_done ),
    .B(\i_sg13cmos5l_dsa1_dig_core.rst_cnt[1] ),
    .C(\i_sg13cmos5l_dsa1_dig_core.rst_cnt[0] ),
    .VDD(VDD),
    .VSS(VSS),
    .Y(_07_));
 AOI2B1X1 _17_ (.Y(_08_),
    .VSS(VSS),
    .VDD(VDD),
    .C(\i_sg13cmos5l_dsa1_dig_core.rst_cnt[1] ),
    .B(\i_sg13cmos5l_dsa1_dig_core.rst_cnt[0] ),
    .AB(\i_sg13cmos5l_dsa1_dig_core.rst_done ));
 NOR2X1 _18_ (.A(_07_),
    .Y(_02_),
    .B(_08_),
    .VDD(VDD),
    .VSS(VSS));
 NAND4BX1 _19_ (.AB(\i_sg13cmos5l_dsa1_dig_core.rst_done ),
    .B(\i_sg13cmos5l_dsa1_dig_core.rst_cnt[2] ),
    .C(\i_sg13cmos5l_dsa1_dig_core.rst_cnt[1] ),
    .D(\i_sg13cmos5l_dsa1_dig_core.rst_cnt[0] ),
    .VDD(VDD),
    .VSS(VSS),
    .Y(_09_));
 XOR2X1 _20_ (.A(\i_sg13cmos5l_dsa1_dig_core.rst_cnt[2] ),
    .B(_07_),
    .VDD(VDD),
    .VSS(VSS),
    .Y(_03_));
 XNOR2X1 _21_ (.A(\i_sg13cmos5l_dsa1_dig_core.rst_cnt[3] ),
    .B(_09_),
    .VDD(VDD),
    .VSS(VSS),
    .Y(_04_));
 XNOR2X1 _22_ (.A(\i_sg13cmos5l_dsa1_dig_core.rst_cnt[0] ),
    .B(\i_sg13cmos5l_dsa1_dig_core.rst_done ),
    .VDD(VDD),
    .VSS(VSS),
    .Y(_05_));
 DFFRQX1 _23_ (.CK(clknet_1_0__leaf_clk_PAD2CORE_regs),
    .D(_05_),
    .RB(\i_sg13cmos5l_dsa1_dig_core.rst_n ),
    .Q(\i_sg13cmos5l_dsa1_dig_core.rst_cnt[0] ),
    .VDD(VDD),
    .VSS(VSS));
 DFFRQX1 _24_ (.CK(clknet_1_1__leaf_clk_PAD2CORE_regs),
    .D(_02_),
    .RB(\i_sg13cmos5l_dsa1_dig_core.rst_n ),
    .Q(\i_sg13cmos5l_dsa1_dig_core.rst_cnt[1] ),
    .VDD(VDD),
    .VSS(VSS));
 DFFRQX1 _25_ (.CK(clknet_1_1__leaf_clk_PAD2CORE_regs),
    .D(_03_),
    .RB(\i_sg13cmos5l_dsa1_dig_core.rst_n ),
    .Q(\i_sg13cmos5l_dsa1_dig_core.rst_cnt[2] ),
    .VDD(VDD),
    .VSS(VSS));
 DFFRQX1 _26_ (.CK(clknet_1_0__leaf_clk_PAD2CORE_regs),
    .D(_04_),
    .RB(\i_sg13cmos5l_dsa1_dig_core.rst_n ),
    .Q(\i_sg13cmos5l_dsa1_dig_core.rst_cnt[3] ),
    .VDD(VDD),
    .VSS(VSS));
 DFFRQX1 _27_ (.CK(clknet_1_1__leaf_clk_PAD2CORE_regs),
    .D(_00_),
    .RB(\i_sg13cmos5l_dsa1_dig_core.rst_n ),
    .Q(\i_sg13cmos5l_dsa1_dig_core.data_in_s1 ),
    .VDD(VDD),
    .VSS(VSS));
 DFFRQX1 _28_ (.CK(clknet_1_1__leaf_clk_PAD2CORE_regs),
    .D(_01_),
    .RB(\i_sg13cmos5l_dsa1_dig_core.rst_n ),
    .Q(\i_sg13cmos5l_dsa1_dig_core.rst_done ),
    .VDD(VDD),
    .VSS(VSS));
 DFFRQX1 _29_ (.CK(clknet_1_0__leaf_clk_PAD2CORE_regs),
    .D(net1),
    .RB(\i_sg13cmos5l_dsa1_dig_core.rst_n ),
    .Q(\i_sg13cmos5l_dsa1_dig_core.data_in_s2 ),
    .VDD(VDD),
    .VSS(VSS));
 DFFRQX1 _30_ (.CK(clknet_1_0__leaf_clk_PAD2CORE_regs),
    .D(net2),
    .RB(\i_sg13cmos5l_dsa1_dig_core.rst_n ),
    .Q(\i_sg13cmos5l_dsa1_dig_core.data_in_s3 ),
    .VDD(VDD),
    .VSS(VSS));
 sg13cmos5l_ip__clamp_vddvss clamp_vdda (.iovdd(IOVDD),
    .iovss(IOVSS),
    .vdd(VDDA),
    .vss(VSS));
 sg13cmos5l_ip__clamp_vddvss clamp_vddvss (.iovdd(IOVDD),
    .iovss(IOVSS),
    .vdd(VDD),
    .vss(VSS));
 sg13cmos5l_IOPadIn clk_pad (.iovdd(IOVDD),
    .iovss(IOVSS),
    .p2c(clk_PAD2CORE),
    .pad(clk_PAD),
    .vdd(VDD),
    .vss(VSS));
 BUFX12 clkbuf_0_clk_PAD2CORE (.Y(clknet_0_clk_PAD2CORE),
    .VDD(VDD),
    .VSS(VSS),
    .A(clk_PAD2CORE));
 BUFX12 clkbuf_0_clk_PAD2CORE_regs (.Y(clknet_0_clk_PAD2CORE_regs),
    .VDD(VDD),
    .VSS(VSS),
    .A(clk_PAD2CORE_regs));
 BUFX12 clkbuf_1_0__f_clk_PAD2CORE (.Y(clknet_1_0__leaf_clk_PAD2CORE),
    .VDD(VDD),
    .VSS(VSS),
    .A(clknet_0_clk_PAD2CORE));
 BUFX12 clkbuf_1_0__f_clk_PAD2CORE_regs (.Y(clknet_1_0__leaf_clk_PAD2CORE_regs),
    .VDD(VDD),
    .VSS(VSS),
    .A(clknet_0_clk_PAD2CORE_regs));
 BUFX12 clkbuf_1_1__f_clk_PAD2CORE_regs (.Y(clknet_1_1__leaf_clk_PAD2CORE_regs),
    .VDD(VDD),
    .VSS(VSS),
    .A(clknet_0_clk_PAD2CORE_regs));
 BUFX12 clkbuf_regs_0_clk (.Y(clk_PAD2CORE_regs),
    .VDD(VDD),
    .VSS(VSS),
    .A(delaynet_9_clk));
 sg13cmos5l_ip__cut_vdd cut_vdd_e (.iovdd(IOVDD),
    .iovss(IOVSS),
    .vss(VSS));
 sg13cmos5l_ip__cut_vdd cut_vdd_s (.iovdd(IOVDD),
    .iovss(IOVSS),
    .vss(VSS));
 BUFX12 delaybuf_0_clk (.Y(delaynet_0_clk),
    .VDD(VDD),
    .VSS(VSS),
    .A(clk_PAD2CORE));
 BUFX12 delaybuf_1_clk (.Y(delaynet_1_clk),
    .VDD(VDD),
    .VSS(VSS),
    .A(delaynet_0_clk));
 BUFX12 delaybuf_2_clk (.Y(delaynet_2_clk),
    .VDD(VDD),
    .VSS(VSS),
    .A(delaynet_1_clk));
 BUFX12 delaybuf_3_clk (.Y(delaynet_3_clk),
    .VDD(VDD),
    .VSS(VSS),
    .A(delaynet_2_clk));
 BUFX12 delaybuf_4_clk (.Y(delaynet_4_clk),
    .VDD(VDD),
    .VSS(VSS),
    .A(delaynet_3_clk));
 BUFX12 delaybuf_5_clk (.Y(delaynet_5_clk),
    .VDD(VDD),
    .VSS(VSS),
    .A(delaynet_4_clk));
 BUFX12 delaybuf_6_clk (.Y(delaynet_6_clk),
    .VDD(VDD),
    .VSS(VSS),
    .A(delaynet_5_clk));
 BUFX12 delaybuf_7_clk (.Y(delaynet_7_clk),
    .VDD(VDD),
    .VSS(VSS),
    .A(delaynet_6_clk));
 BUFX12 delaybuf_8_clk (.Y(delaynet_8_clk),
    .VDD(VDD),
    .VSS(VSS),
    .A(delaynet_7_clk));
 BUFX12 delaybuf_9_clk (.Y(delaynet_9_clk),
    .VDD(VDD),
    .VSS(VSS),
    .A(delaynet_8_clk));
 sg13cmos5l_IOPadOut4mA do_q_b_pad (.c2p(dsm_do_q_b),
    .iovdd(IOVDD),
    .iovss(IOVSS),
    .pad(do_q_b_PAD),
    .vdd(VDDA),
    .vss(VSS));
 sg13cmos5l_IOPadOut4mA do_q_pad (.c2p(dsm_do_q),
    .iovdd(IOVDD),
    .iovss(IOVSS),
    .pad(do_q_PAD),
    .vdd(VDDA),
    .vss(VSS));
 dsm2_core dsm2 (.di_btest_en(\i_sg13cmos5l_dsa1_dig_core.o_bias_cfg[22] ),
    .di_clk(dsm_clk_PAD2CORE),
    .di_clk_sel(\i_sg13cmos5l_dsa1_dig_core.o_bias_cfg[11] ),
    .di_dith_en(\i_sg13cmos5l_dsa1_dig_core.o_bias_cfg[7] ),
    .di_ena(dsm_ena),
    .di_osc_en(\i_sg13cmos5l_dsa1_dig_core.o_bias_cfg[10] ),
    .di_qout_en(dsm_qout_en),
    .di_rst_b(dsm_rst_b),
    .di_vcm_ext(\i_sg13cmos5l_dsa1_dig_core.o_bias_cfg[23] ),
    .do_clk_osc(do_clk_osc),
    .do_osc_oe(do_osc_oe),
    .do_q(dsm_do_q),
    .do_q_b(dsm_do_q_b),
    .do_q_dec(dsm_do_q_dec),
    .ibias_test(ibias_test),
    .vcm(vcm),
    .vdd(VDDA),
    .vi(vi),
    .vss(VSS),
    .di_dith_amp({\i_sg13cmos5l_dsa1_dig_core.o_bias_cfg[9] ,
    \i_sg13cmos5l_dsa1_dig_core.o_bias_cfg[8] }),
    .di_trim({\i_sg13cmos5l_dsa1_dig_core.o_bias_cfg[6] ,
    \i_sg13cmos5l_dsa1_dig_core.o_bias_cfg[5] ,
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
