michaelk99/IHP__MPC9724/macros/decap_vdda/final/nl/decap_vdda.nl.v

module decap_vdda ();

 wire net;

 DECAPHV32 FILLER_0_0 ();
 DECAPHV8 FILLER_0_125 ();
 FILLER2 FILLER_0_133 ();
 DECAPHV32 FILLER_0_138 ();
 DECAPHV8 FILLER_0_170 ();
 FILLER2 FILLER_0_178 ();
 DECAPHV32 FILLER_0_183 ();
 DECAPHV8 FILLER_0_215 ();
 FILLER2 FILLER_0_223 ();
 DECAPHV32 FILLER_0_228 ();
 DECAPHV8 FILLER_0_260 ();
 FILLER2 FILLER_0_268 ();
 DECAPHV32 FILLER_0_273 ();
 DECAPHV8 FILLER_0_305 ();
 FILLER2 FILLER_0_313 ();
 DECAPHV16 FILLER_0_318 ();
 DECAPHV8 FILLER_0_32 ();
 DECAPHV8 FILLER_0_334 ();
 FILLER4 FILLER_0_342 ();
 FILLER4 FILLER_0_40 ();
 FILLER1 FILLER_0_44 ();
 DECAPHV32 FILLER_0_48 ();
 DECAPHV8 FILLER_0_80 ();
 FILLER2 FILLER_0_88 ();
 DECAPHV32 FILLER_0_93 ();
 DECAPHV32 FILLER_10_0 ();
 DECAPHV16 FILLER_10_113 ();
 DECAPHV8 FILLER_10_129 ();
 FILLER2 FILLER_10_137 ();
 DECAPHV32 FILLER_10_142 ();
 DECAPHV32 FILLER_10_174 ();
 DECAPHV16 FILLER_10_206 ();
 DECAPHV8 FILLER_10_222 ();
 FILLER2 FILLER_10_230 ();
 DECAPHV32 FILLER_10_235 ();
 DECAPHV32 FILLER_10_267 ();
 DECAPHV16 FILLER_10_299 ();
 DECAPHV8 FILLER_10_315 ();
 DECAPHV8 FILLER_10_32 ();
 FILLER2 FILLER_10_323 ();
 DECAPHV16 FILLER_10_328 ();
 FILLER2 FILLER_10_344 ();
 FILLER4 FILLER_10_40 ();
 FILLER2 FILLER_10_44 ();
 DECAPHV32 FILLER_10_49 ();
 DECAPHV32 FILLER_10_81 ();
 DECAPHV32 FILLER_11_0 ();
 DECAPHV32 FILLER_11_128 ();
 DECAPHV16 FILLER_11_160 ();
 DECAPHV8 FILLER_11_176 ();
 FILLER2 FILLER_11_184 ();
 DECAPHV32 FILLER_11_189 ();
 DECAPHV32 FILLER_11_221 ();
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
 WELLTAP TAP_TAPCELL_ROW_8_34 ();
 WELLTAP TAP_TAPCELL_ROW_90_318 ();
 WELLTAP TAP_TAPCELL_ROW_90_319 ();
 WELLTAP TAP_TAPCELL_ROW_90_320 ();
 WELLTAP TAP_TAPCELL_ROW_90_321 ();
 WELLTAP TAP_TAPCELL_ROW_91_322 ();
 WELLTAP TAP_TAPCELL_ROW_91_323 ();
 WELLTAP TAP_TAPCELL_ROW_91_324 ();
 WELLTAP TAP_TAPCELL_ROW_92_325 ();
 WELLTAP TAP_TAPCELL_ROW_92_326 ();
 WELLTAP TAP_TAPCELL_ROW_92_327 ();
 WELLTAP TAP_TAPCELL_ROW_92_328 ();
 WELLTAP TAP_TAPCELL_ROW_93_329 ();
 WELLTAP TAP_TAPCELL_ROW_93_330 ();
 WELLTAP TAP_TAPCELL_ROW_93_331 ();
 WELLTAP TAP_TAPCELL_ROW_93_332 ();
 WELLTAP TAP_TAPCELL_ROW_93_333 ();
 WELLTAP TAP_TAPCELL_ROW_93_334 ();
 WELLTAP TAP_TAPCELL_ROW_93_335 ();
 WELLTAP TAP_TAPCELL_ROW_9_35 ();
 WELLTAP TAP_TAPCELL_ROW_9_36 ();
 WELLTAP TAP_TAPCELL_ROW_9_37 ();
 INVX1 u_inv (.A(net));
 TIEHI u_inv_1 (.Y(net));
endmodule
