michaelk99/IHP__MPC9724/macros/decap_vdda/final/pnl/decap_vdda.pnl.v

module decap_vdda (VDD,
    VSS);
 inout VDD;
 inout VSS;

 wire net;

 DECAPHV32 FILLER_0_0 (.VDD(VDD),
    .VSS(VSS));
 DECAPHV8 FILLER_0_125 (.VDD(VDD),
    .VSS(VSS));
 FILLER2 FILLER_0_133 (.VSS(VSS),
    .VDD(VDD));
 DECAPHV32 FILLER_0_138 (.VDD(VDD),
    .VSS(VSS));
 DECAPHV8 FILLER_0_170 (.VDD(VDD),
    .VSS(VSS));
 FILLER2 FILLER_0_178 (.VSS(VSS),
    .VDD(VDD));
 DECAPHV32 FILLER_0_183 (.VDD(VDD),
    .VSS(VSS));
 DECAPHV8 FILLER_0_215 (.VDD(VDD),
    .VSS(VSS));
 FILLER2 FILLER_0_223 (.VSS(VSS),
    .VDD(VDD));
 DECAPHV32 FILLER_0_228 (.VDD(VDD),
    .VSS(VSS));
 DECAPHV8 FILLER_0_260 (.VDD(VDD),
    .VSS(VSS));
 FILLER2 FILLER_0_268 (.VSS(VSS),
    .VDD(VDD));
 DECAPHV32 FILLER_0_273 (.VDD(VDD),
    .VSS(VSS));
 DECAPHV8 FILLER_0_305 (.VDD(VDD),
    .VSS(VSS));
 FILLER2 FILLER_0_313 (.VSS(VSS),
    .VDD(VDD));
 DECAPHV16 FILLER_0_318 (.VDD(VDD),
    .VSS(VSS));
 DECAPHV8 FILLER_0_32 (.VDD(VDD),
    .VSS(VSS));
 DECAPHV8 FILLER_0_334 (.VDD(VDD),
    .VSS(VSS));
 FILLER4 FILLER_0_342 (.VDD(VDD),
    .VSS(VSS));
 FILLER4 FILLER_0_40 (.VDD(VDD),
    .VSS(VSS));
 FILLER1 FILLER_0_44 (.VDD(VDD),
    .VSS(VSS));
 DECAPHV32 FILLER_0_48 (.VDD(VDD),
    .VSS(VSS));
 DECAPHV8 FILLER_0_80 (.VDD(VDD),
    .VSS(VSS));
 FILLER2 FILLER_0_88 (.VSS(VSS),
    .VDD(VDD));
 DECAPHV32 FILLER_0_93 (.VDD(VDD),
    .VSS(VSS));
 DECAPHV32 FILLER_10_0 (.VDD(VDD),
    .VSS(VSS));
 DECAPHV16 FILLER_10_113 (.VDD(VDD),
    .VSS(VSS));
 DECAPHV8 FILLER_10_129 (.VDD(VDD),
    .VSS(VSS));
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
    .VSS(VSS));
 DECAPHV8 FILLER_49_176 (.VDD(VDD),
    .VSS(VSS));
 FILLER2 FILLER_49_184 (.VSS(VSS),
    .VDD(VDD));
 DECAPHV32 FILLER_49_189 (.VDD(VDD),
    .VSS(VSS));
 DECAPHV32 FILLER_49_221 (.VDD(VDD),
    .VSS(VSS));
 DECAPHV16 FILLER_49_253 (.VDD(VDD),
    .VSS(VSS));
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
