michaelk99/IHP__MPC9724/(commit log)

2026-10-25 Initial snapshot of sg13cmos5l_dsa1_dig for the IHP Open Source MPW
    The DSA1 digital back end and the dsm2 delta-sigma modulator on a 1.3 x 1.3 mm SG13CMOS5L die in a QFN24, a multi project carrier for the IHP Open Source MPW CMOS5L run of 2026-11-09. The design is in progress: dsm2_core is still a placeholder box. Snapshot of the development tree at 8d8e9a477f0c.
    [counter_top_tb_tran.csv, counter_top_tb_tran.sch, decimator_top_tb_tran.sch, dsa1_dig_top_tb_tran.sch, inverter.sch, inverter_tb_ac.csv, inverter_tb_ac.sch, inverter_tb_ac_ol.csv]
2026-10-25 ci: REUSE compliant again and the bench capture self-test reads the chip's reset
    Six generators write SPDX headers into their outputs, and REUSE read those string literals as malformed license expressions. They now sit between REUSE-IgnoreStart and REUSE-IgnoreEnd comments. analog_nets.txt, the dsm2_core placeholder GDS and the start-up bench README get their licensing in REUSE.toml.
    bench_capture.py's self-test still expected 0x90EA, the DSA1 die's BIAS_CFG_0 reset. Since the dsm2 overlay this chip resets it to 0x0024, so the test now takes the value from the register map.
    [regmap_gen.py]
2026-11-04 v1.2.0: the tape-out chip with dsm2's oscillator variant
    The delivery GDS is release/v.1.2.0/gds/MPC9724.gds.gz (top cell MPC9724). dsa1_dig is re-hardened at 409.08 x 514.08 um with VDD decap strips above and below it, decap_vdda adds 67.61 pF on VDDA, and the dsm_clk pad is an inout so dsm2's oscillator can drive it. Sign-off in doc/signoff.md, section "dsm2 oscillator variant integrated, 2026-11-02".
    [sg13cmos5l_dsa1_dig_top.sch]
2026-11-05 v1.2.1: dsm2 runs from power-up without an SPI write
    The chip glue inverts DSM_EN and DSM_QOUT_EN and holds di_rst_b for 137 to 153 us after rst_n by a clk counter, so dsm2 modulates and drives do_q and do_q_b after reset. Writing 1 turns each off. The delivery GDS is release/v.1.2.1/gds/MPC9724.gds.gz. Testability fixes in the docs and a bring-up procedure in doc/host_protocol.md. Sign-off in doc/signoff.md, section "dsm2 on by default, 2026-11-04".
    [dsm2_core_model.v, gen_startup.py, regmap.yaml, seq_core.sv, sg13cmos5l_dsa1_dig_core.sv]
2026-11-09 v1.2.1: records and docs after IHP's audit, GDS unchanged
    Synced from the design repo at 8e91fcf. Adds the signoff records, netlist labels, layout index and dsm2_core docs asked for in IHP's audit. The GDS is byte identical to v1.2.1.
    [bias_gm.sch, bias_trim.sch, cmfb_sc2.sch, dsm2_osc.sch, quantizer2_dith.sch, quantizer2_sal.sch, quantizer2_top.sch, sc_int2.sch]
2026-11-09 Records: IMAGE_ARM64 is the 2026-10-15 build with PDK a49358c
    The ARM64 pin was described as a second build of the 2026-10-08 image. It is the later :next build with PDK a49358c and newer Magic, OpenROAD, Yosys, Icarus and GHDL. The PDK differences reach no sign-off result, listed in doc/dsm2_integration.md section Tools.
2026-11-12 Tapeout status after the Magic flatten-flag recheck, two same-net M1.e in dsm2 declared
    Every Magic DRC verdict of v1.2.1 was rechecked for sak-drc.sh -f "*" (gds flatglob *), which makes Magic check an empty top cell. The chip-level counts ran without it. Two M1.e in dsm2's OTA are traced to the same net on both sides (vss, vdd) and named in the signoff audit table. Report in doc/tapeout_status.md, evidence in verification/drc/magic_recheck_2026-11-12/. Also synced: the release-check rerun in the official hpretl/iic-osic-tools:2026.10 image, shortened READMEs and corrected README statements. GDS unchanged, md5 7cf6da0e6ea7b6c2c473bff6e6093cd7.
2026-11-13 Remove the template archetypes and tutorial, retarget the regression to this chip
    Deleted macros/counter, macros/inverter, tutorial/ with its quarto workflow, the template chip bench sg13cmos5l_dsa1_dig_top_tb_tran.sch with its plot scripts, the dead sim-gl-xschem and sim-view-xschem targets, and LICENSES/MIT.txt, which only the counter used.
    Kept what other parts used: the gm/ID tables moved to ip/dsm2_core/sizing/data for the dsm2 sizing, and the start-up bench uses the identical spi2xspice.py of dsa1_dig.
    make regression now runs regression-dsa1-dig, regression-decimator and regression-top, which CI runs as parallel jobs. The macro parts lint, harden and check the views in flow/final ag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
    [counter_top_tb_tran.csv, counter_top_tb_tran.sch, inverter.sch, inverter_tb_ac.csv, inverter_tb_ac.sch, inverter_tb_ac_ol.csv, inverter_tb_ac_ol.sch, inverter_tb_dc_vout.csv]
2026-11-13 dsa1_dig cocotb bench for the VHDL macro, cocotb in both macro regressions
    The template counter bench read rtl/*.sv files that no longer exist. The new bench drives the macro ports and checks the reset values, write and read back with the port mapping of dsa1_ic_bus_slave, the adc_conv cadence, the decimator enable, data_in decimated bit-exact against the model at a fixed read lag, and full scale. 6 of 6 pass at RTL and at gate level on the committed netlist.
    sim-rtl-cocotb now builds rtl_gen first. sim-gl-cocotb passes FINAL_DIR in both macros, so the regression runs the gate-level cocotb on the fresh views in flow/final. The decimator bench reads FINAL_DIR too.
