michaelk99/IHP__MPC9724/(notices)

Notices in the files:
README.md:
License: Solderpad Hardware License v2.1
